robotronik/cdfr2018/Programmation/RobotrOvision/third_test/correct_highres.jpg

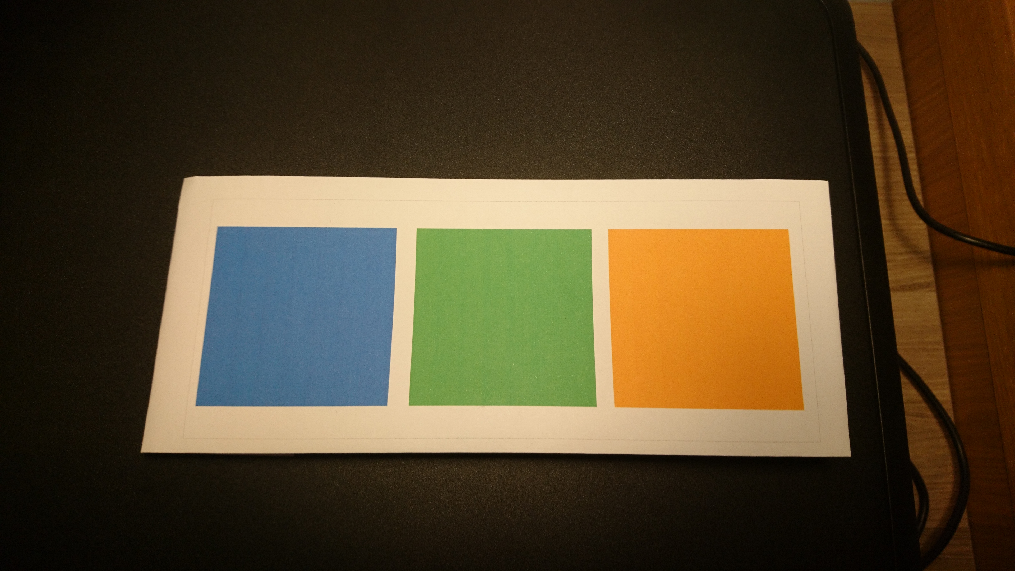
Programmation/RobotrOvision/third_test/correct_highres.jpg
