robotronik/cdfr2018/Programmation/RobotrOvision/third_test/incorrect_hd.jpg

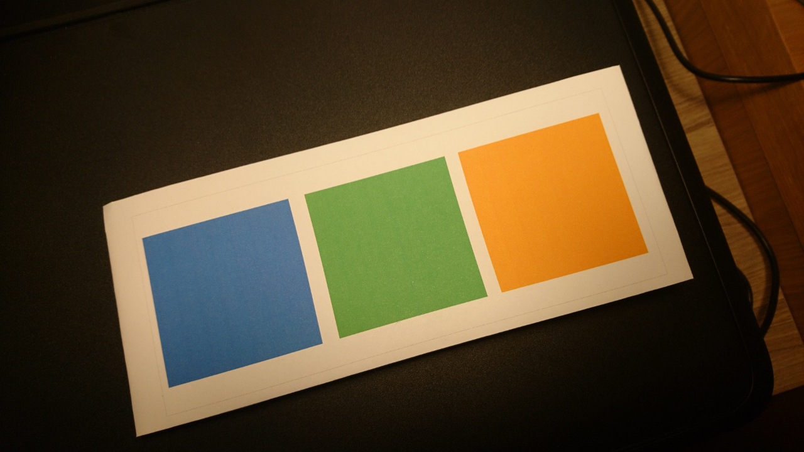
Programmation/RobotrOvision/third_test/incorrect_hd.jpg
