robotronik/cdfr2018/Programmation/Panneau_domotique/serveur/readme.md

Installation de l'ESP8266 sur l'IDE d'Arduino
---------------------------------------------

Dans Arduino > File > Preferences > Settings > Additional Boards Manager URLs, ajouter :
http://arduino.esp8266.com/stable/package_esp8266com_index.json

Puis ouvrir Tools > Board > Boards Manager
Chercher ESP8266 et installer esp8266 by ESP8266 Community

Enfin dans Tools > Board, sélectionner Generic ESP8266
