robotronik/cdfr2018/Programmation/Panneau_domotique/pixelbot/README.md

pixelbot
========

Pixelbot est un programme permettant de générer des sprites pour une 
matrice de leds, à partir d'une police de caractères.

Utilisation
-----------

1. Installer qt5
2. Lancer l'exécutable

Modification
------------

Pour compiler ou modifier le projet, il faut installer Qt Creator.
