robotronik/cdfr2018/Programmation/LED_Zone/graphic/background.jpg

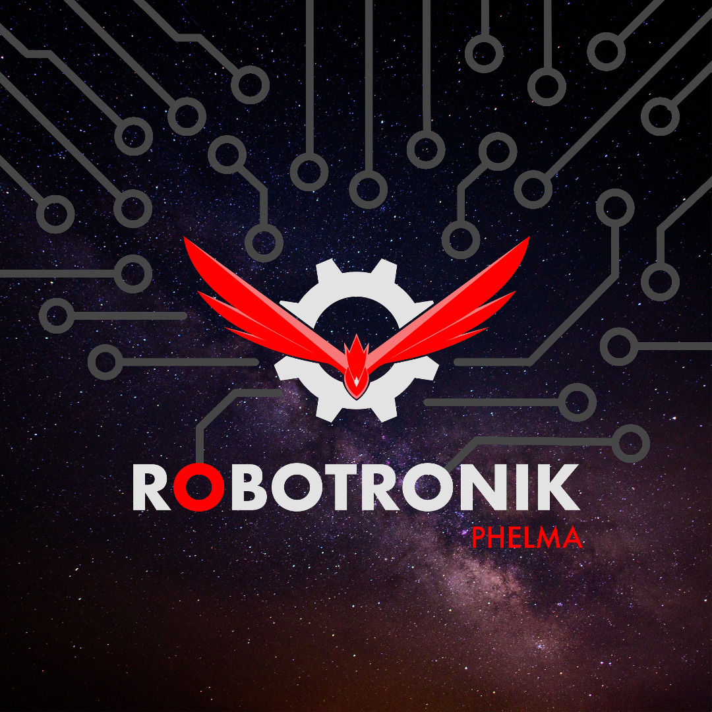
Programmation/LED_Zone/graphic/background.jpg
