robotronik/cdfr2018/Programmation/LED_Zone/graphic/tracks.png

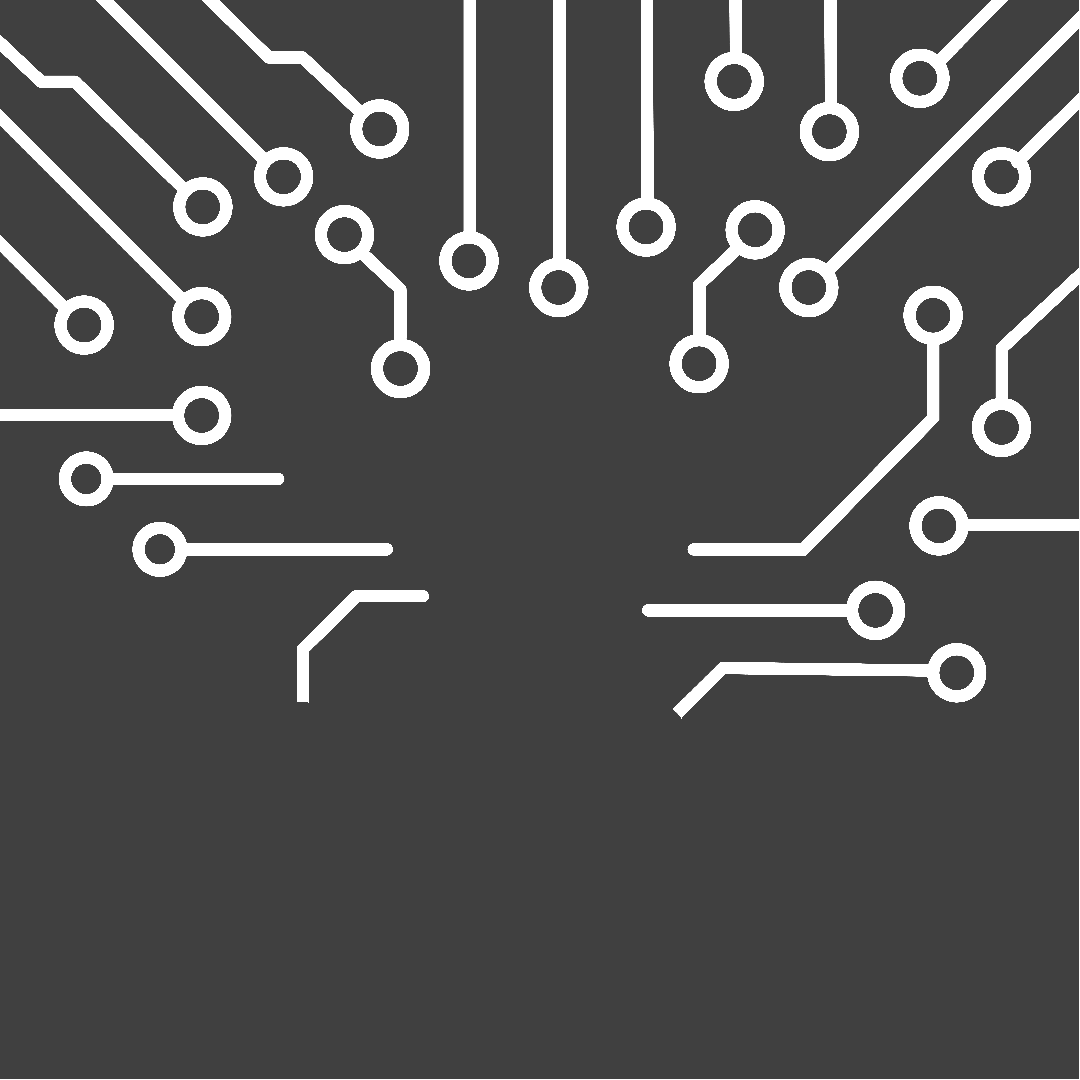
Programmation/LED_Zone/graphic/tracks.png
