robotronik/cdfr2018/Mecanique/Materiel_HPC.ods

qté | réf | description | url
4 | 10T5-15/ECO | poulie | https://shop.hpceurope.com/fr/produit.asp?prid=3936&lie=0&nav=3
4 | MET-3-6-4 | coussinets | https://shop.hpceurope.com/fr/produit.asp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
6 | METC-4-8-4 | coussinets | https://shop.hpceurope.com/fr/produit.asp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
1 | RSH030A | Arbre 3 | https://shop.hpceurope.com/fr/produit.asp?prid=1318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
1 | RSH040B | Arbre 4 | https://shop.hpceurope.com/fr/produit.asp?prid=1318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
2 | ZB0,8-20 | renvoi angle | https://shop.hpceurope.com/fr/produit.asp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
 |  | courroie
 | Q608 2rs | roulement
 |  | Arbre 8
