robotronik/cdfr2018/Mecanique/assemblage_global_avec_bras.fcstd

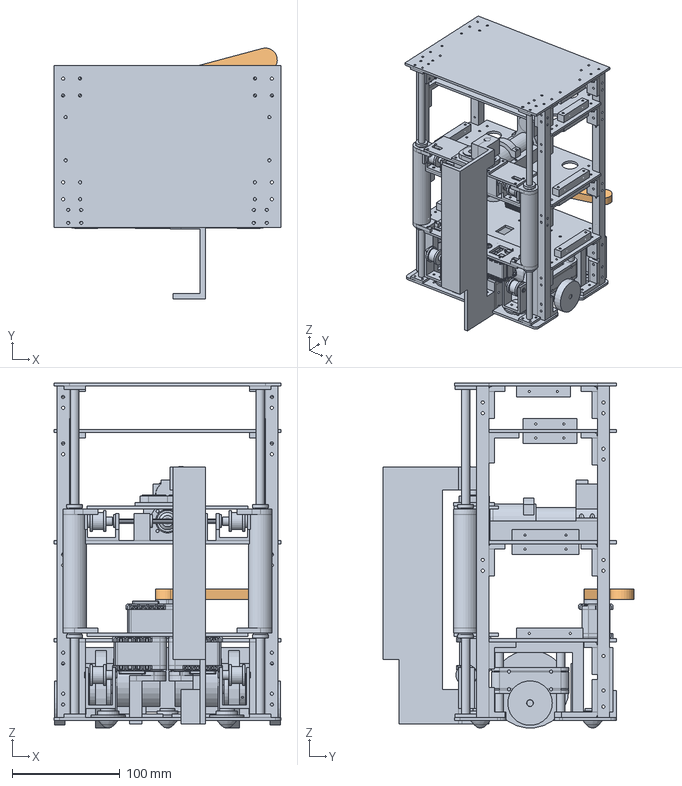
[picture p7: CAD file, 2018-02-14]
Mecanique/assemblage_global_avec_bras.fcstd
210.0 x 232.6 x 319.8 mm
assemblage_global_ne_pas_modifier_01
bras_01
