robotronik/cdfr2018/Mecanique/etage_elec/assemblage/assemblage_etage_elec.fcstd

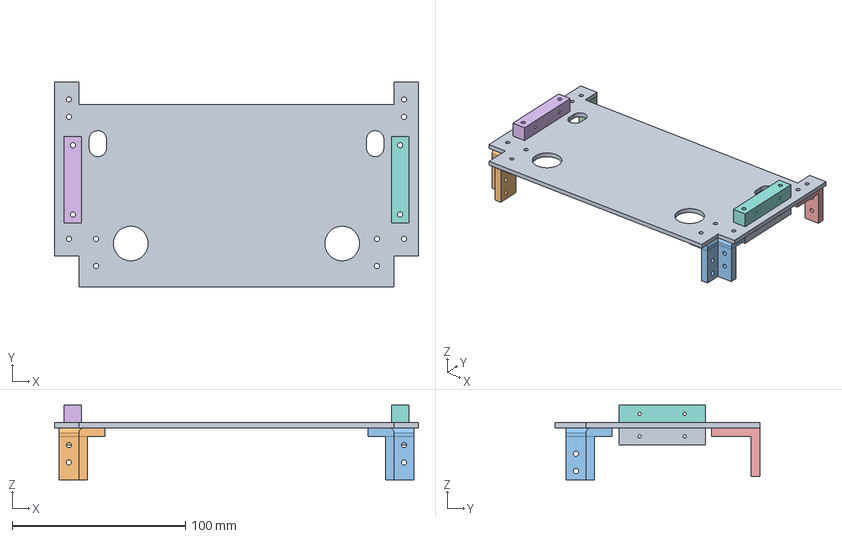
[picture p8: CAD file, 2017-11-16]
Mecanique/etage_elec/assemblage/assemblage_etage_elec.fcstd
210.0 x 118.1 x 43.0 mm
etage_elec_01
support_etage_1_01
support_etage_2_02
equerre_etage_elec_01
equerre_etage_elec_02
support_plexi_lateral_elec_01
support_plexi_lateral_elec_02
support_plexi_lateral_elec_03
support_plexi_lateral_elec_04
