robotronik/cdfr2018/Mecanique/toit/assemblage/assemblage_toit.fcstd

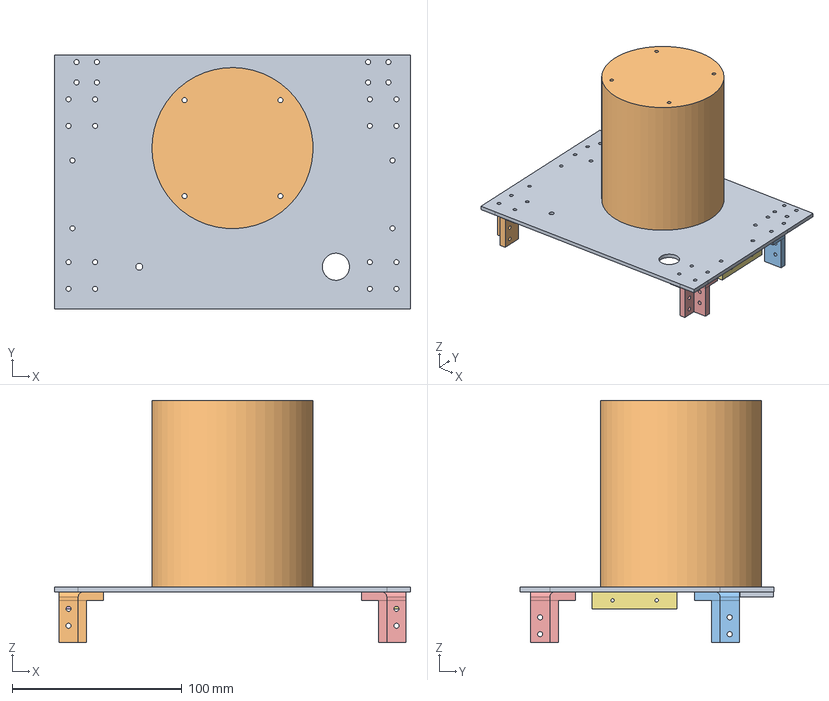
[picture p9: CAD file, 2018-01-14]
Mecanique/toit/assemblage/assemblage_toit.fcstd
210.0 x 150.0 x 143.0 mm
toit_01
support_etage_1_01
support_etage_1_02
support_etage_2_01
support_etage_2_02
support_plexi_lateral_elec_01
support_plexi_lateral_elec_02
calle_tige_01
calle_tige_01001
support_balise_01
