robotronik/cdfr2018/Mecanique/assemblage_global_ne_pas_modifier.fcstd

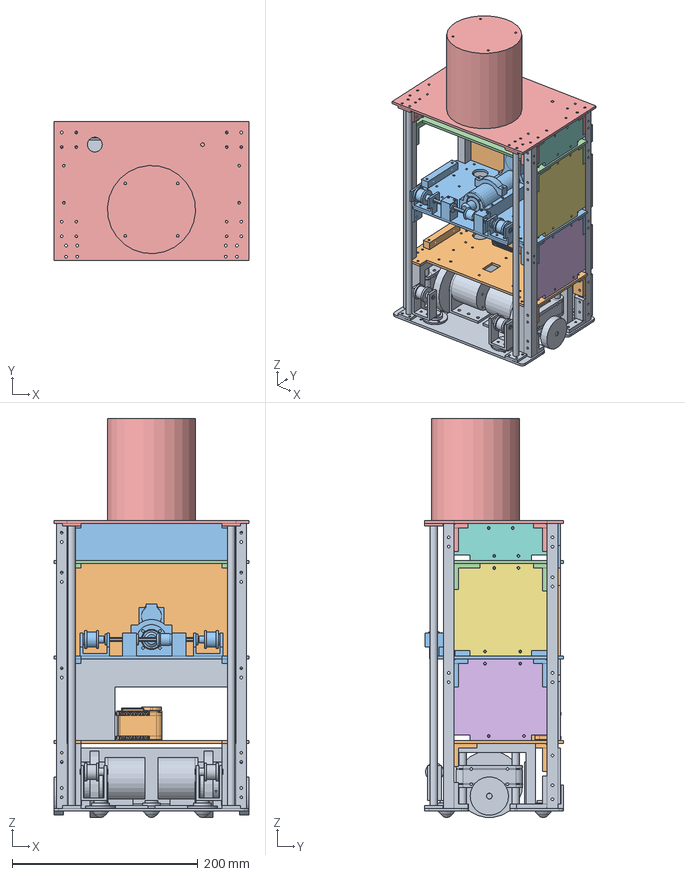
[picture p10: CAD file, 2018-01-15]
Mecanique/assemblage_global_ne_pas_modifier.fcstd
210.0 x 150.0 x 429.8 mm
base_roulante_01
_er_etage_01
etage_moteur_01
assemblage_etage_elec_01
assemblage_toit_01
lateral_1er_etage_01
lateral_moteur_01
lateral_elec_01
ar_1er_etage_01
ar_moteur_01
ar_elec_01
