robotronik/cdfr2018/Mecanique/Base/Assemblage/assemblage_poulie.fcstd

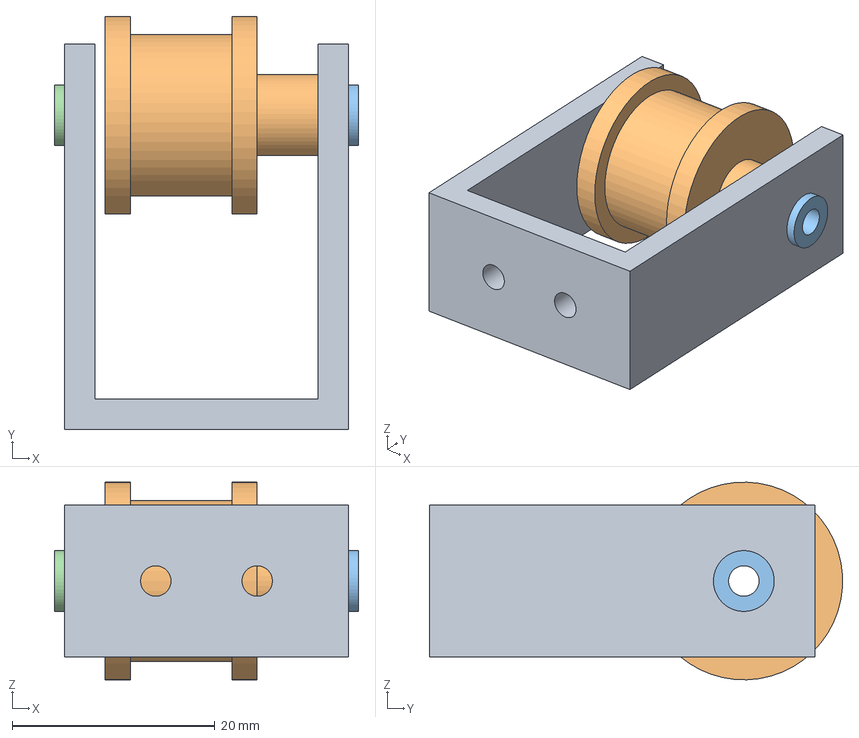
[picture p11: CAD file, 2017-11-04]
Mecanique/Base/Assemblage/assemblage_poulie.fcstd
30.0 x 40.7 x 19.5 mm
support_poulie_01
poulie_01
coussinet_3_01
coussinet_3_02
