robotronik/cdfr2018/Mecanique/etage_moteur/Assemblage/assemblage_moteur.fcstd

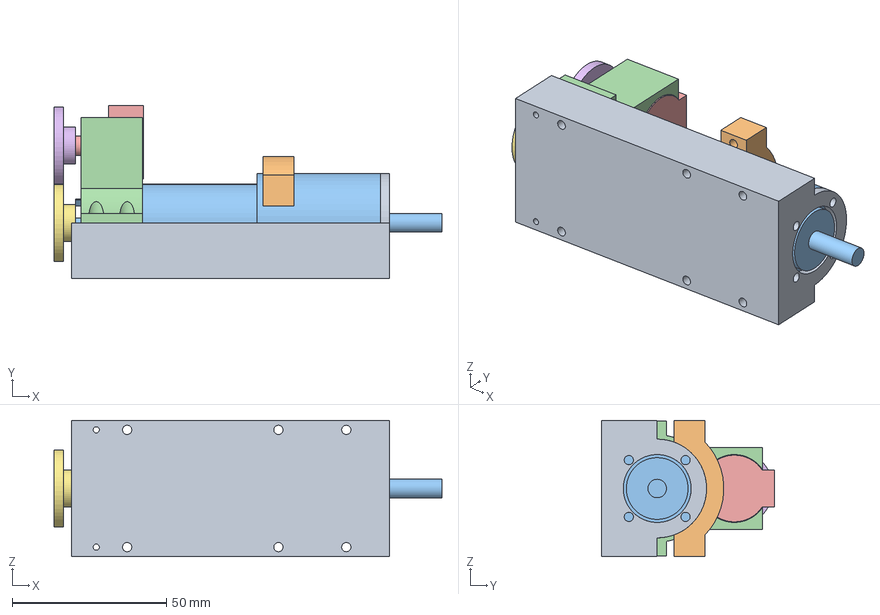
[picture p12: CAD file, 2017-11-12]
Mecanique/etage_moteur/Assemblage/assemblage_moteur.fcstd
125.7 x 56.0 x 44.1 mm
support_moteur_encodeur_01
bride_moteur_01
moteur_01
support_encodeur_01
encodeur_250_01
pignon_01
pignon_02
