robotronik/cdfr2018/Mecanique/Base/Assemblage/assemblage_bille.fcstd

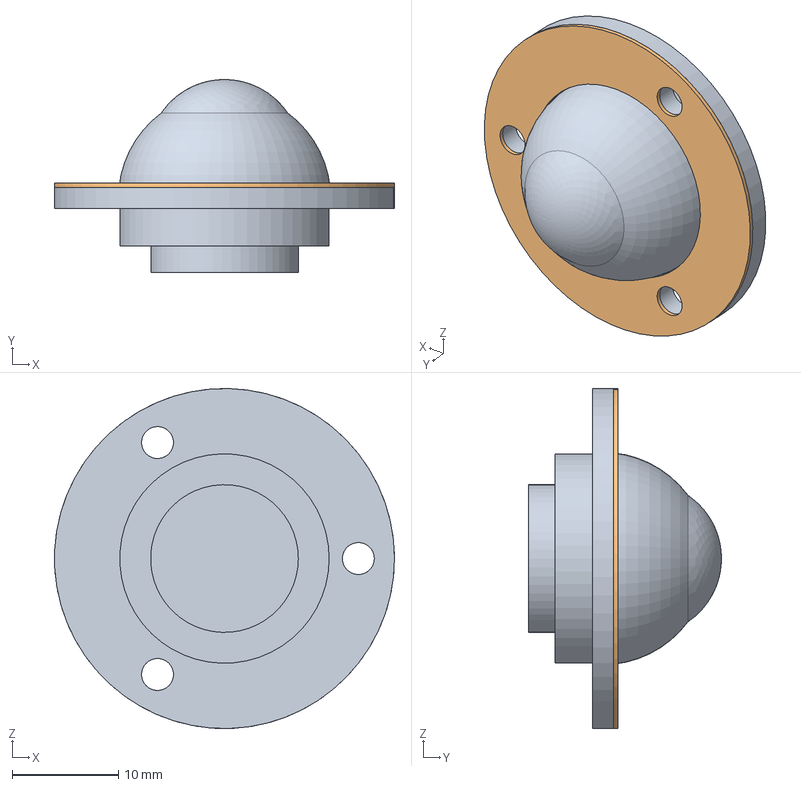
[picture p13: CAD file, 2017-10-30]
Mecanique/Base/Assemblage/assemblage_bille.fcstd
32.0 x 18.1 x 32.0 mm
bille_01
espaceur_bille_01
