robotronik/cdfr2018/Mecanique/etage_moteur/Assemblage/assemblage_support_coussinet.fcstd

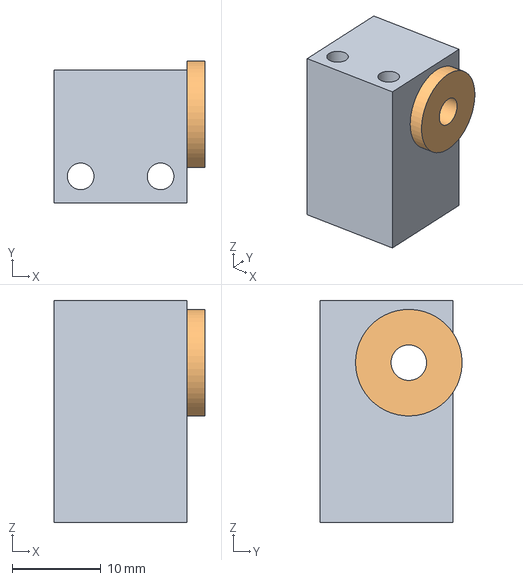
[picture p14: CAD file, 2017-11-07]
Mecanique/etage_moteur/Assemblage/assemblage_support_coussinet.fcstd
17.0 x 16.0 x 25.0 mm
support_coussinet_pignon_01
coussinet_01
