robotronik/cdfr2018/Mecanique/pince/assemblage_pince.fcstd

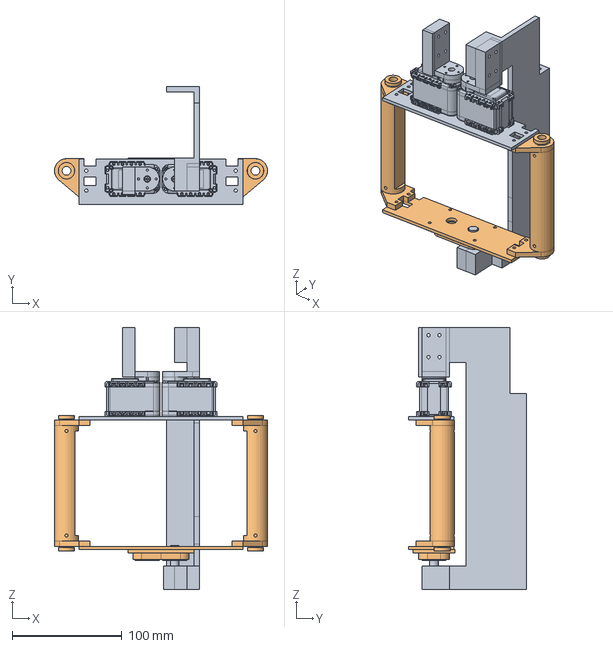
[picture p15: CAD file, 2017-12-31]
Mecanique/pince/assemblage_pince.fcstd
194.0 x 107.0 x 238.5 mm
ass_pince_bas_01
ass_pince_haut_01
