robotronik/cdfr2018/Mecanique/assemblage_global.fcstd

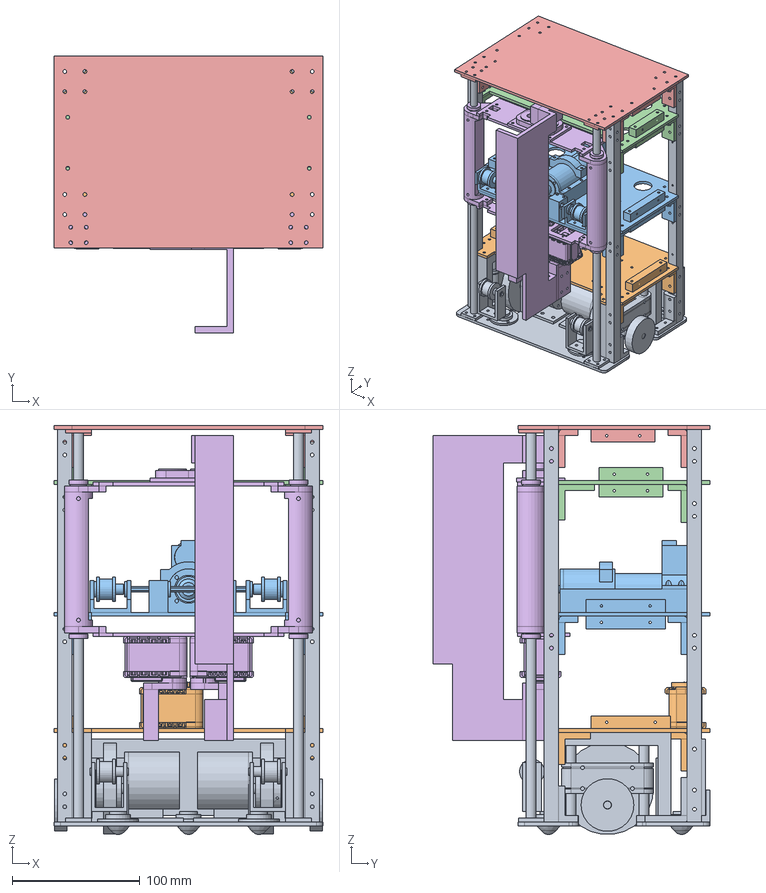
[picture p16: CAD file, 2017-12-31]
Mecanique/assemblage_global.fcstd
210.0 x 216.2 x 319.8 mm
base_roulante_01
_er_etage_01
etage_moteur_01
assemblage_etage_elec_01
assemblage_toit_01
assemblage_pince_01
