robotronik/cdfr2018/Mecanique/Base/Assemblage/assemblage_moteur.fcstd

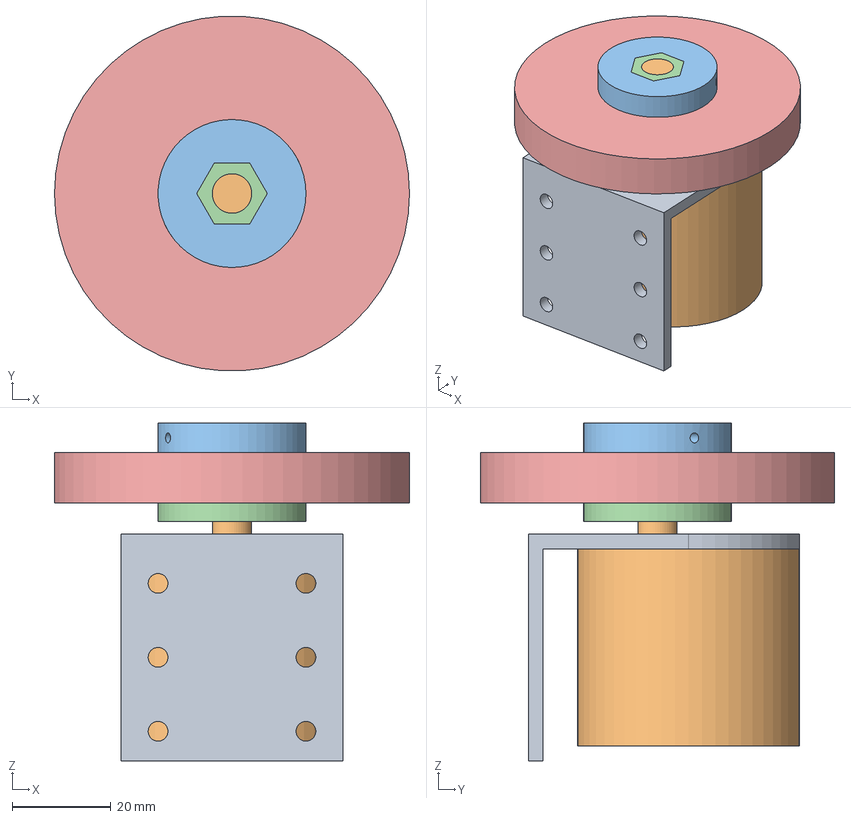
[picture p17: CAD file, 2017-10-29]
Mecanique/Base/Assemblage/assemblage_moteur.fcstd
72.0 x 71.9 x 68.5 mm
support_moteur_01
moteur_b_01
couplage_roue_2_01
couplage_roue_01
roue_bleue_01
