robotronik/cdfr2018/Mecanique/1er_etage/1er_etage.fcstd

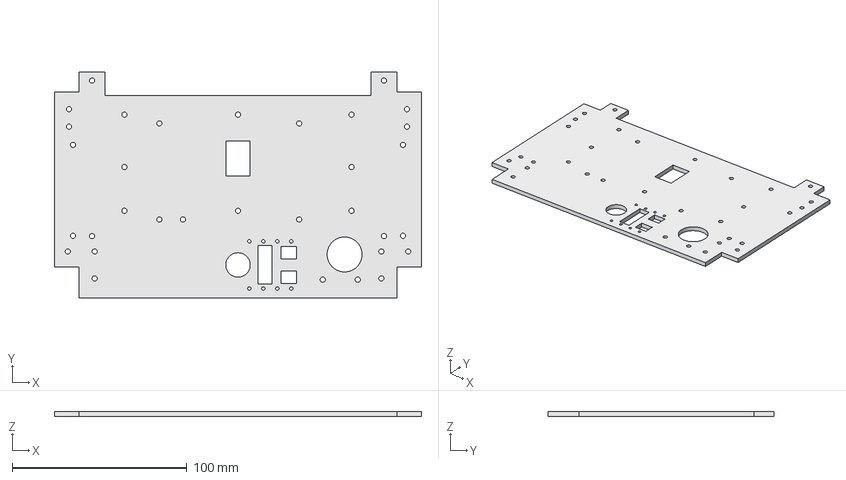
[picture p18: CAD file, 2018-01-14]
Mecanique/1er_etage/1er_etage.fcstd
210.0 x 129.5 x 3.00 mm
