robotronik/cdfr2018/Mecanique/1er_etage/Assemblage/1er_etage.fcstd

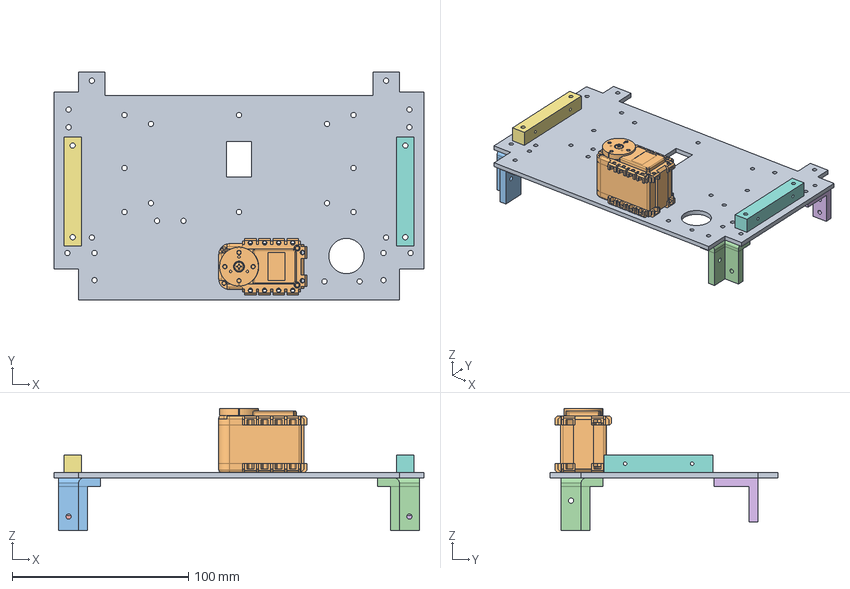
[picture p19: CAD file, 2017-12-15]
Mecanique/1er_etage/Assemblage/1er_etage.fcstd
210.0 x 129.5 x 69.4 mm
_er_etage_01
comp_ax12_01
support_profiles_ar_1_01
support_profiles_ar_2_01
support_profiles_av_01
support_profiles_av_02
support_plexi_lateral_01
support_plexi_lateral_02
