robotronik/cdfr2018/Mecanique/Abeille/Assemblage/abeille.fcstd

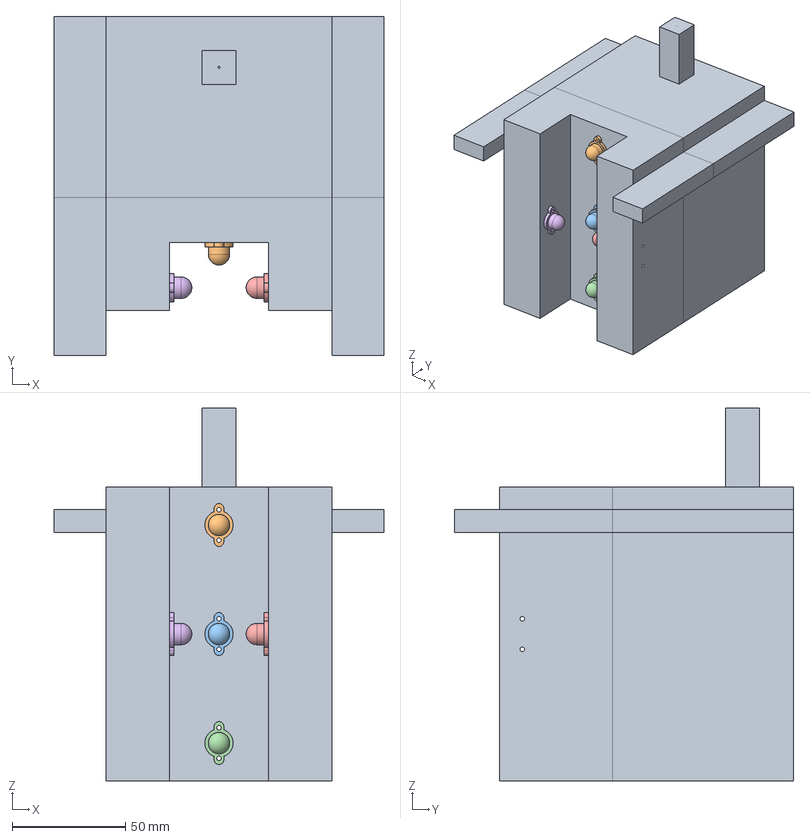
[picture p20: CAD file, 2018-01-13]
Mecanique/Abeille/Assemblage/abeille.fcstd
146.0 x 150.0 x 165.0 mm
structure_abeille_01
bille_01
bille_02
bille_03
bille_04
bille_05
