robotronik/cdfr2018/Mecanique/Abeille/structure_abeille_bas.fcstd

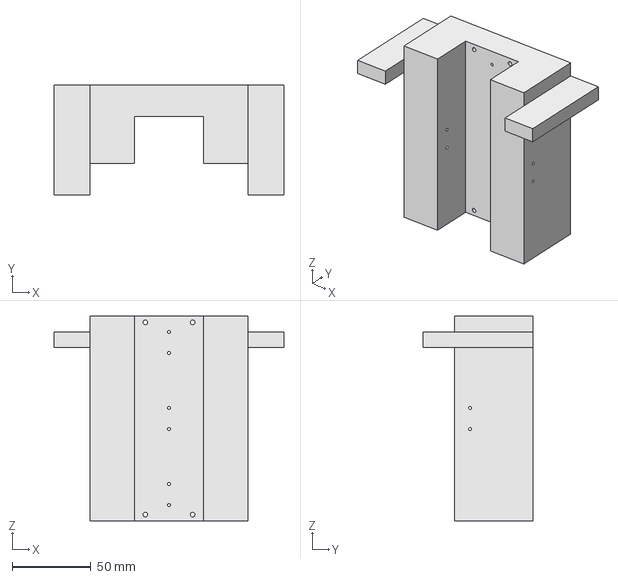
[picture p21: CAD file, 2018-02-28]
Mecanique/Abeille/structure_abeille_bas.fcstd
146.0 x 70.0 x 130.0 mm
