robotronik/cdfr2018/Mecanique/Adaptateur/4vers6.fcstd

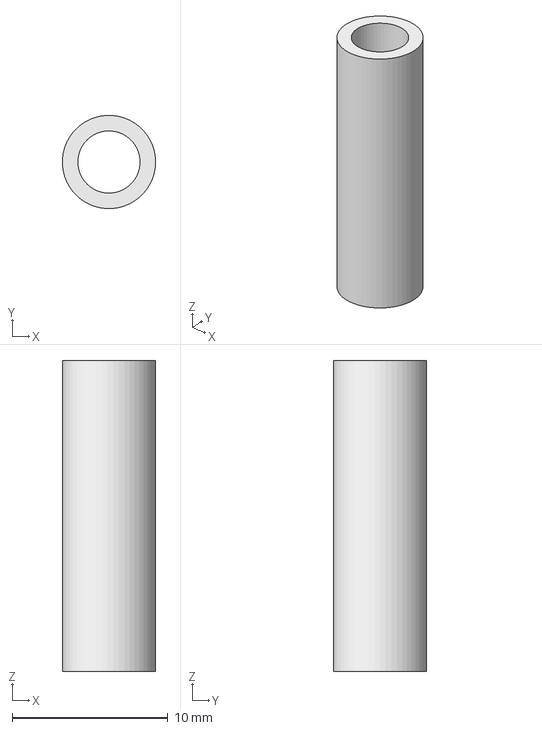
[picture p22: CAD file, 2018-01-14]
Mecanique/Adaptateur/4vers6.fcstd
5.99 x 6.00 x 20.0 mm
