robotronik/cdfr2018/Mecanique/ax12/AX-12A.STEP

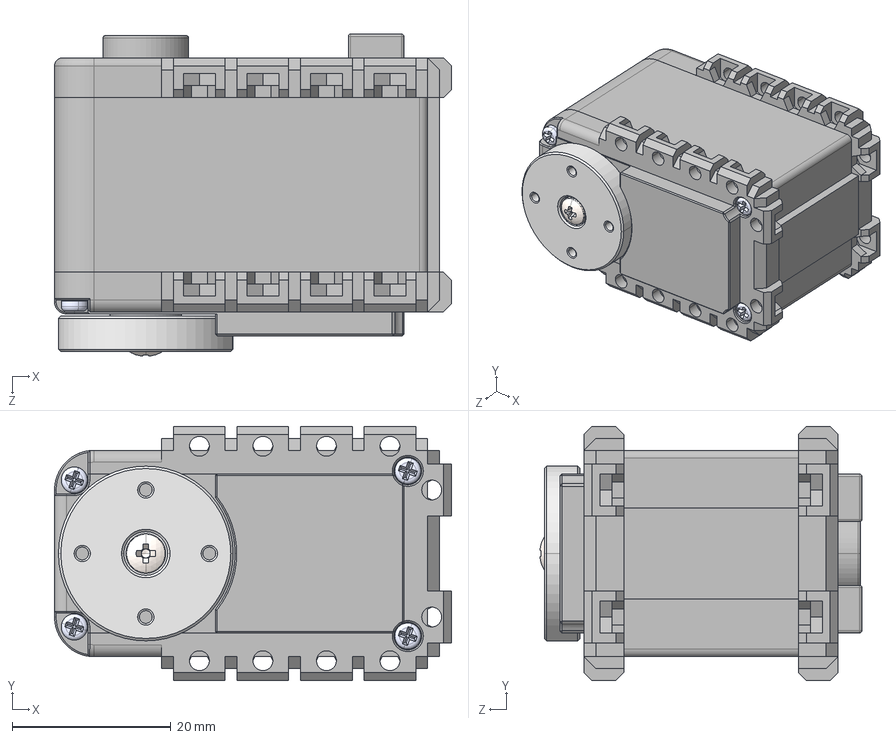
[picture p23: CAD file, 2017-10-31]
Mecanique/ax12/AX-12A.STEP
50.0 x 32.0 x 40.5 mm
AX-12A-01
AX-12A-02
AX-12A-03
AX-12A-04
SetScrew x 4
pan head cross recess screw_iso_ISO 7045 - M2.5 x 8 - Z --- 8C
