robotronik/cdfr2018/Mecanique/Base/Assemblage/base_roulante.fcstd

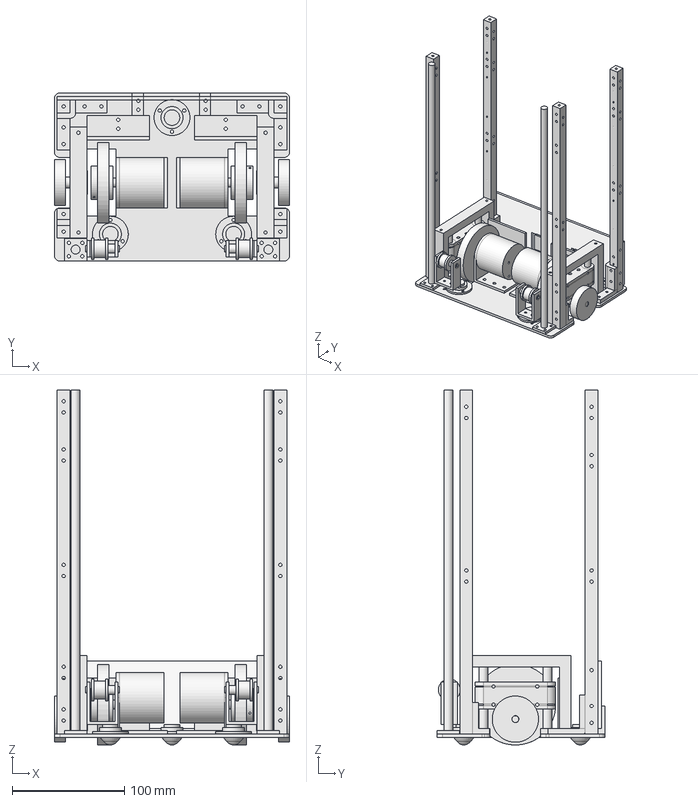
[picture p24: CAD file, 2017-11-16]
Mecanique/Base/Assemblage/base_roulante.fcstd
210.0 x 150.0 x 316.8 mm
base_01
assemblage_moteur_01
assemblage_moteur_02
odometre_01
odometre_02
assemblage_bille_01
profile_ar_1_01
profile_ar_2_01
support_batterie_01
support_batterie_02
support_batterie_2_01
support_batterie_2_02
calle_tige_01
tige_pince_01
calle_tige_01001
tige_pince_02
profile_av_01
profile_av_02
bouclier_batterie_01
assemblage_bille_02
assemblage_bille_03
assemblage_poulie_01
assemblage_poulie_02
