robotronik/cdfr2018/Mecanique/Base/couplage_roue_modif.fcstd

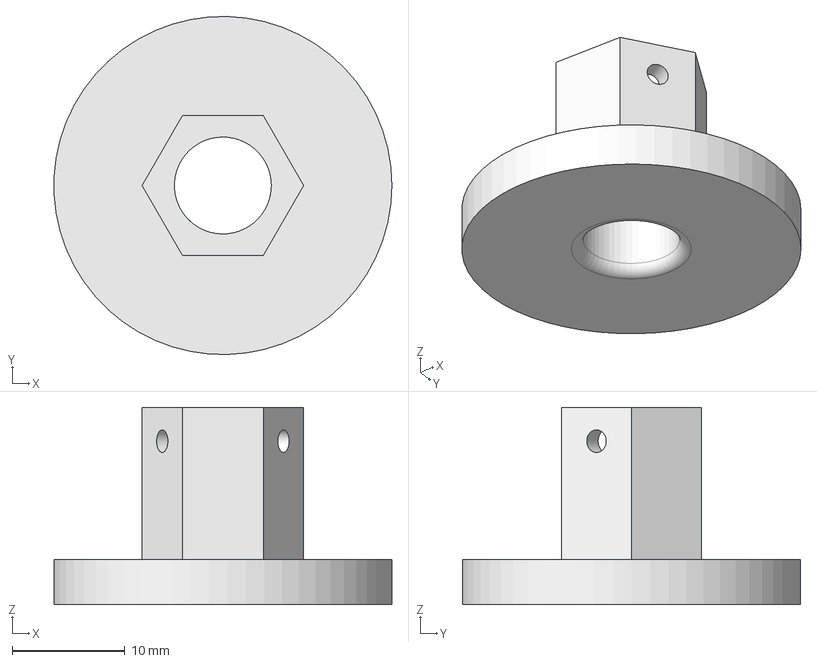
[picture p25: CAD file, 2018-01-22]
Mecanique/Base/couplage_roue_modif.fcstd
30.0 x 30.0 x 17.5 mm
