robotronik/cdfr2018/Mecanique/Base/Odometrie/barre_encodeur_modif2.fcstd

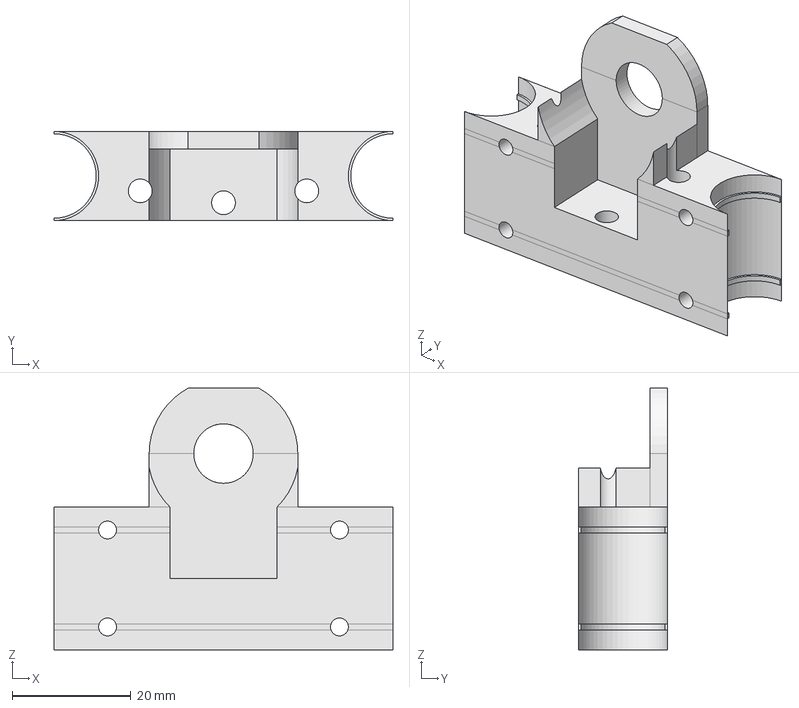
[picture p26: CAD file, 2017-12-19]
Mecanique/Base/Odometrie/barre_encodeur_modif2.fcstd
57.0 x 15.0 x 44.0 mm
