robotronik/cdfr2018/Mecanique/Base/Profiles/Assemblage/profile_ar_2.fcstd

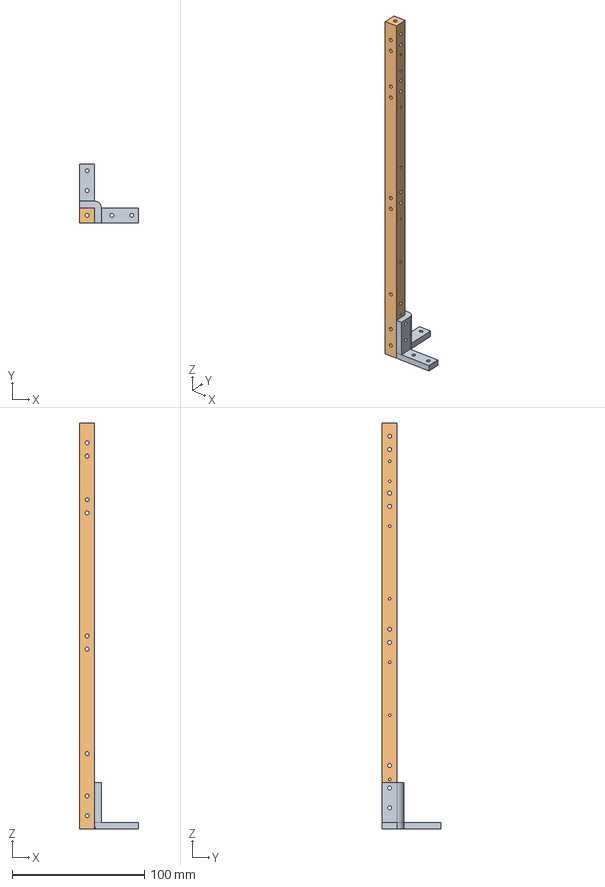
[picture p27: CAD file, 2017-11-16]
Mecanique/Base/Profiles/Assemblage/profile_ar_2.fcstd
44.4 x 44.4 x 307.0 mm
support_bas_ar_p_2_01
Profile_AR_01
