robotronik/cdfr2018/Mecanique/Base/Profiles/Profile_AR.fcstd

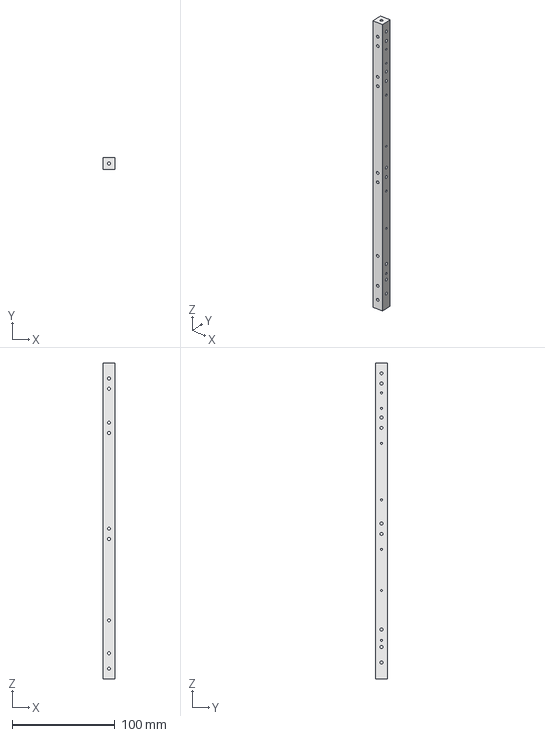
[picture p28: CAD file, 2017-11-16]
Mecanique/Base/Profiles/Profile_AR.fcstd
11.4 x 11.4 x 307.0 mm
