robotronik/cdfr2018/Mecanique/Bras_abeille_panneau/bras_grand.fcstd

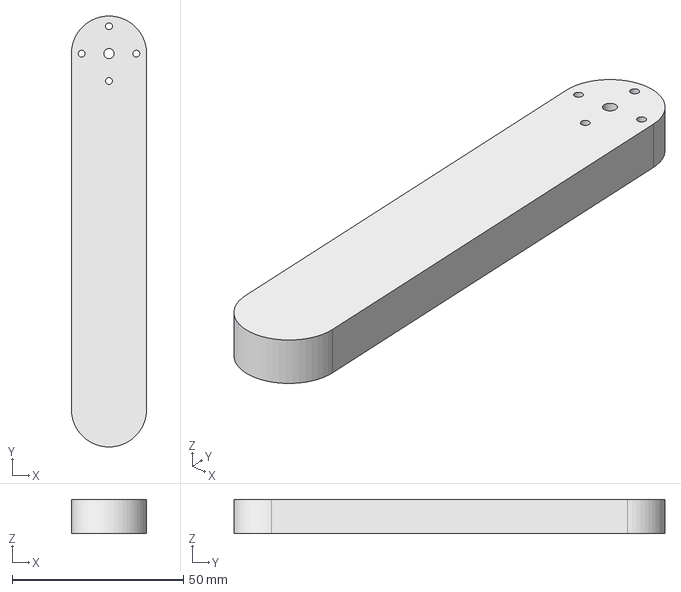
[picture p29: CAD file, 2018-01-13]
Mecanique/Bras_abeille_panneau/bras_grand.fcstd
22.0 x 126.0 x 10.0 mm
