robotronik/cdfr2018/Mecanique/Capteurs/encodeur_236.fcstd

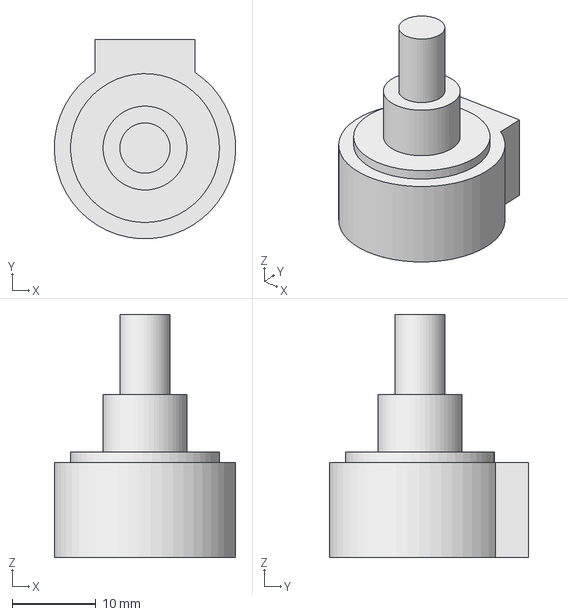
[picture p30: CAD file, 2017-10-29]
Mecanique/Capteurs/encodeur_236.fcstd
21.6 x 23.7 x 29.0 mm
