robotronik/cdfr2018/Mecanique/Douilles/douille_a_bille.fcstd

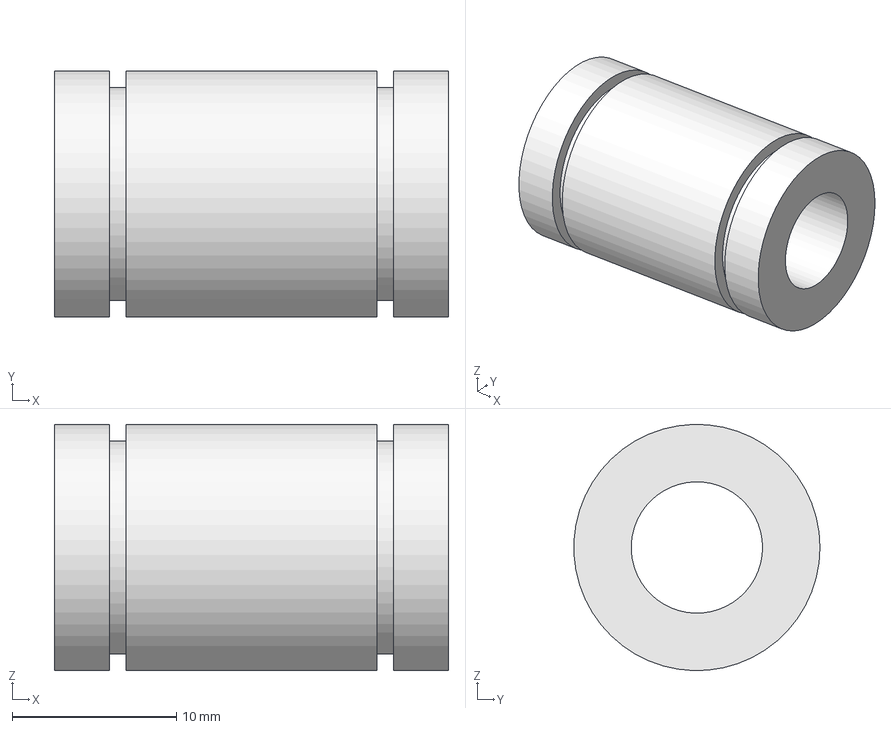
[picture p31: CAD file, 2017-10-24]
Mecanique/Douilles/douille_a_bille.fcstd
24.0 x 15.0 x 15.0 mm
