robotronik/cdfr2018/Mecanique/etage_elec/etage_elec.fcstd

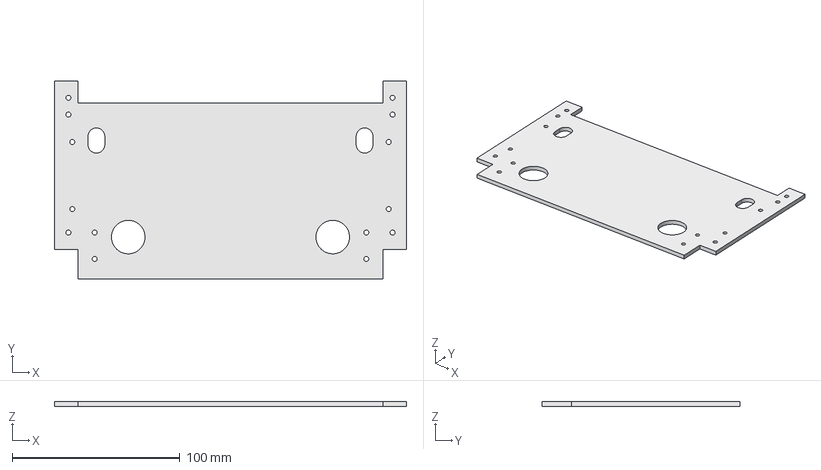
[picture p32: CAD file, 2018-01-14]
Mecanique/etage_elec/etage_elec.fcstd
210.0 x 118.1 x 3.00 mm
