robotronik/cdfr2018/Mecanique/etage_moteur/Assemblage/etage_moteur.fcstd

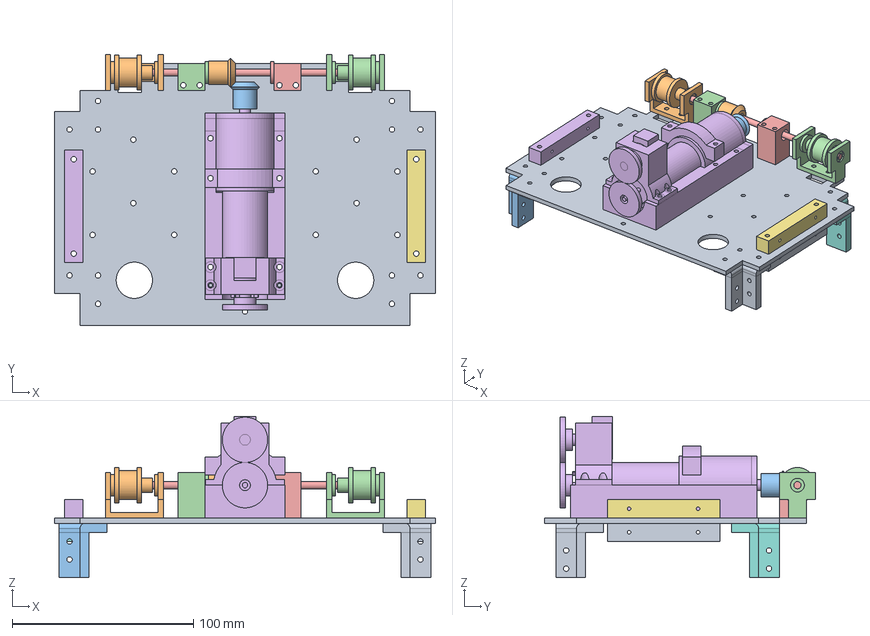
[picture p33: CAD file, 2017-11-16]
Mecanique/etage_moteur/Assemblage/etage_moteur.fcstd
210.0 x 149.5 x 89.0 mm
etage_moteur_01
poulie_haut_02
support_etage_1_01
poulie_haut_01
axe_poulies_01
assemblage_moteur_01
support_etage_2_01
support_etage_1_02
support_etage_2_02
pignon_conique_01
pignon_conique_02
assemblage_support_coussinet_01
assemblage_support_coussinet_2_01
support_plexi_lateral_01
support_plexi_lateral_02
support_plexi_lateral_03
support_plexi_lateral_04
