robotronik/cdfr2018/Mecanique/etage_moteur/support_coussinet_pignon.fcstd

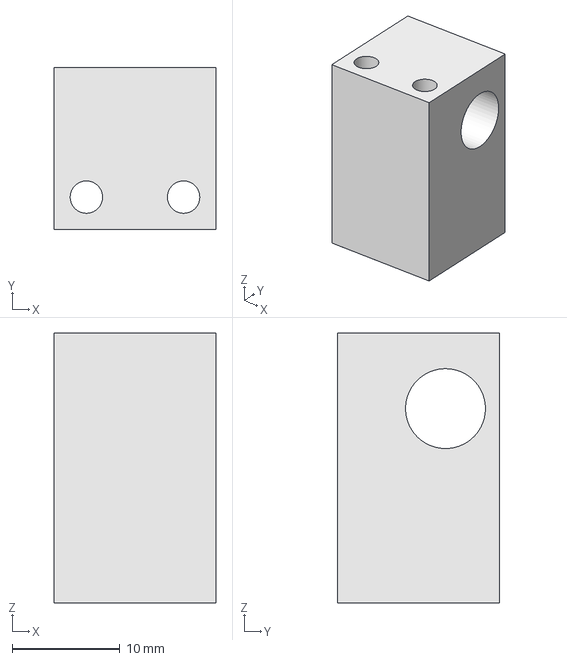
[picture p34: CAD file, 2018-01-14]
Mecanique/etage_moteur/support_coussinet_pignon.fcstd
15.0 x 15.0 x 25.0 mm
