robotronik/cdfr2018/Mecanique/Panneau/Assemblage/boitier.fcstd

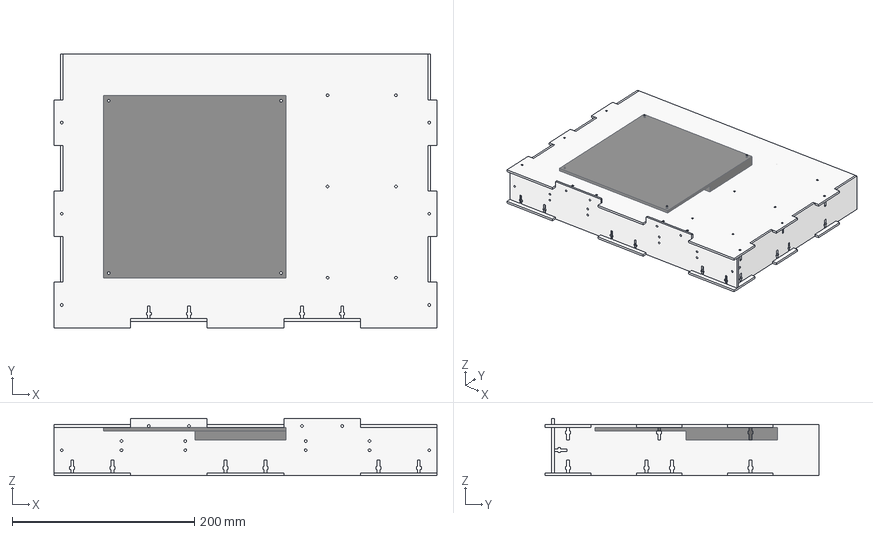
[picture p35: CAD file, 2018-01-12]
Mecanique/Panneau/Assemblage/boitier.fcstd
420.0 x 300.0 x 63.0 mm
plaque_ar_01
fond_01
plaque_av_01
plaques_laterales_01
plaques_laterales_02
matrice_led_01
