robotronik/cdfr2018/Mecanique/Panneau/fond.fcstd

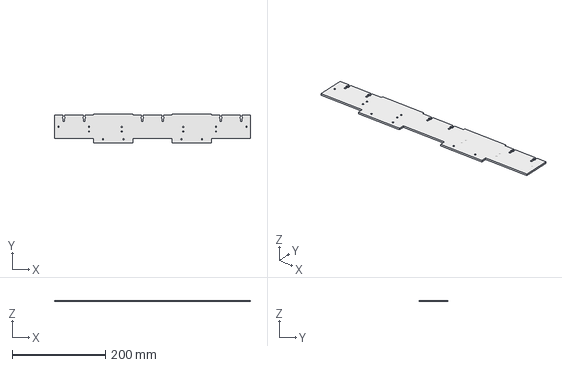
[picture p36: CAD file, 2018-01-14]
Mecanique/Panneau/fond.fcstd
420.0 x 63.0 x 3.00 mm
