robotronik/cdfr2018/Mecanique/Pieces_alu/plans/support_poulie_moteur.dxf

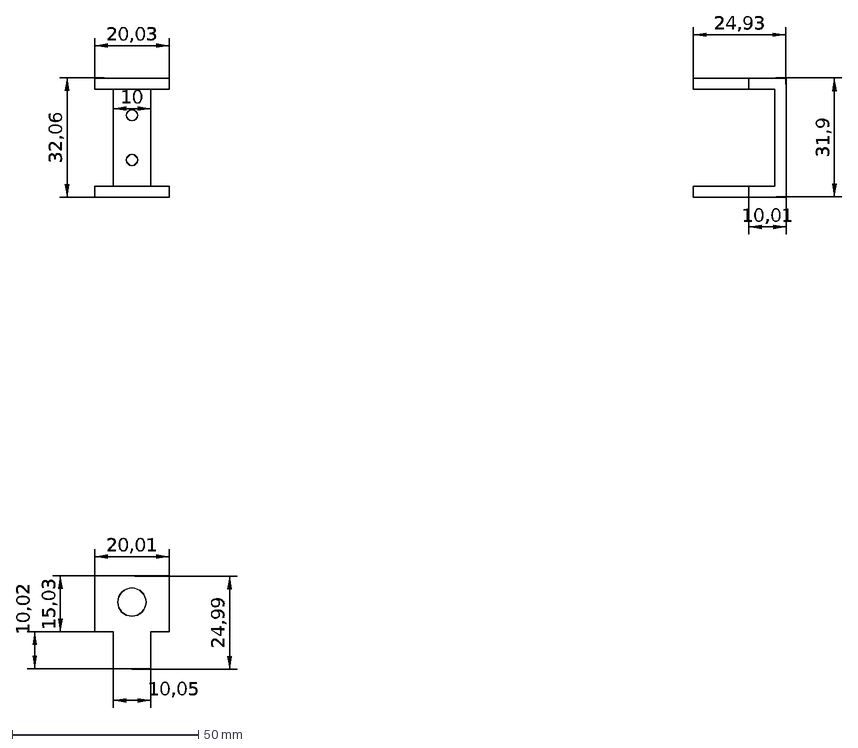
[picture p37: CAD file, 2017-12-11]
Mecanique/Pieces_alu/plans/support_poulie_moteur.dxf
20,03
10
32,06
31,9
24,99
20,01
10,05
24,93
10,01
15,03
10,02
