robotronik/cdfr2018/Mecanique/Pieces_alu/STEP/etage_moteur.step

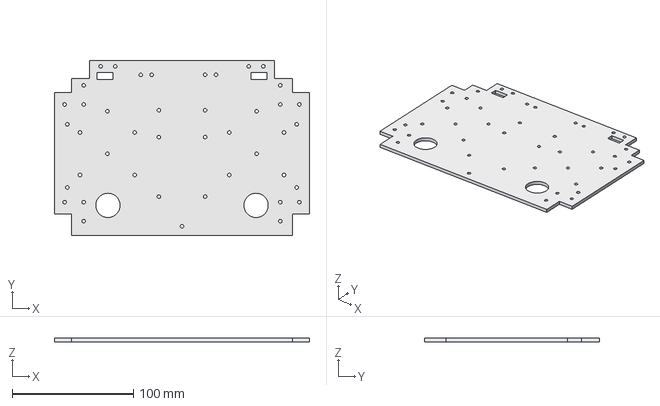
[picture p38: CAD file, 2017-11-28]
Mecanique/Pieces_alu/STEP/etage_moteur.step
210.0 x 144.5 x 3.00 mm
