robotronik/cdfr2018/Mecanique/Pieces_alu/support_pouli.dxf

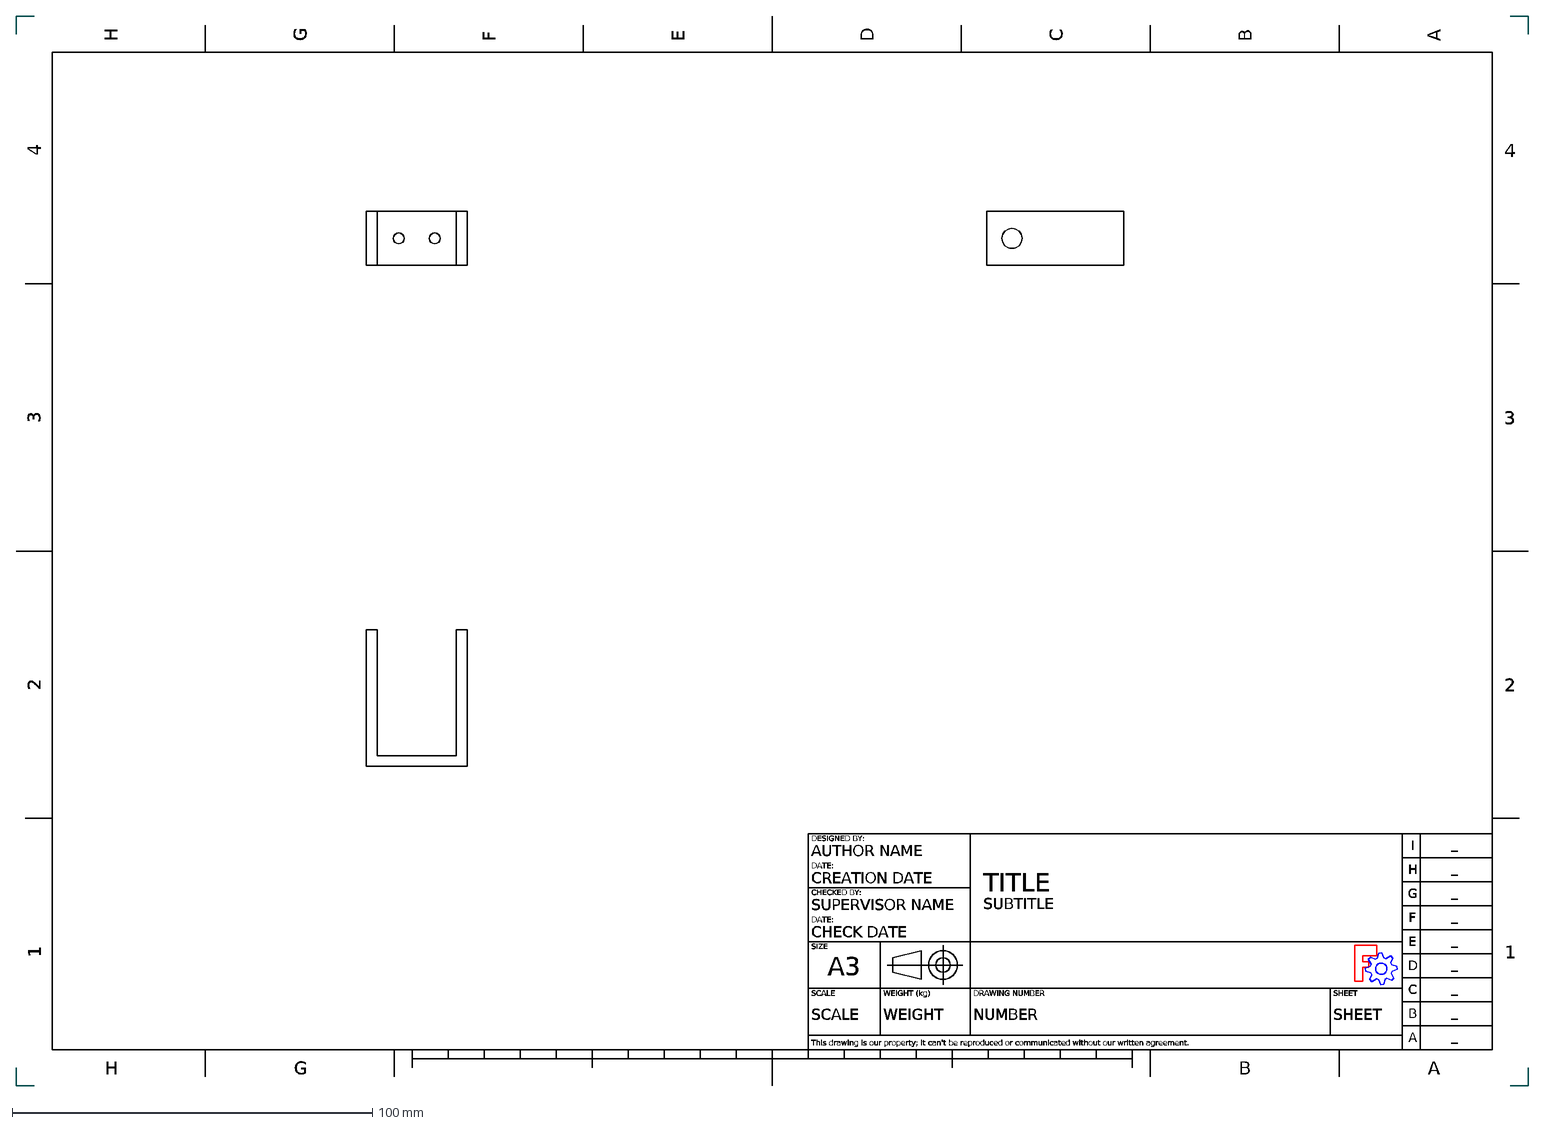
[picture p39: CAD file, 2017-11-28]
Mecanique/Pieces_alu/support_pouli.dxf
1
2
3
4
A
B
G
H
F
E
D
C
I
SHEET
DRAWING NUMBER
WEIGHT (kg)
SCALE
SIZE
DATE:
CHECKED BY:
DESIGNED BY:
This drawing is our property; it can't be reproduced or communicated without our written agreement.
AUTHOR NAME
CREATION DATE
CHECK DATE
SUPERVISOR NAME
WEIGHT
NUMBER
SUBTITLE
A3
_
TITLE
