robotronik/cdfr2018/Mecanique/pince/top_plexi_pince.fcstd

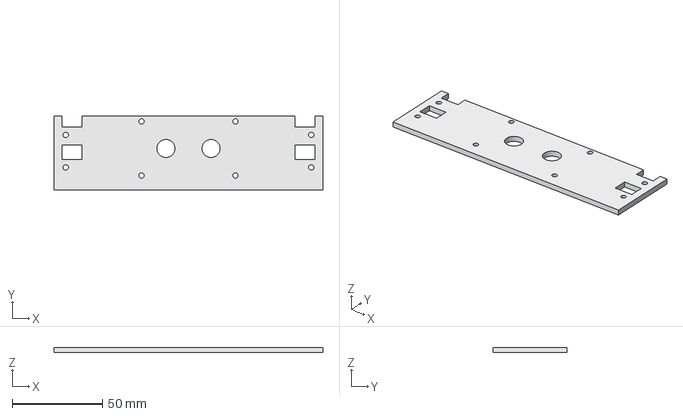
[picture p40: CAD file, 2018-01-14]
Mecanique/pince/top_plexi_pince.fcstd
149.0 x 41.0 x 3.00 mm
