robotronik/cdfr2018/Mecanique/plexi_ext/lateral_moteur.fcstd

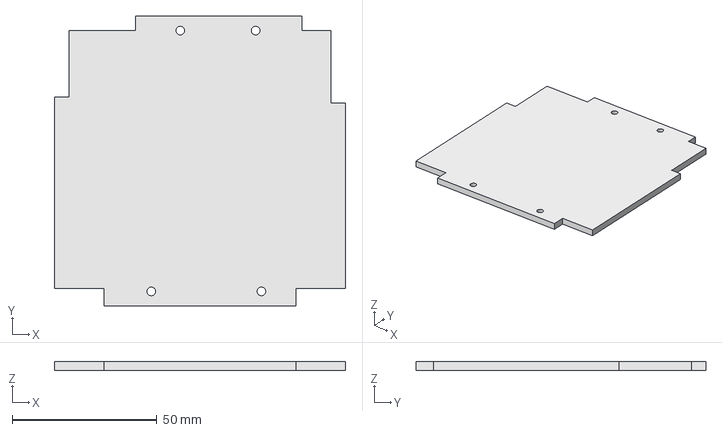
[picture p41: CAD file, 2018-01-15]
Mecanique/plexi_ext/lateral_moteur.fcstd
100.4 x 100.0 x 3.00 mm
