robotronik/cdfr2018/Mecanique/Support_capteurs/TOF.fcstd

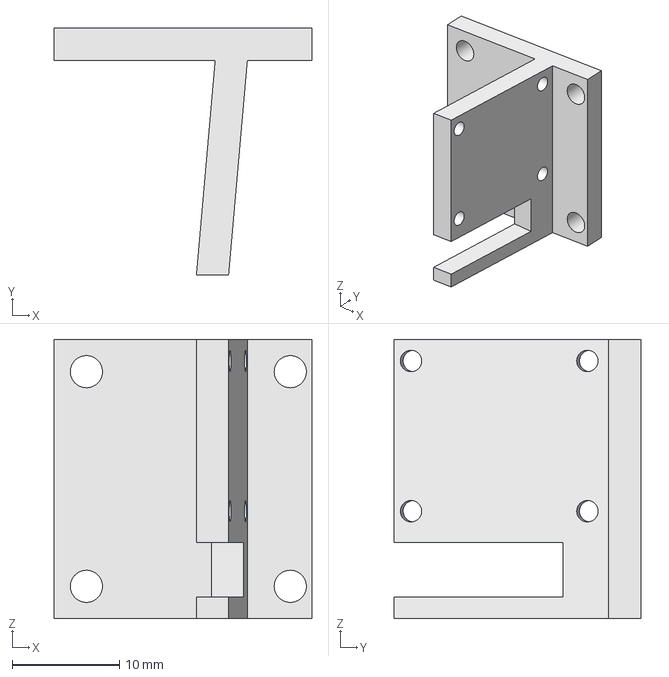
[picture p42: CAD file, 2018-02-14]
Mecanique/Support_capteurs/TOF.fcstd
24.0 x 23.0 x 26.0 mm
