robotronik/cdfr2018/Mecanique/support_plexi/support_plexi_lateral.fcstd

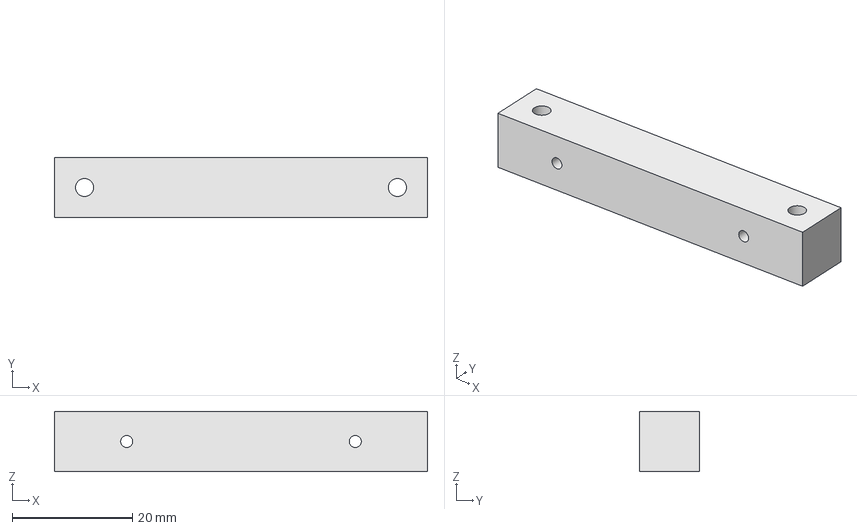
[picture p43: CAD file, 2017-11-16]
Mecanique/support_plexi/support_plexi_lateral.fcstd
62.0 x 10.0 x 10.0 mm
