robotronik/cdfr2018/Mecanique/toit/support_balise_haut.fcstd

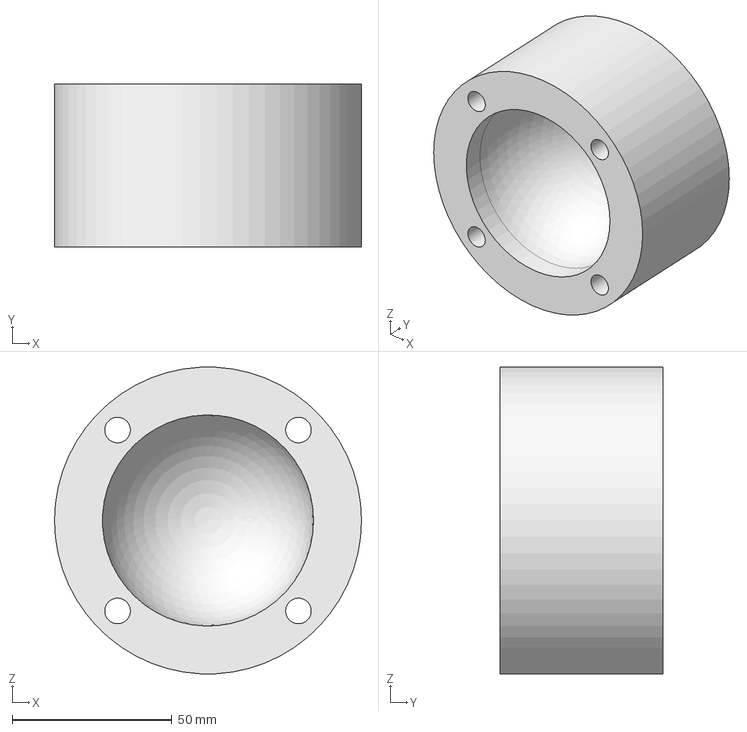
[picture p44: CAD file, 2018-04-23]
Mecanique/toit/support_balise_haut.fcstd
96.0 x 51.0 x 95.9 mm
