robotronik/cdfr2018/Mecanique/1er_etage/support_profiles_av.fcstd

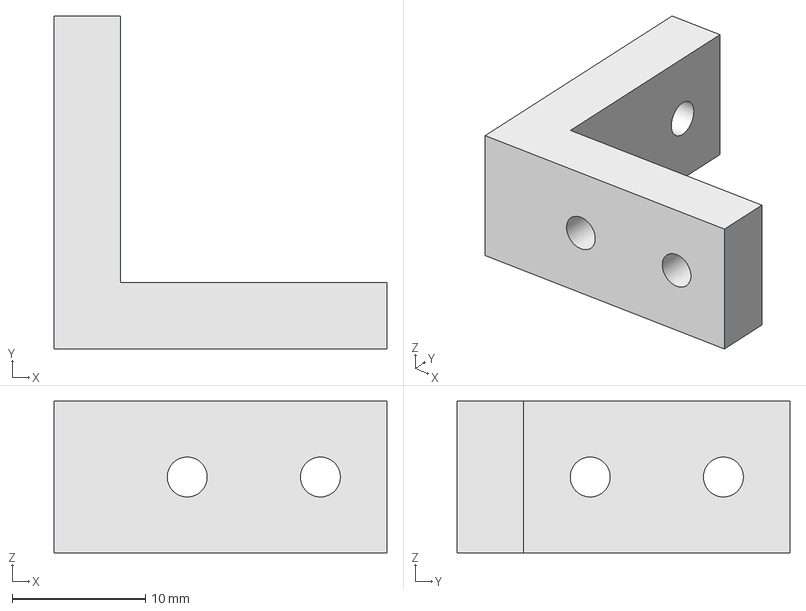
[picture p45: CAD file, 2017-11-01]
Mecanique/1er_etage/support_profiles_av.fcstd
25.0 x 25.0 x 11.4 mm
