robotronik/cdfr2018/Mecanique/Abeille/structure_abeille_haut.fcstd

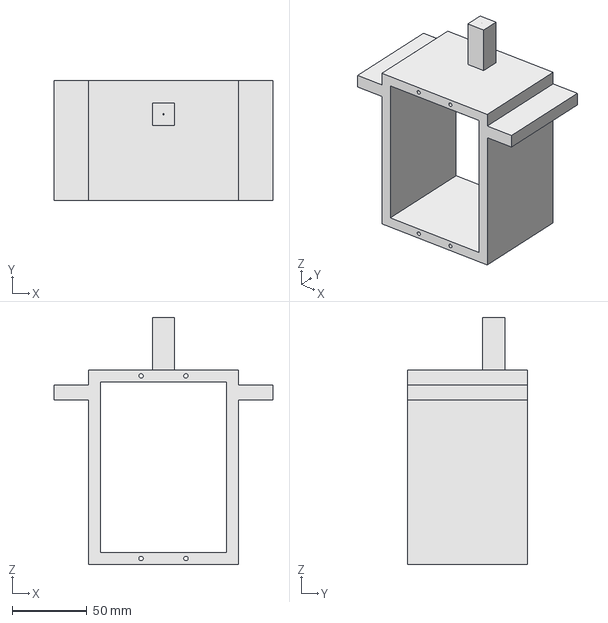
[picture p46: CAD file, 2018-02-28]
Mecanique/Abeille/structure_abeille_haut.fcstd
146.0 x 80.0 x 165.0 mm
