robotronik/cdfr2018/Mecanique/Adaptateur/3vers6.fcstd

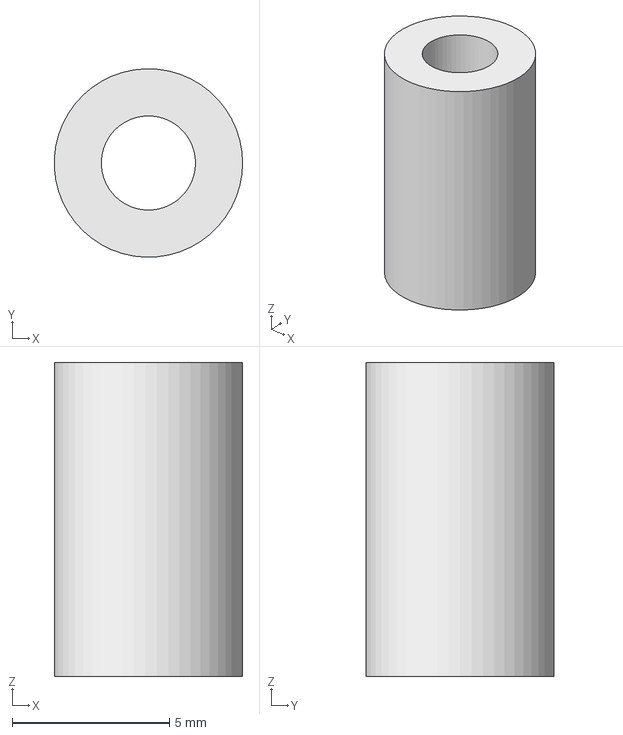
[picture p47: CAD file, 2018-01-14]
Mecanique/Adaptateur/3vers6.fcstd
5.99 x 6.00 x 10.0 mm
