robotronik/cdfr2018/Mecanique/ax12/ax12.fcstd

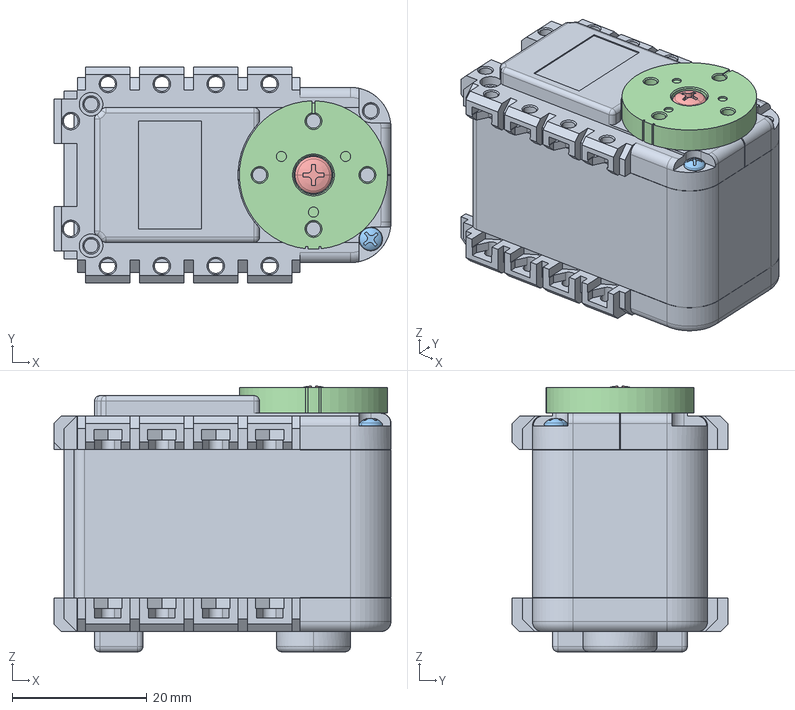
[picture p48: CAD file, 2017-10-31]
Mecanique/ax12/ax12.fcstd
50.0 x 32.0 x 39.4 mm
PRT0001
PRT0002
PRT0003
PRT0010
PRT0011
