robotronik/cdfr2018/Mecanique/Base/bouclier_batterie.fcstd

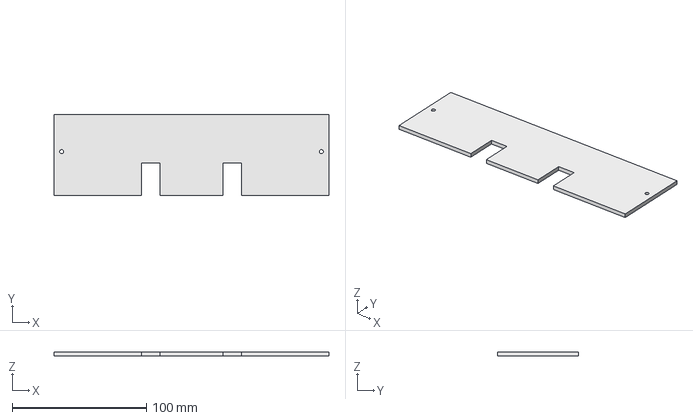
[picture p49: CAD file, 2018-01-14]
Mecanique/Base/bouclier_batterie.fcstd
204.8 x 60.0 x 3.00 mm
