robotronik/cdfr2018/Mecanique/Base/Odometrie/Assemblage/barre_bille.fcstd

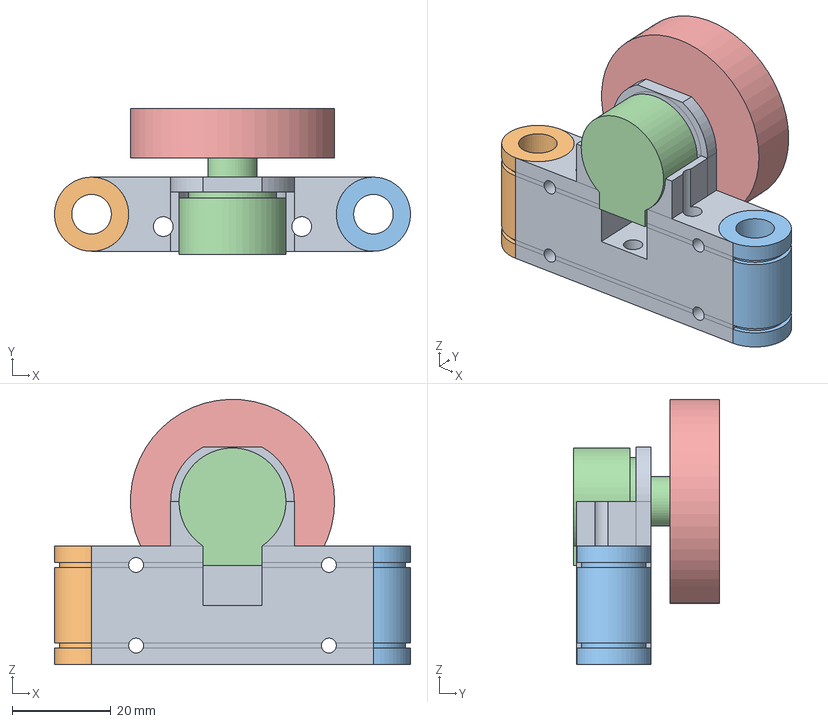
[picture p50: CAD file, 2017-10-29]
Mecanique/Base/Odometrie/Assemblage/barre_bille.fcstd
72.0 x 29.4 x 53.6 mm
barre_encodeur_01
douille_a_bille_01
douille_a_bille_02
encodeur_236_01
roue_encodeur_01
