robotronik/cdfr2018/Mecanique/Base/Odometrie/support_tiges.fcstd

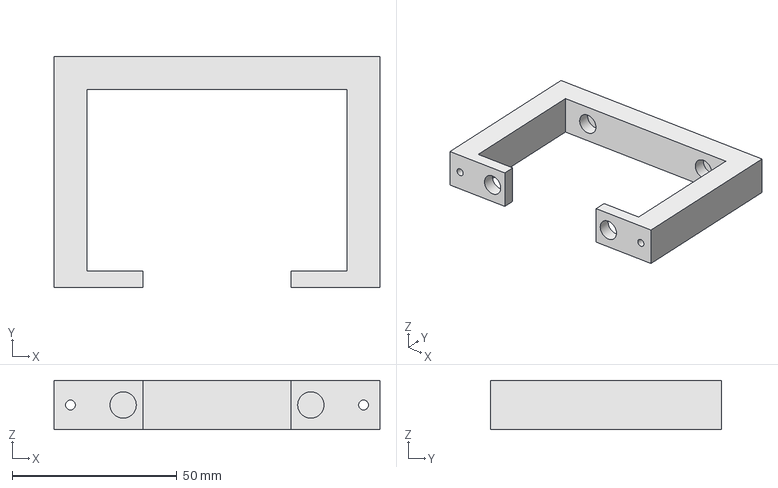
[picture p51: CAD file, 2017-10-29]
Mecanique/Base/Odometrie/support_tiges.fcstd
99.0 x 70.0 x 15.0 mm
