robotronik/cdfr2018/Mecanique/Base/Profiles/Assemblage/profile_av.fcstd

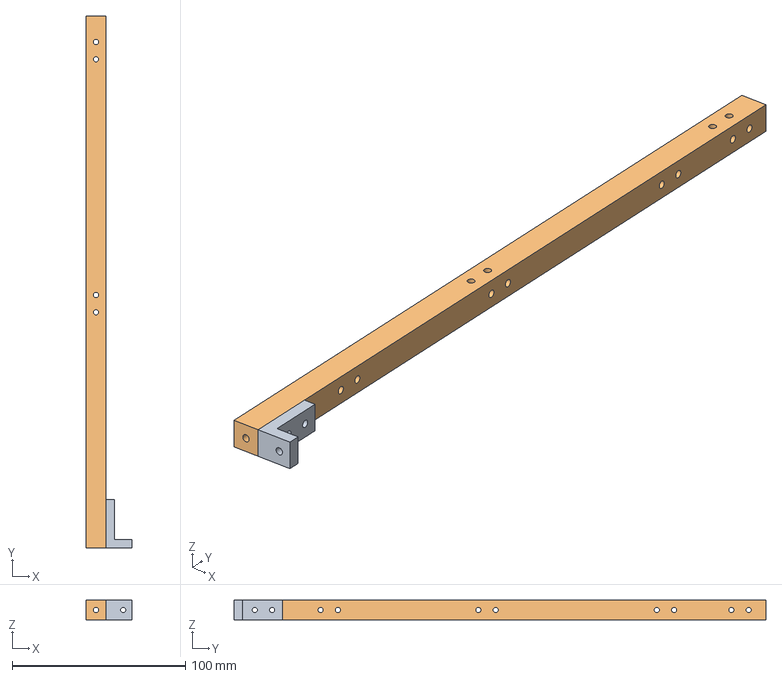
[picture p52: CAD file, 2017-11-16]
Mecanique/Base/Profiles/Assemblage/profile_av.fcstd
26.4 x 307.0 x 11.4 mm
support_bas_av_p_01
Profile_AV_01
