robotronik/cdfr2018/Mecanique/Bras_abeille_panneau/bras.fcstd

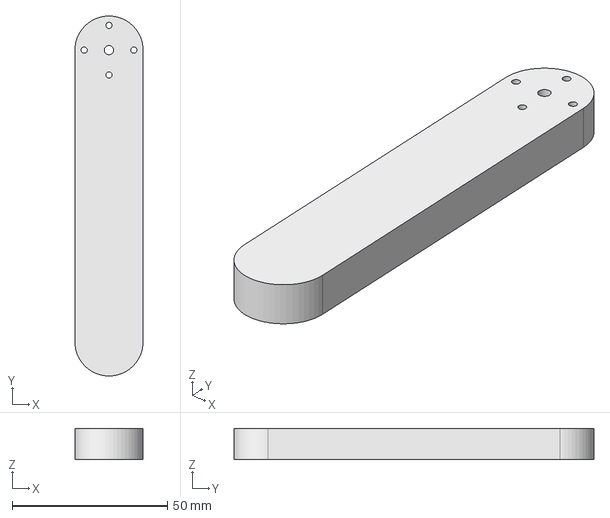
[picture p53: CAD file, 2018-01-13]
Mecanique/Bras_abeille_panneau/bras.fcstd
22.0 x 116.0 x 10.0 mm
