robotronik/cdfr2018/Mecanique/etage_elec/equerre_etage_elec.fcstd

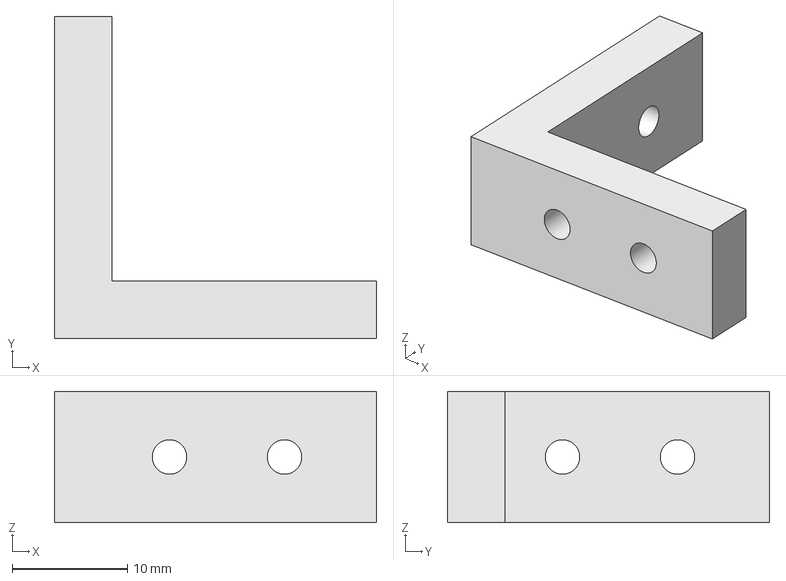
[picture p54: CAD file, 2017-11-14]
Mecanique/etage_elec/equerre_etage_elec.fcstd
28.0 x 28.0 x 11.4 mm
