robotronik/cdfr2018/Mecanique/etage_moteur/support_encodeur.fcstd

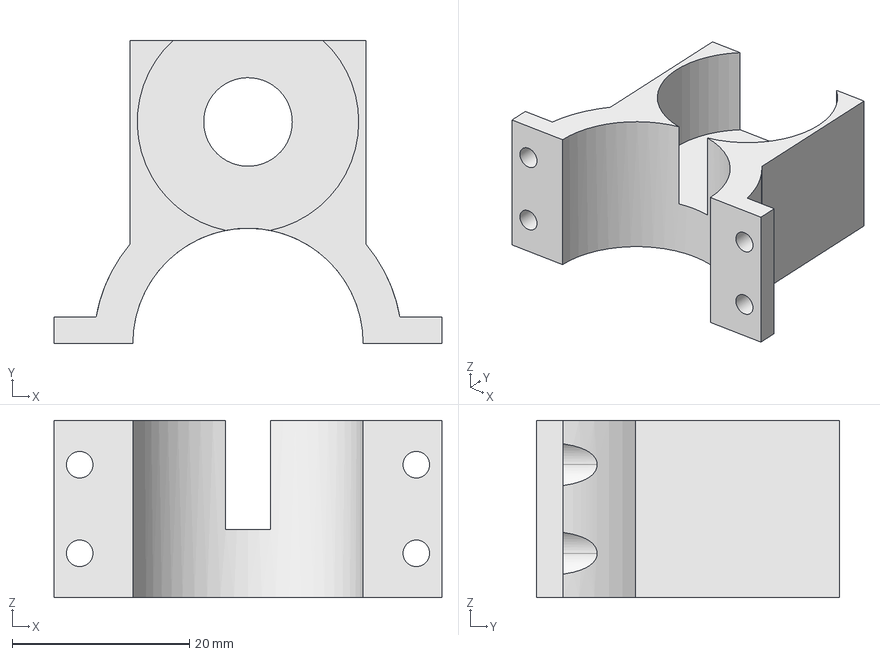
[picture p55: CAD file, 2017-12-07]
Mecanique/etage_moteur/support_encodeur.fcstd
43.8 x 34.2 x 20.0 mm
