robotronik/cdfr2018/Mecanique/Panneau/plaques_laterales.fcstd

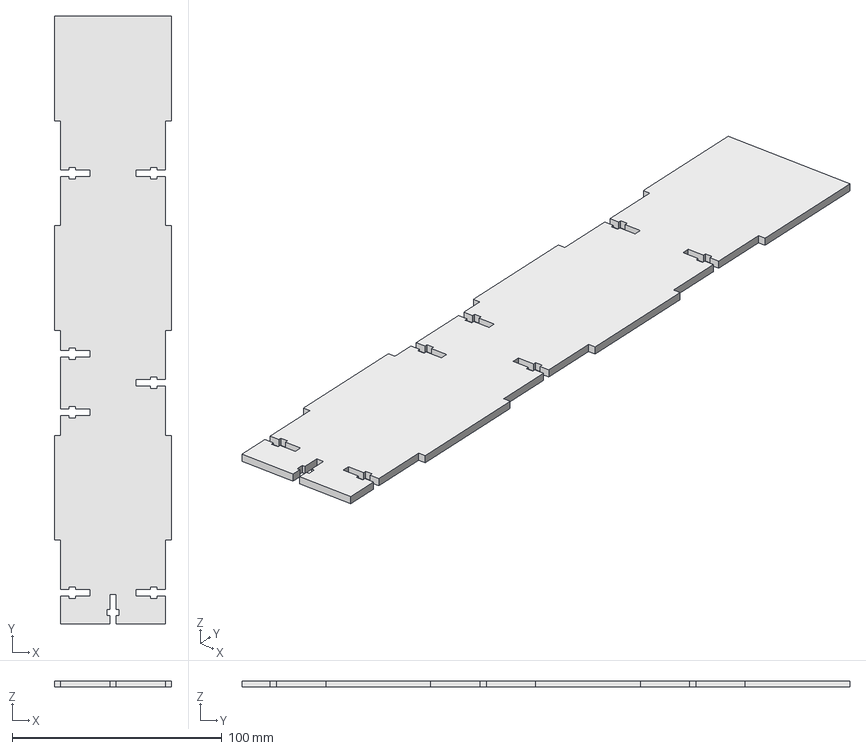
[picture p56: CAD file, 2018-01-14]
Mecanique/Panneau/plaques_laterales.fcstd
56.0 x 290.0 x 3.00 mm
