robotronik/cdfr2018/Mecanique/Pieces_alu/plans/etage_moteur.dxf

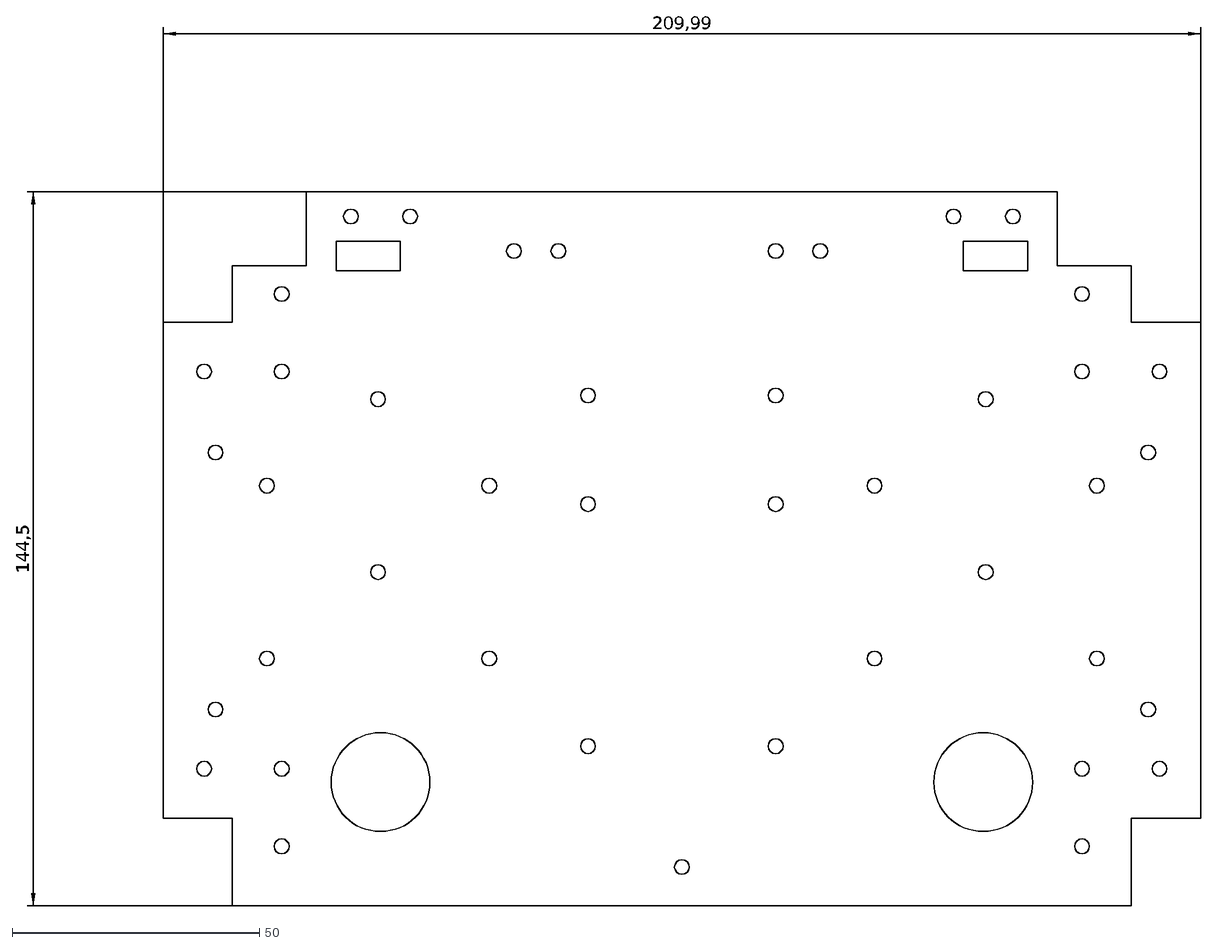
[picture p57: CAD file, 2017-12-11]
Mecanique/Pieces_alu/plans/etage_moteur.dxf
209,99
144,5
