robotronik/cdfr2018/Mecanique/Pieces_alu/STEP/base.step

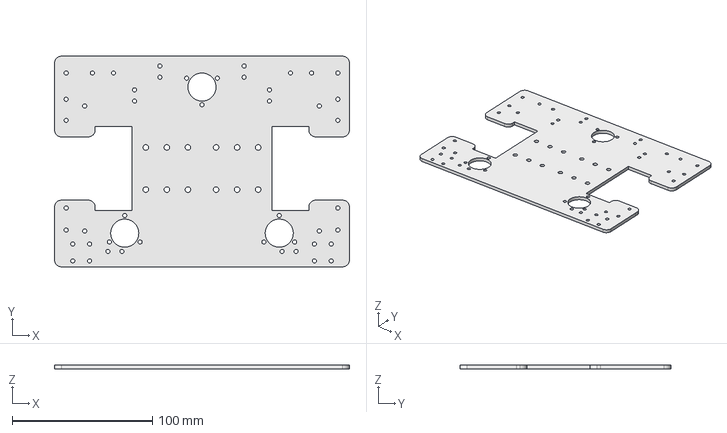
[picture p58: CAD file, 2017-11-28]
Mecanique/Pieces_alu/STEP/base.step
210.0 x 150.0 x 3.00 mm
