robotronik/cdfr2018/Mecanique/pince/support_servo.fcstd

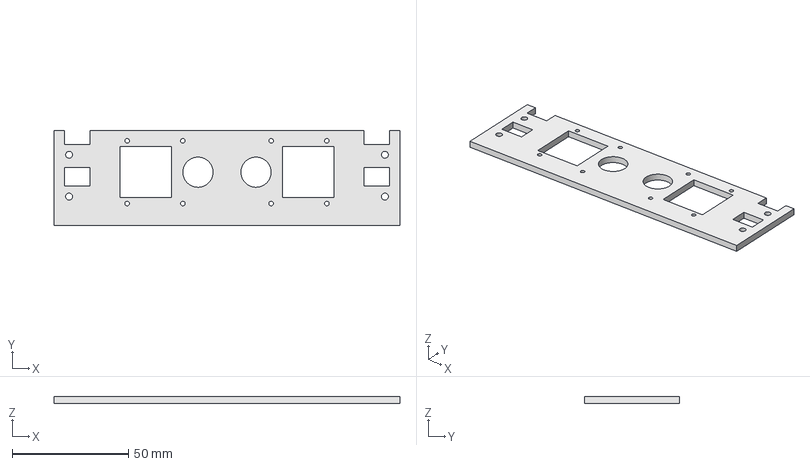
[picture p59: CAD file, 2018-01-14]
Mecanique/pince/support_servo.fcstd
149.0 x 41.0 x 3.00 mm
