robotronik/cdfr2018/Mecanique/plexi_ext/ar_elec.fcstd

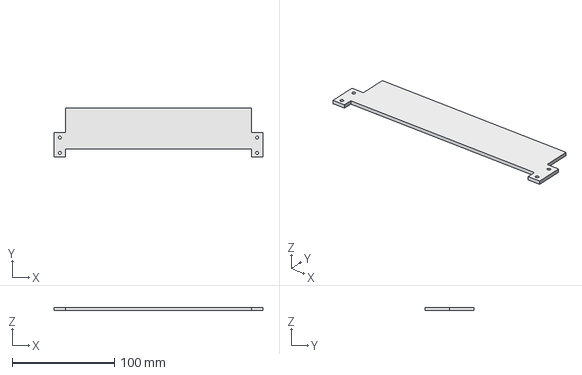
[picture p60: CAD file, 2018-01-15]
Mecanique/plexi_ext/ar_elec.fcstd
204.8 x 48.0 x 3.00 mm
