robotronik/cdfr2018/Mecanique/Support_capteurs/camera.fcstd

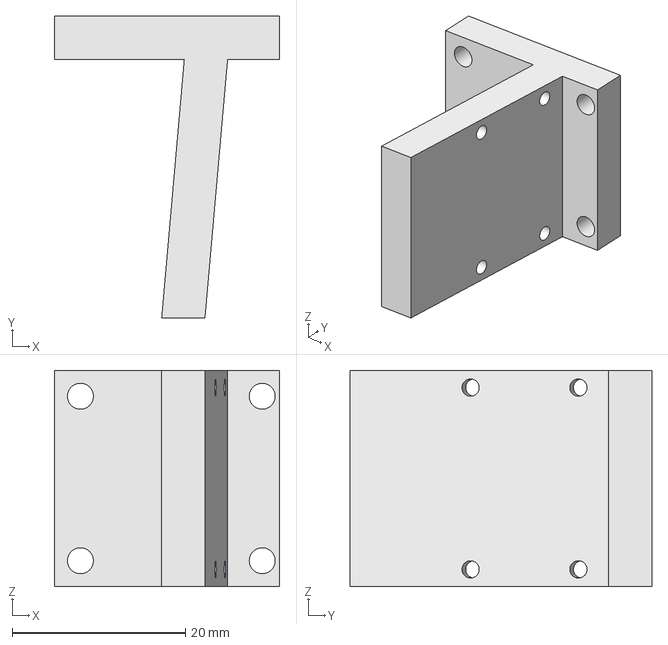
[picture p61: CAD file, 2018-02-14]
Mecanique/Support_capteurs/camera.fcstd
26.0 x 34.9 x 25.0 mm
