robotronik/cdfr2018/Mecanique/support_plexi/support_plexi_lateral_elec.fcstd

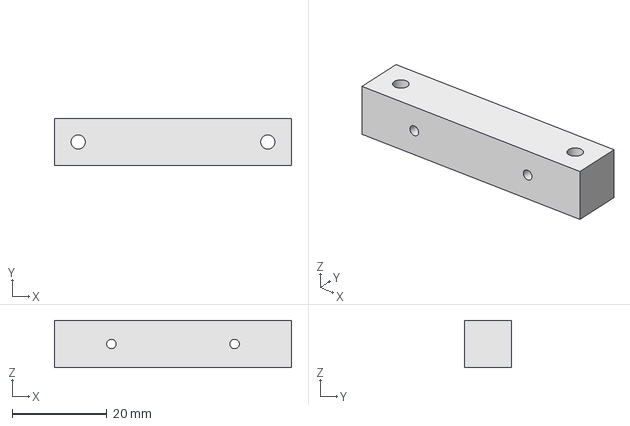
[picture p62: CAD file, 2017-11-16]
Mecanique/support_plexi/support_plexi_lateral_elec.fcstd
50.0 x 10.0 x 10.0 mm
