robotronik/cdfr2018/Mecanique/toit/support_balise_bas.fcstd

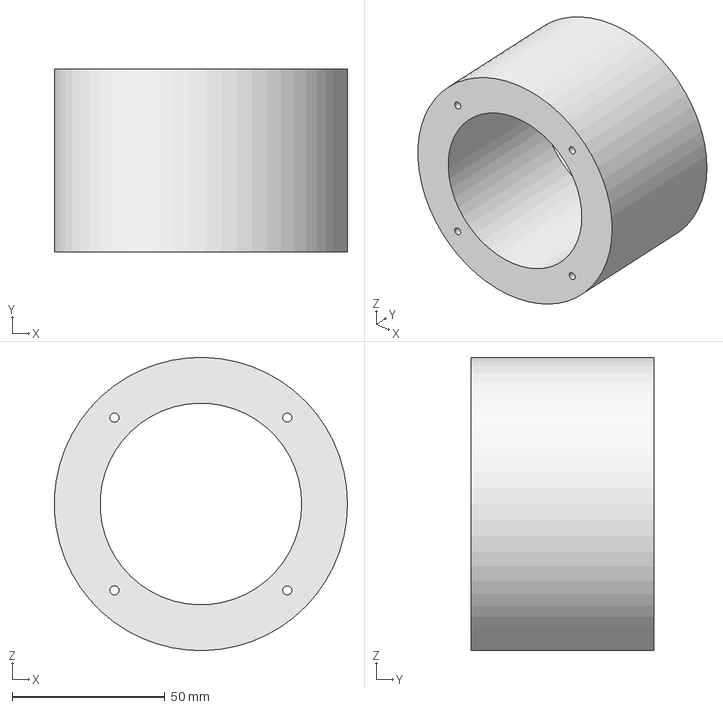
[picture p63: CAD file, 2018-04-14]
Mecanique/toit/support_balise_bas.fcstd
95.9 x 60.0 x 96.0 mm
