robotronik/cdfr2018/Mecanique/1er_etage/support_profiles_ar_2.fcstd

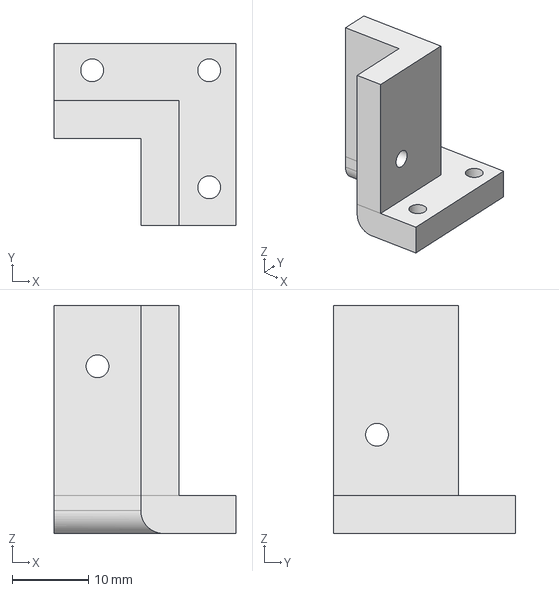
[picture p64: CAD file, 2017-11-01]
Mecanique/1er_etage/support_profiles_ar_2.fcstd
23.9 x 23.9 x 30.0 mm
