robotronik/cdfr2018/Mecanique/Abeille/abeille_coupe.fcstd

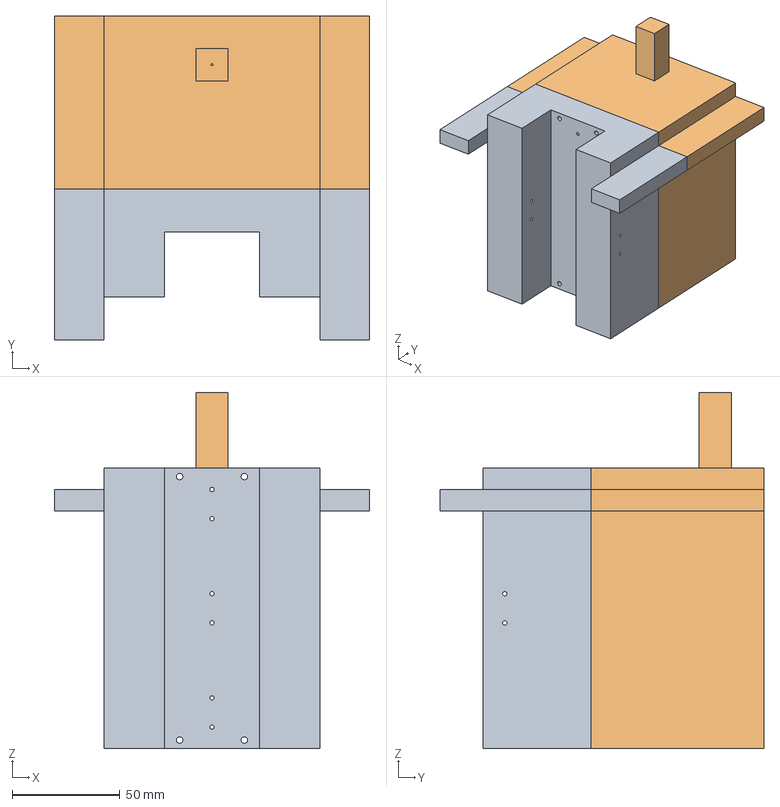
[picture p65: CAD file, 2018-02-28]
Mecanique/Abeille/abeille_coupe.fcstd
146.0 x 150.0 x 165.0 mm
structure_abeille_bas_01
structure_abeille_haut_01
