robotronik/cdfr2018/Mecanique/Base/Odometrie/Assemblage/odometre.fcstd

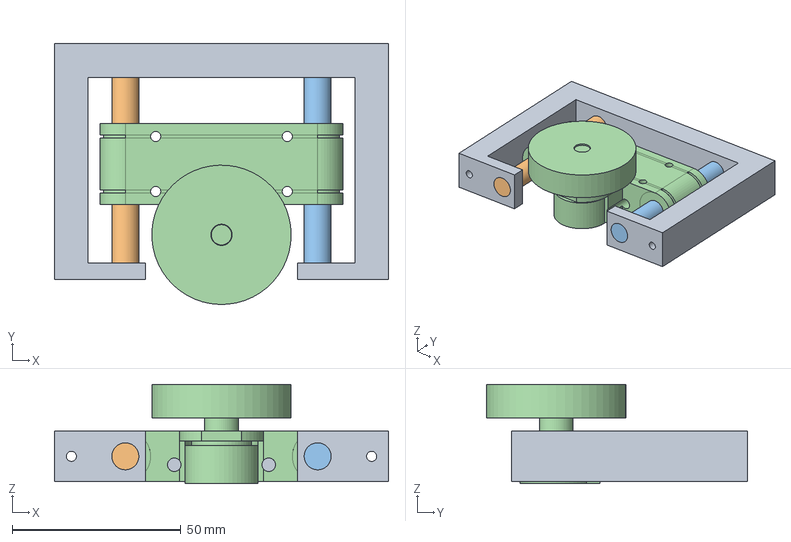
[picture p66: CAD file, 2017-10-29]
Mecanique/Base/Odometrie/Assemblage/odometre.fcstd
99.0 x 77.3 x 29.4 mm
support_tiges_01
tige_encodeur_01
tige_encodeur_02
barre_bille_01
