robotronik/cdfr2018/Mecanique/Base/Odometrie/tige_encodeur.fcstd

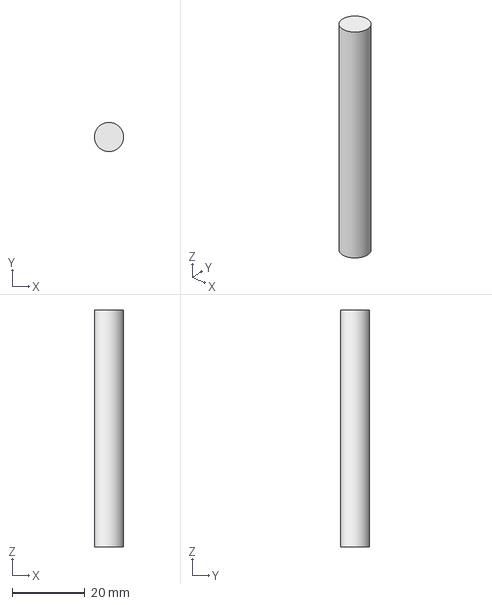
[picture p67: CAD file, 2017-10-29]
Mecanique/Base/Odometrie/tige_encodeur.fcstd
7.99 x 8.00 x 65.0 mm
