robotronik/cdfr2018/Mecanique/Base/Profiles/support_bas_av_p.fcstd

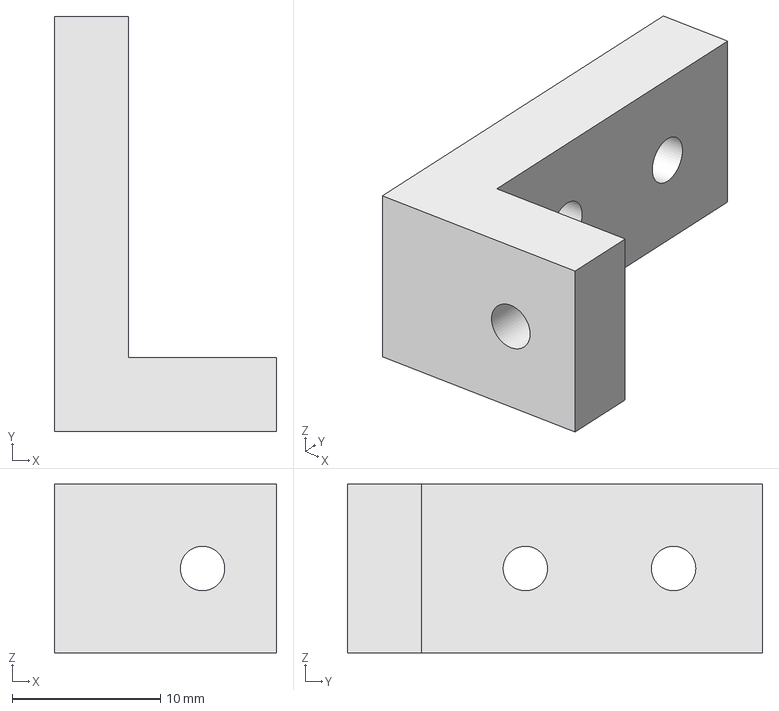
[picture p68: CAD file, 2017-11-01]
Mecanique/Base/Profiles/support_bas_av_p.fcstd
15.0 x 28.0 x 11.4 mm
