robotronik/cdfr2018/Mecanique/Base/tige_pince.fcstd

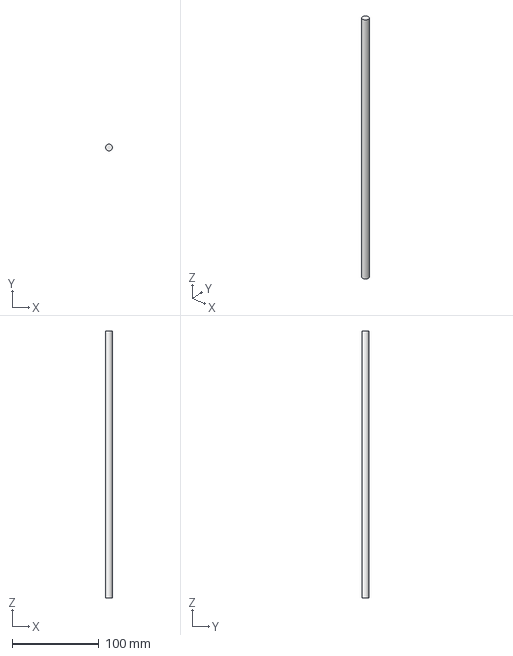
[picture p69: CAD file, 2017-11-16]
Mecanique/Base/tige_pince.fcstd
7.99 x 8.00 x 307.0 mm
