robotronik/cdfr2018/Mecanique/Panneau/plaque_ar.fcstd

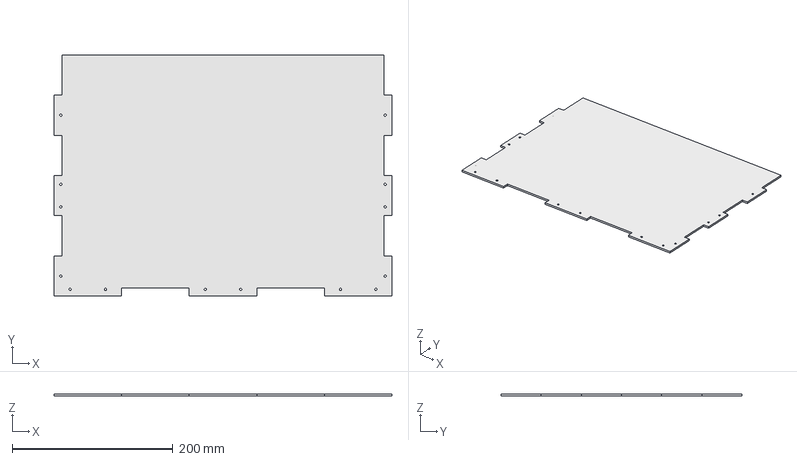
[picture p70: CAD file, 2018-01-14]
Mecanique/Panneau/plaque_ar.fcstd
420.0 x 300.0 x 3.00 mm
