robotronik/cdfr2018/Mecanique/Pieces_alu/plans/support_poulie.dxf

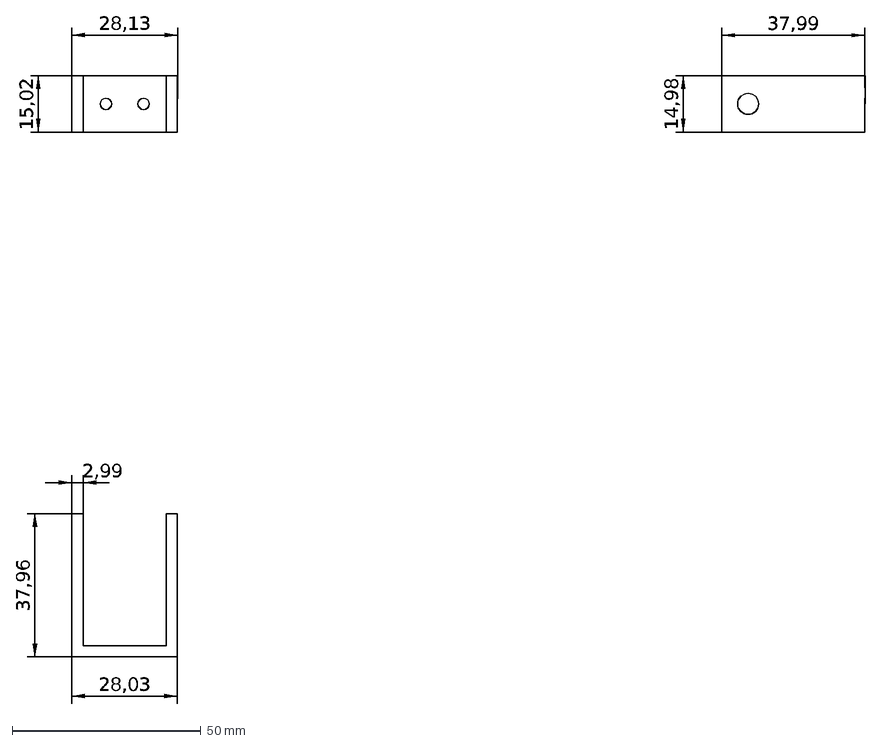
[picture p71: CAD file, 2017-12-11]
Mecanique/Pieces_alu/plans/support_poulie.dxf
28,13
15,02
37,99
14,98
2,99
28,03
37,96
