robotronik/cdfr2018/Mecanique/Pieces_alu/STEP/support_poulie_moteur.step

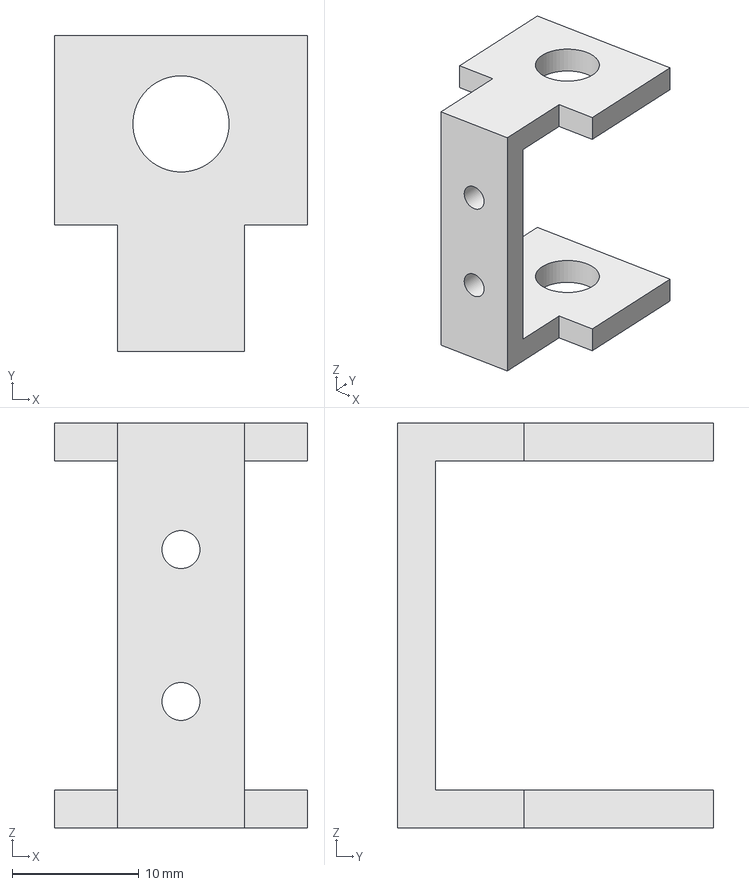
[picture p72: CAD file, 2017-11-28]
Mecanique/Pieces_alu/STEP/support_poulie_moteur.step
20.0 x 25.0 x 32.0 mm
