robotronik/cdfr2018/Mecanique/plexi_ext/lateral_elec.fcstd

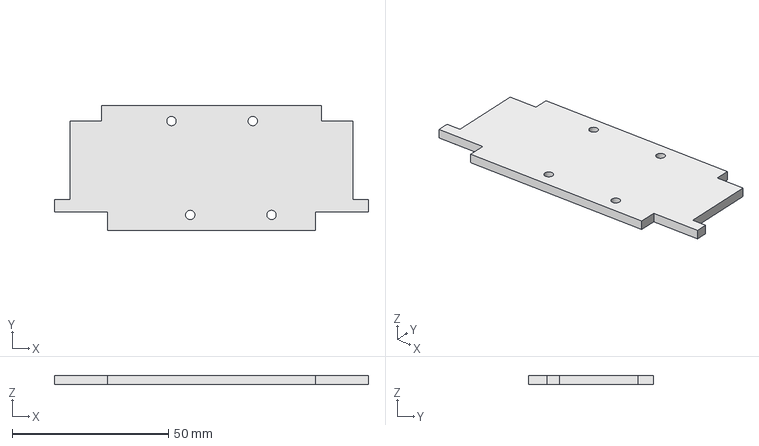
[picture p73: CAD file, 2018-01-15]
Mecanique/plexi_ext/lateral_elec.fcstd
100.4 x 40.0 x 3.00 mm
