robotronik/cdfr2018/Mecanique/table.fcstd

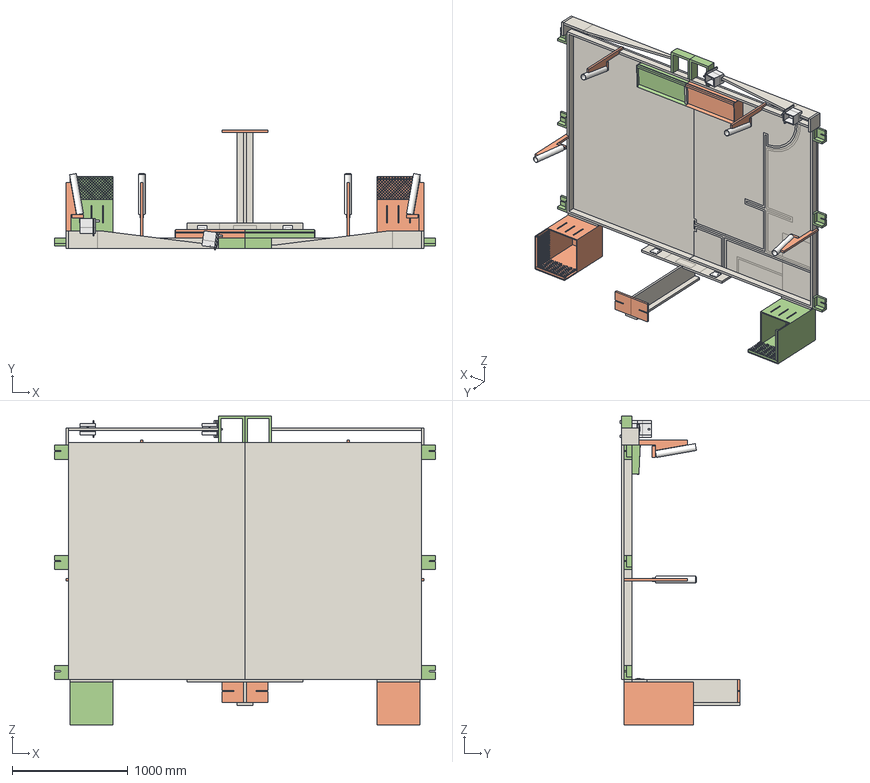
[picture p74: CAD file, 2018-01-13]
Mecanique/table.fcstd
3288.0 x 1033.5 x 2666.0 mm
SupportRampeBallon v7
RampeBallon v10
EpurationEau v19
EpurationEau v020
EpurationEau v021
EpurationEau v022
EpurationEau v023
EpurationEau v024
EpurationEau v025
EpurationEau v026
EpurationEau v027
EpurationEau v028
EpurationEau v029
EpurationEau v030
EpurationEau v031
SupportBallon v6
SupportBallon v007
SupportEau1 v7
SupportEau1 v008
SupportEau2 v5
SupportEau3 v3
SupportEau1 v009
SupportEau1 v010
SupportEau2 v006
SupportEau3 v004
SupportBaliseCentral v14
SupportBaliseCentral v015
SupportBaliseCentral v016
SupportBaliseCentral v017
ChateauEauP2 v10
ChateauEauP2 v011
ChateauEauP2 v012
ChateauEauP2 v013
ChateauEauP2 v014
ChateauEauP2 v015
ChateauEauP2 v016
ChateauEauP2 v2(Mirror)
ChateauEauP2 v2(Mirror)001
ChateauEauP2 v2(Mirror)002
ChateauEauP2 v2(Mirror)003
ChateauEauP2 v2(Mirror)004
ChateauEauP2 v2(Mirror)005
ChateauEauP2 v2(Mirror)006
SupportBalise v5
SupportBalise v006
SupportBalise v007
SupportEau1 v011
SupportEau1 v012
SupportEau2 v007
SupportEau3 v005
SupportEau1 v013
SupportEau1 v014
SupportEau2 v008
SupportEau3 v006
RampeBallon v2
SupportRampeBallon v008
SupportPlanInterupteur v9
Interrupteur v3
Interrupteur v004
Filet v4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
