robotronik/cdfr2018/Mecanique/toit/support_balise.fcstd

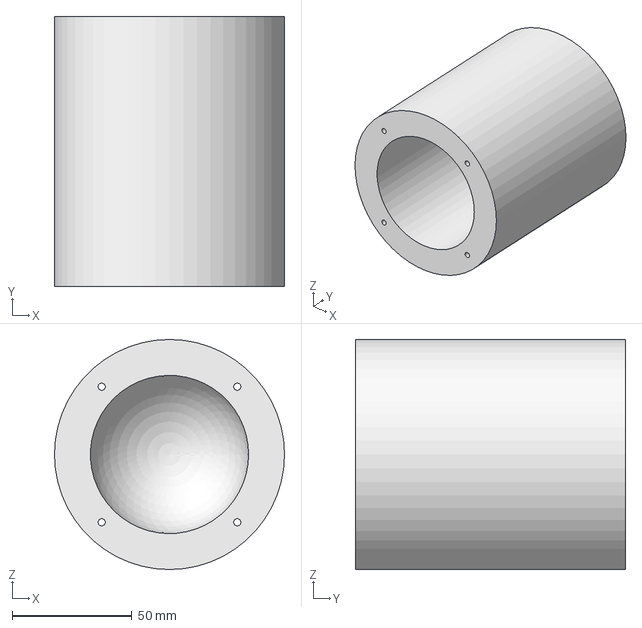
[picture p75: CAD file, 2018-04-14]
Mecanique/toit/support_balise.fcstd
96.0 x 112.7 x 96.0 mm
