robotronik/cdfr2018/Mecanique/Abeille/bille.fcstd

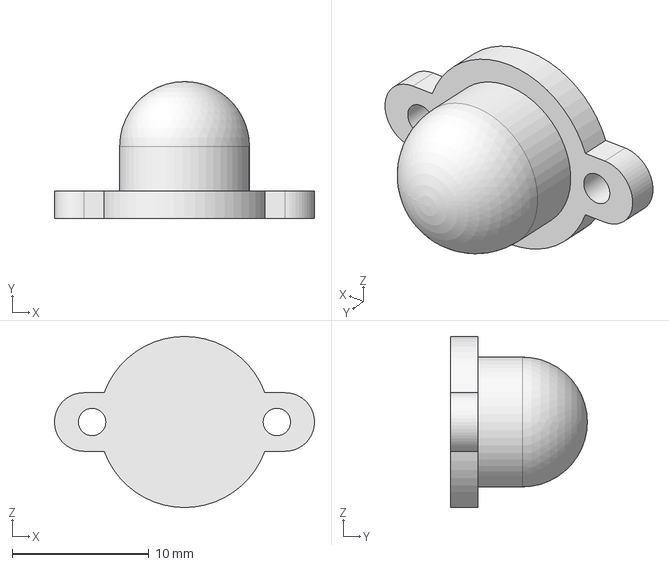
[picture p76: CAD file, 2018-01-13]
Mecanique/Abeille/bille.fcstd
19.0 x 10.0 x 12.5 mm
