robotronik/cdfr2018/Mecanique/Base/couplage_roue-2.fcstd

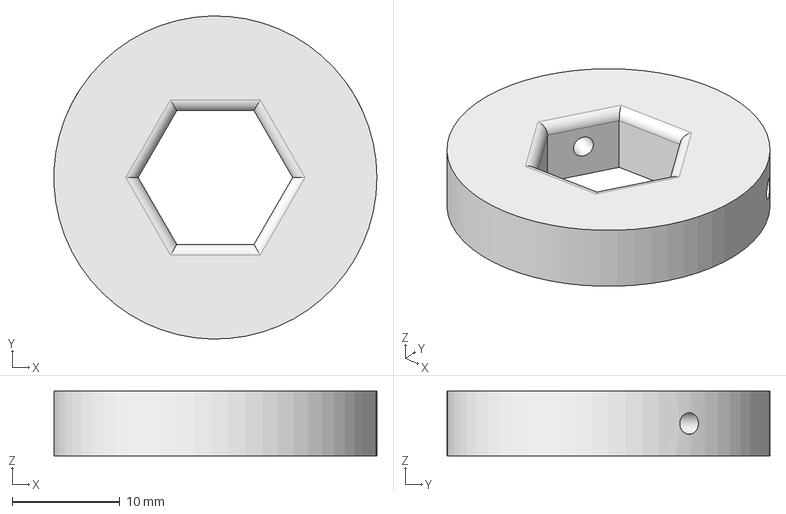
[picture p77: CAD file, 2017-11-07]
Mecanique/Base/couplage_roue-2.fcstd
30.0 x 30.0 x 6.00 mm
