robotronik/cdfr2018/Mecanique/Base/Odometrie/barre_encodeur.fcstd

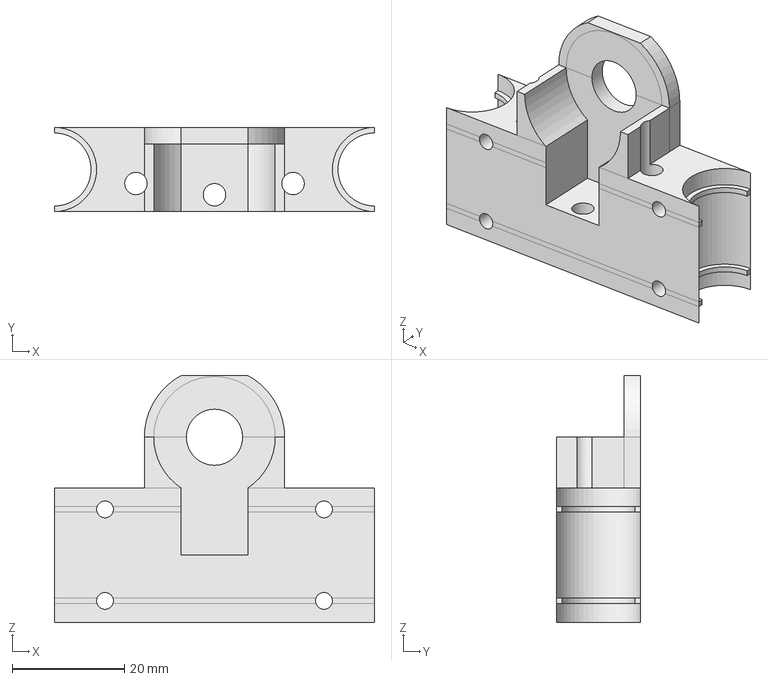
[picture p78: CAD file, 2017-10-29]
Mecanique/Base/Odometrie/barre_encodeur.fcstd
57.0 x 15.0 x 44.0 mm
