robotronik/cdfr2018/Mecanique/Base/Profiles/support_bas_ar_p_2.fcstd

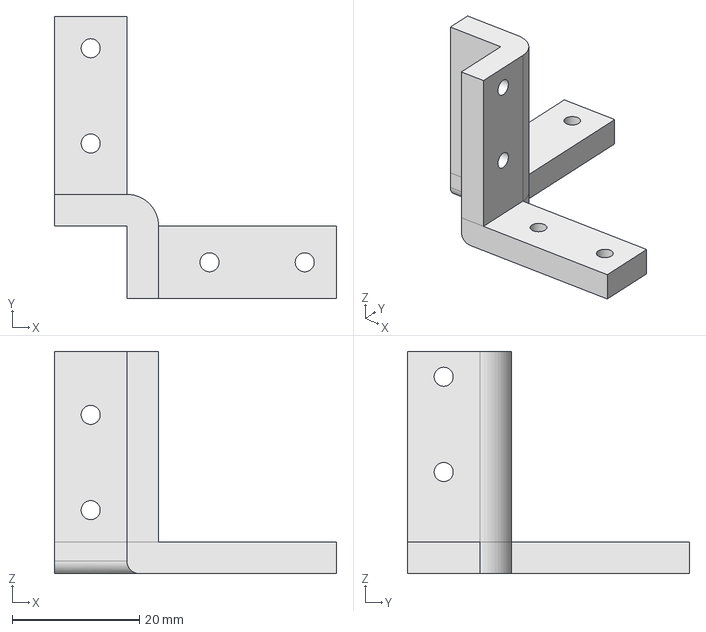
[picture p79: CAD file, 2017-10-31]
Mecanique/Base/Profiles/support_bas_ar_p_2.fcstd
44.4 x 44.4 x 35.0 mm
