robotronik/cdfr2018/Mecanique/etage_moteur/Assemblage/poulie_haut.fcstd

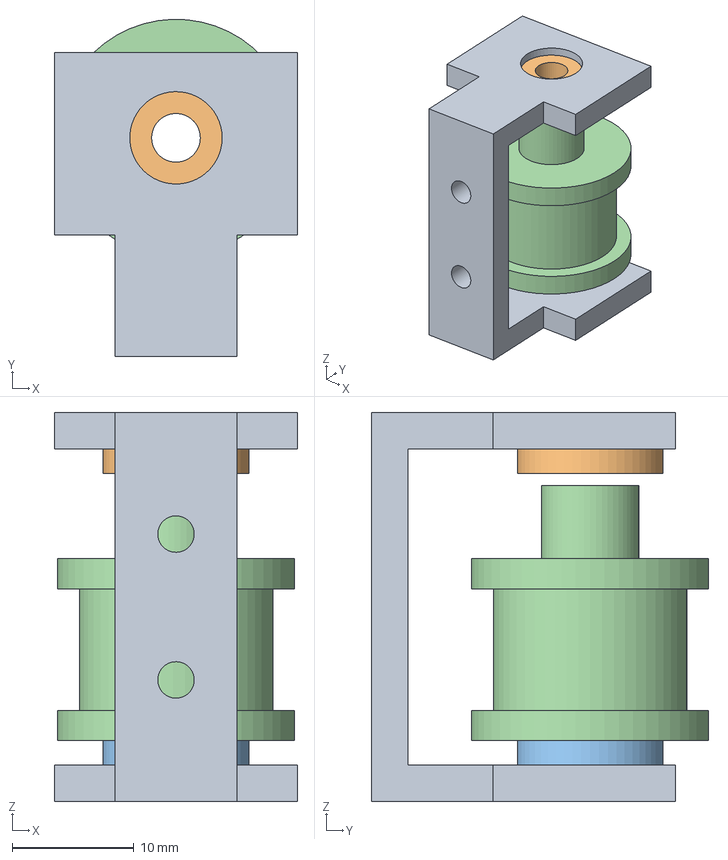
[picture p80: CAD file, 2017-11-07]
Mecanique/etage_moteur/Assemblage/poulie_haut.fcstd
20.0 x 27.7 x 32.0 mm
support_poulie_moteur_01
coussinet_01
coussinet_02
poulie_01
