robotronik/cdfr2018/Mecanique/etage_moteur/support_moteur_encodeur.fcstd

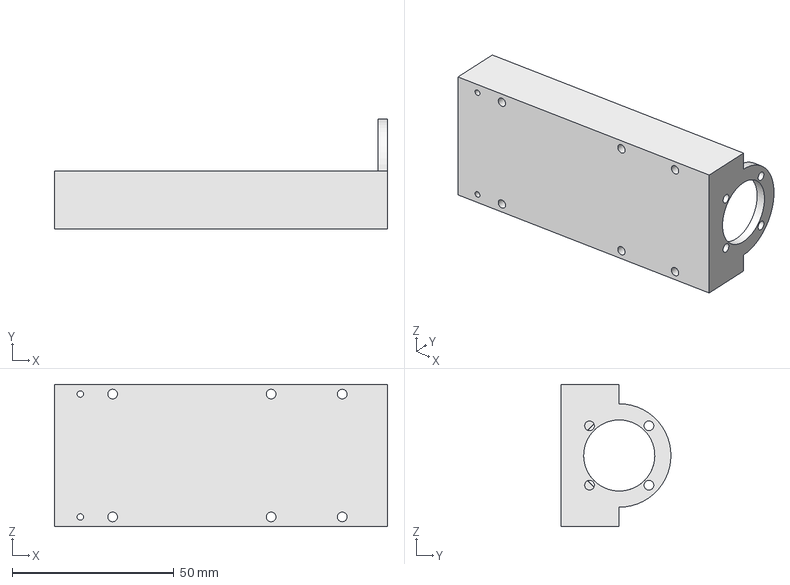
[picture p81: CAD file, 2017-11-11]
Mecanique/etage_moteur/support_moteur_encodeur.fcstd
103.0 x 34.0 x 44.0 mm
