robotronik/cdfr2018/Mecanique/Pieces_alu/plans/base.dxf

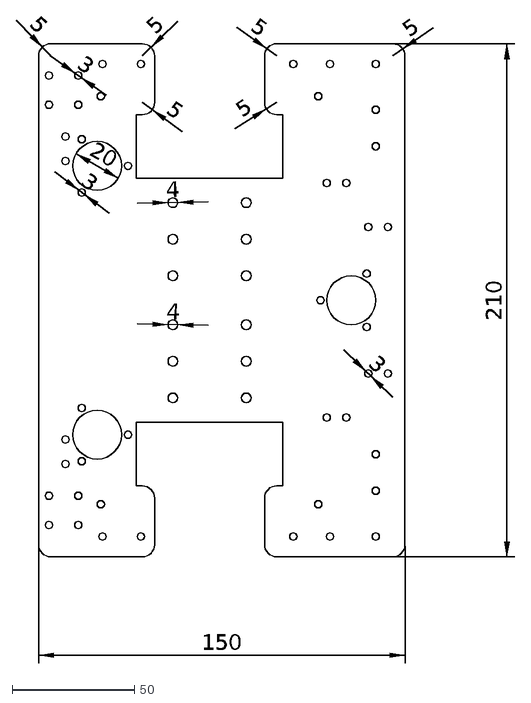
[picture p82: CAD file, 2017-11-24]
Mecanique/Pieces_alu/plans/base.dxf
20
4
3
5
150
210
