robotronik/cdfr2018/Mecanique/Pieces_alu/STEP/support_moteur.step

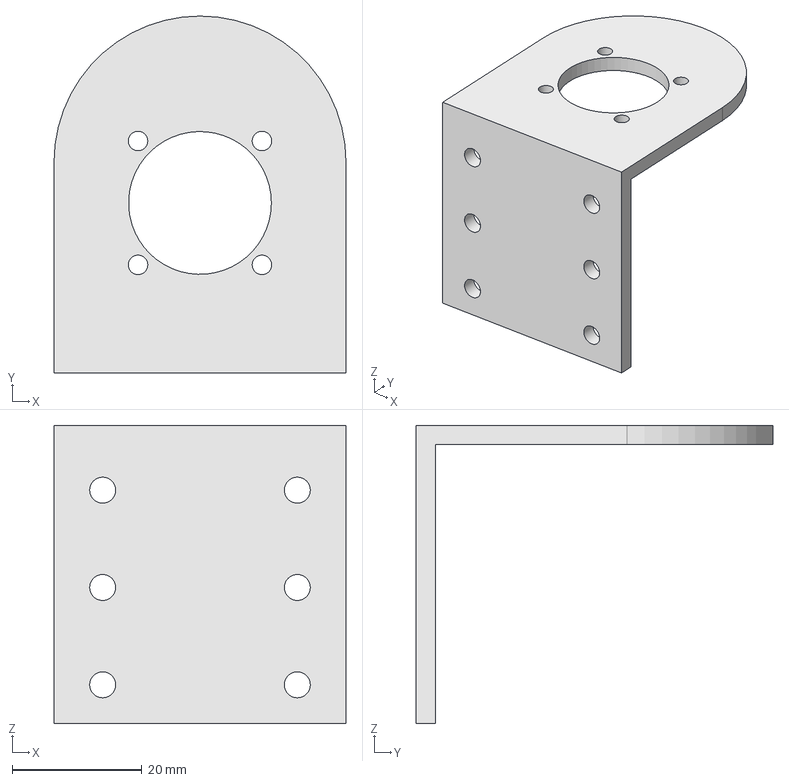
[picture p83: CAD file, 2017-11-28]
Mecanique/Pieces_alu/STEP/support_moteur.step
45.0 x 55.0 x 46.0 mm
