robotronik/cdfr2018/Mecanique/pince/ass_pince_haut.fcstd

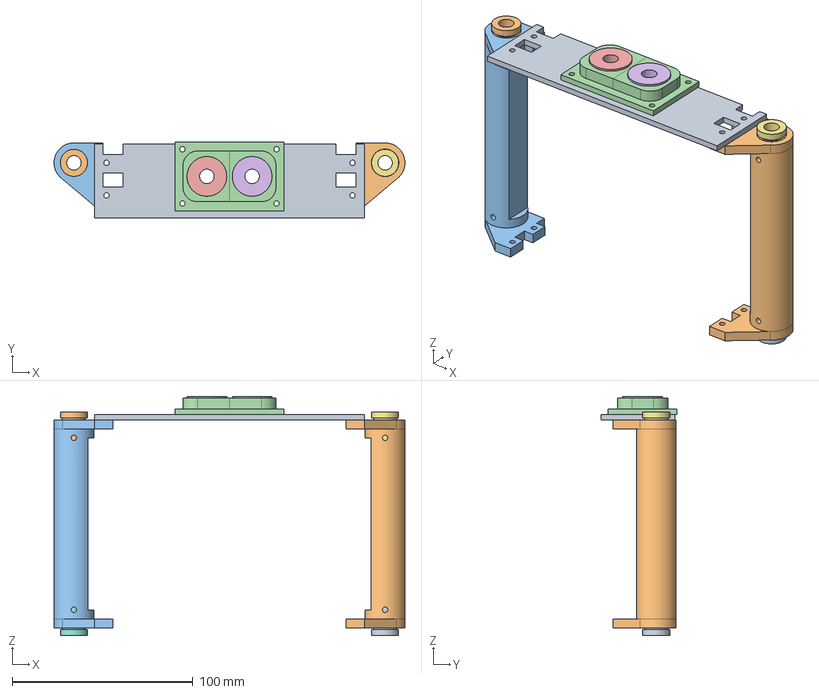
[picture p84: CAD file, 2017-12-31]
Mecanique/pince/ass_pince_haut.fcstd
194.0 x 42.0 x 132.4 mm
top_plexi_pince_01
douille_to_plexi_01
douille_to_plexi_02
cale_roulement_01
roulement_01
roulement_02
douille_a_bille_01
douille_a_bille_02
douille_a_bille_03
douille_a_bille_04
