robotronik/cdfr2018/Mecanique/plexi_ext/lateral_1er_etage.fcstd

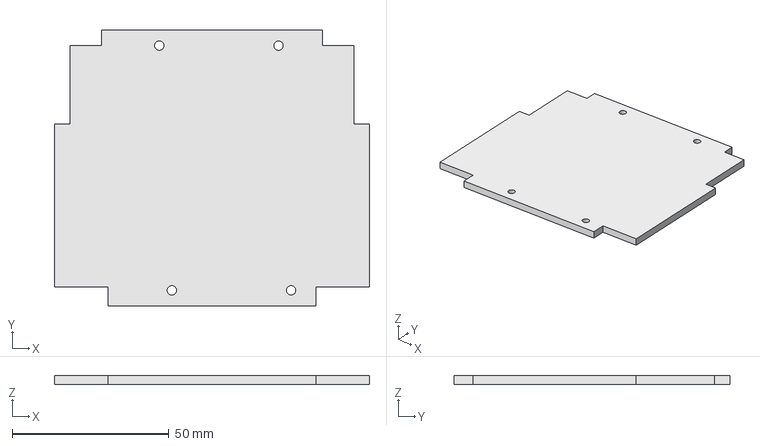
[picture p85: CAD file, 2018-01-15]
Mecanique/plexi_ext/lateral_1er_etage.fcstd
100.4 x 88.0 x 3.00 mm
