robotronik/cdfr2018/Mecanique/toit/toit.fcstd

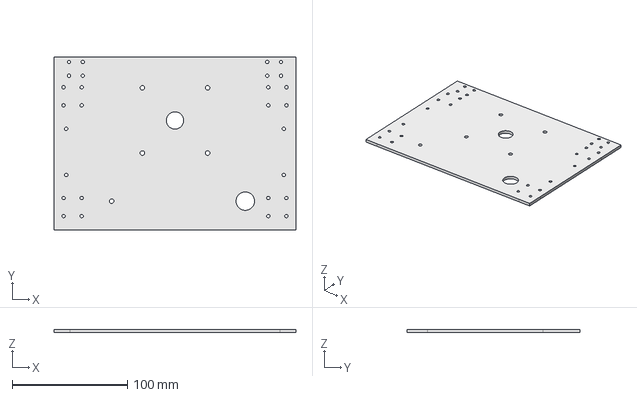
[picture p86: CAD file, 2018-01-14]
Mecanique/toit/toit.fcstd
210.0 x 150.0 x 3.00 mm
