robotronik/cdfr2018/Mecanique/Base/couplage_roue.fcstd

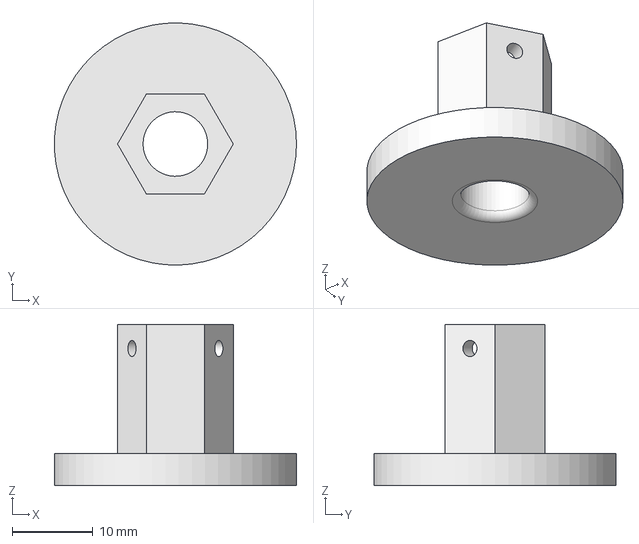
[picture p87: CAD file, 2017-11-07]
Mecanique/Base/couplage_roue.fcstd
30.0 x 30.0 x 20.0 mm
