robotronik/cdfr2018/Mecanique/Base_et_pince.fcstd

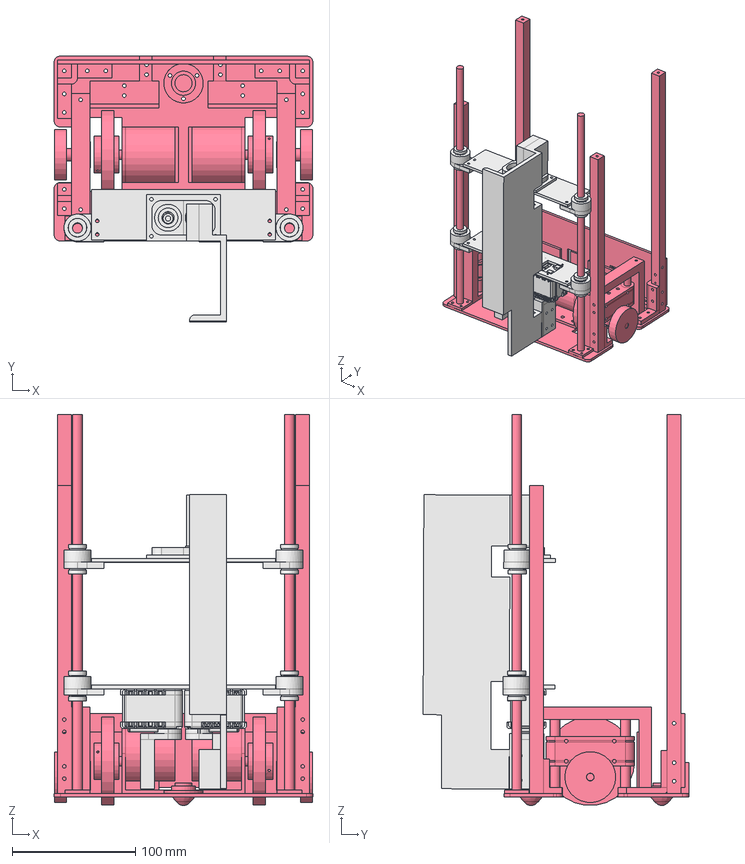
[picture p88: CAD file, 2017-11-02]
Mecanique/Base_et_pince.fcstd
210.0 x 215.6 x 317.2 mm
base_roulante_01
assemblage_pince_01
