robotronik/cdfr2018/Mecanique/etage_moteur/pignon.fcstd

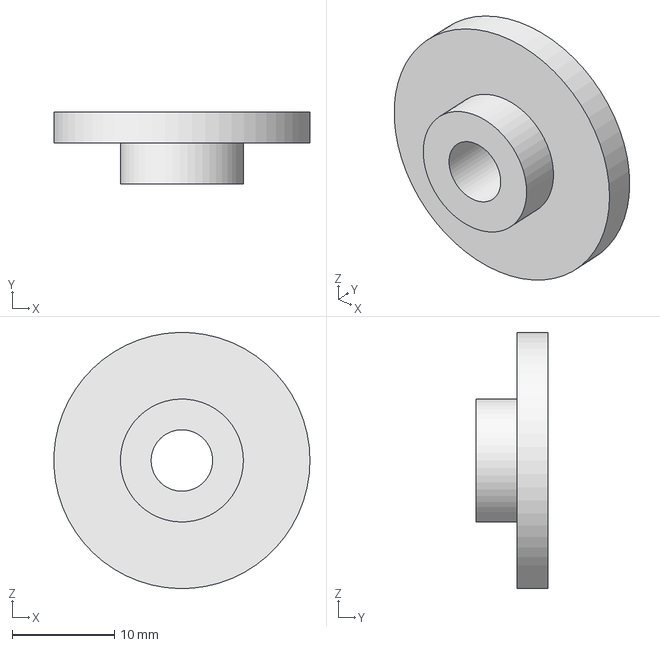
[picture p89: CAD file, 2017-11-08]
Mecanique/etage_moteur/pignon.fcstd
25.0 x 7.00 x 25.0 mm
