robotronik/cdfr2018/Mecanique/Panneau/matrice_led.fcstd

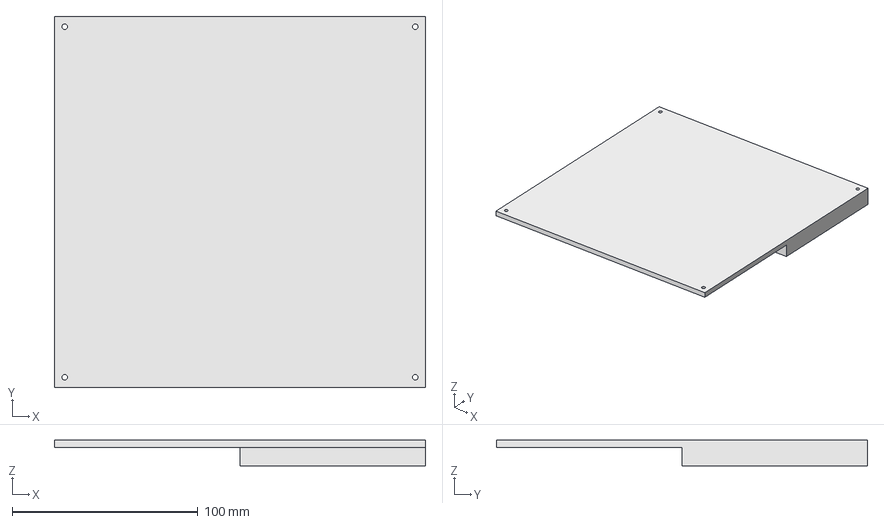
[picture p90: CAD file, 2018-01-12]
Mecanique/Panneau/matrice_led.fcstd
200.0 x 200.0 x 14.0 mm
