robotronik/cdfr2018/Mecanique/Pieces_alu/STEP/support_poulie.step

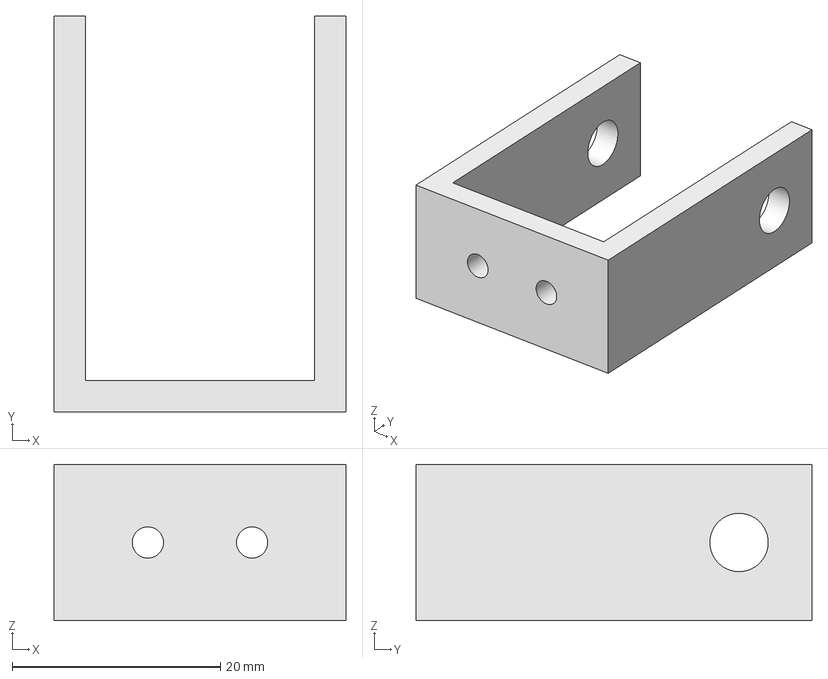
[picture p91: CAD file, 2017-11-28]
Mecanique/Pieces_alu/STEP/support_poulie.step
28.0 x 38.0 x 15.0 mm
