robotronik/cdfr2018/Mecanique/pince/douille_to_plexi.fcstd

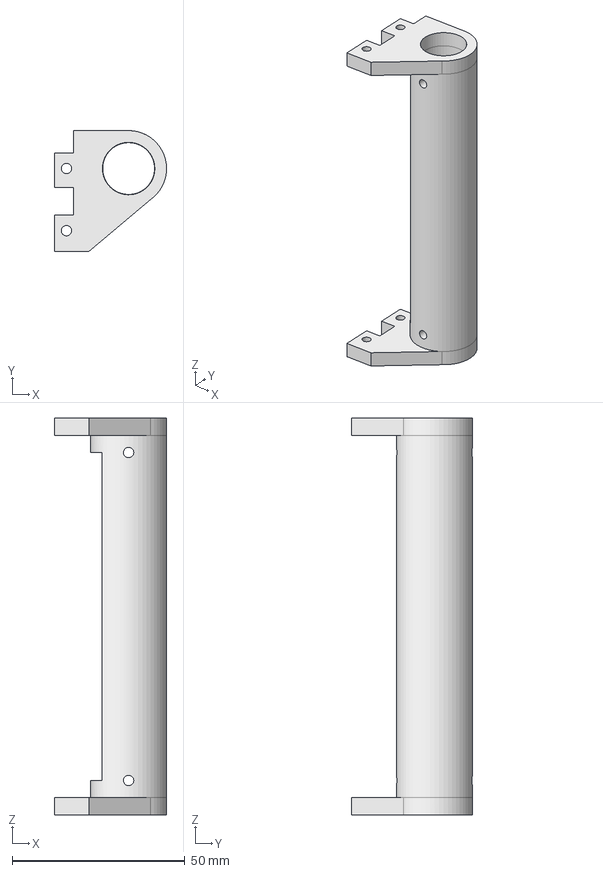
[picture p92: CAD file, 2017-12-31]
Mecanique/pince/douille_to_plexi.fcstd
32.5 x 35.0 x 115.0 mm
