robotronik/cdfr2018/Mecanique/plexi_ext/ar_moteur.fcstd

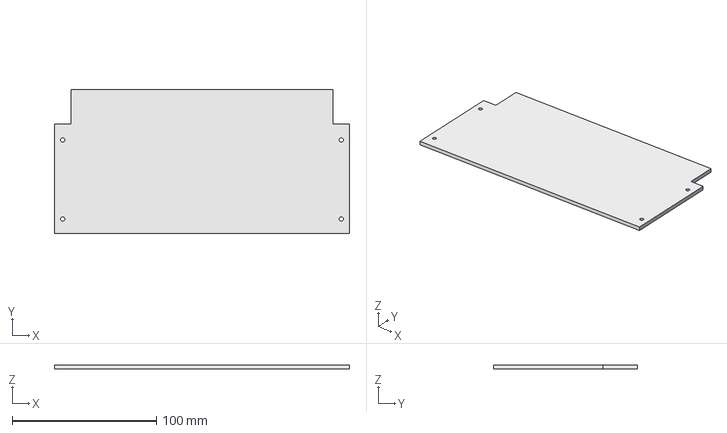
[picture p93: CAD file, 2018-01-15]
Mecanique/plexi_ext/ar_moteur.fcstd
204.8 x 100.0 x 3.00 mm
