robotronik/cdfr2018/Mecanique/etage_moteur/support_encodeur_original.fcstd

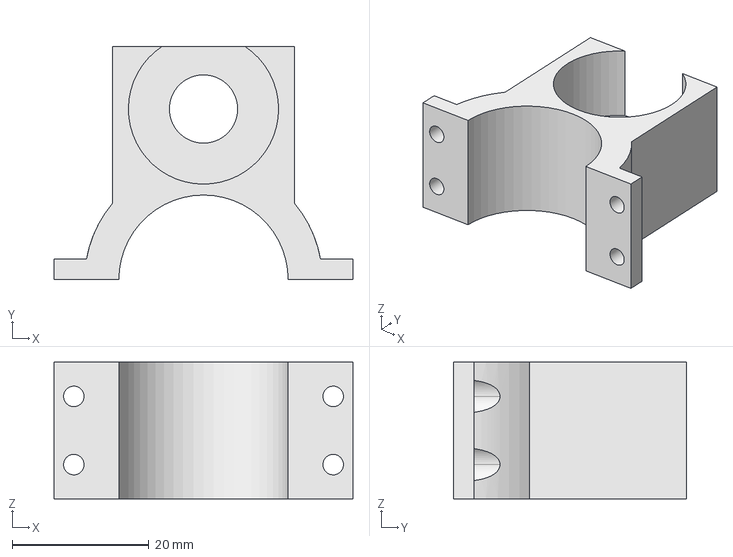
[picture p94: CAD file, 2017-11-08]
Mecanique/etage_moteur/support_encodeur_original.fcstd
43.8 x 34.2 x 20.0 mm
