robotronik/cdfr2018/Mecanique/pince/ass_pince_bas.fcstd

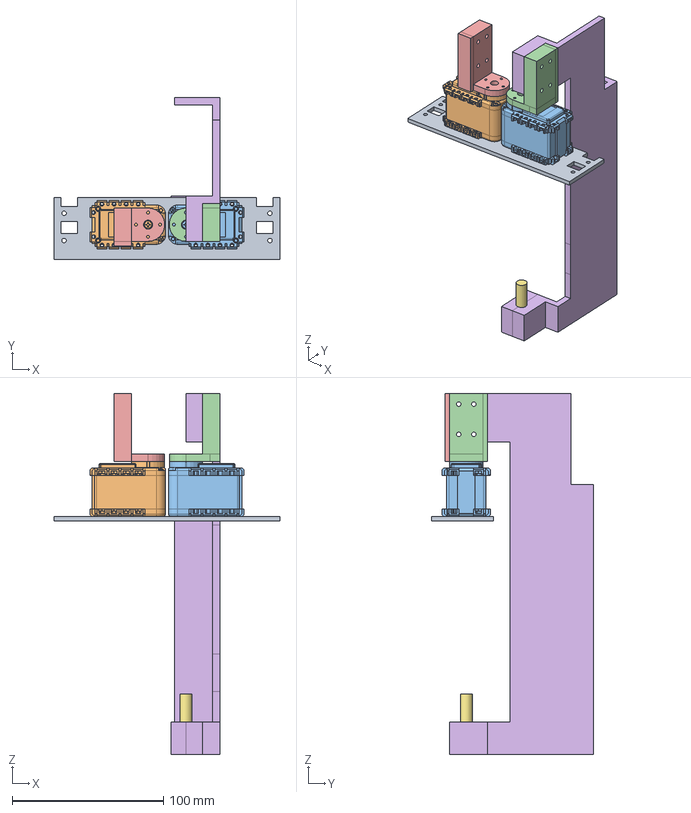
[picture p95: CAD file, 2017-12-31]
Mecanique/pince/ass_pince_bas.fcstd
149.0 x 107.0 x 238.5 mm
support_servo_01
comp_ax12_01
comp_ax12_02
adaptateur_servo_pince_01
adaptateur_servo_pince_02
pince_g_01
axe_pince_01
