robotronik/cdfr2018/Mecanique/plexi_ext/ar_1er_etage.fcstd

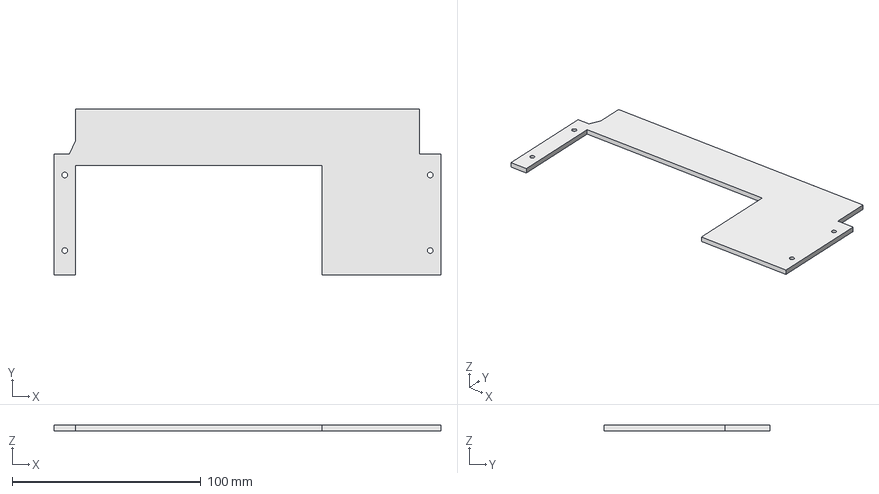
[picture p96: CAD file, 2018-01-15]
Mecanique/plexi_ext/ar_1er_etage.fcstd
204.8 x 88.0 x 3.00 mm
