robotronik/cdfr2018/Mecanique/Base/coussinet_3.fcstd

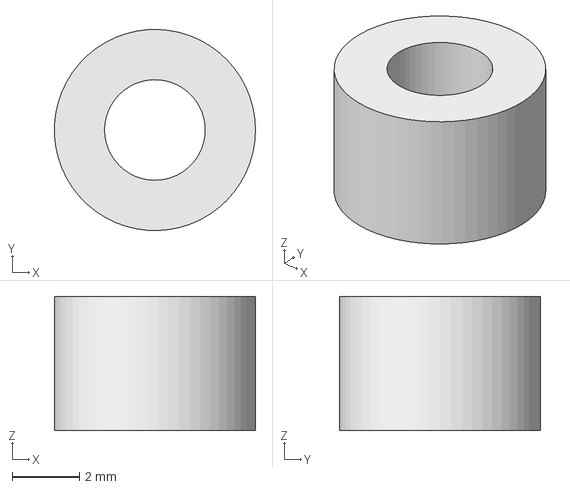
[picture p97: CAD file, 2017-11-04]
Mecanique/Base/coussinet_3.fcstd
6.00 x 6.00 x 4.00 mm
