robotronik/cdfr2018/Mecanique/pince/equerre_top_pince.fcstd

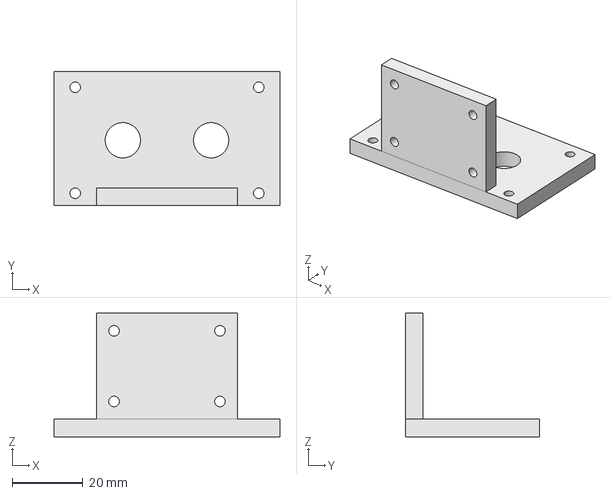
[picture p98: CAD file, 2017-12-07]
Mecanique/pince/equerre_top_pince.fcstd
64.0 x 38.0 x 35.0 mm
