robotronik/cdfr2018/Mecanique/Base/calle-tige.fcstd

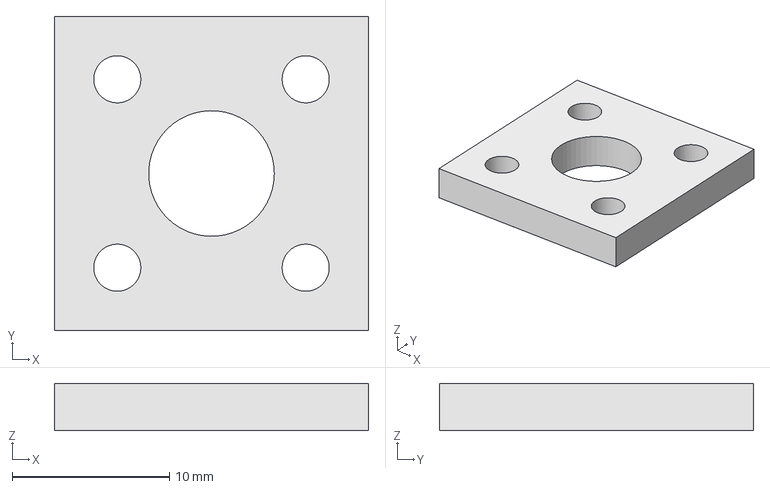
[picture p99: CAD file, 2017-10-31]
Mecanique/Base/calle-tige.fcstd
20.0 x 20.0 x 3.00 mm
