robotronik/cdfr2018/Mecanique/etage_moteur/pignon_conique.fcstd

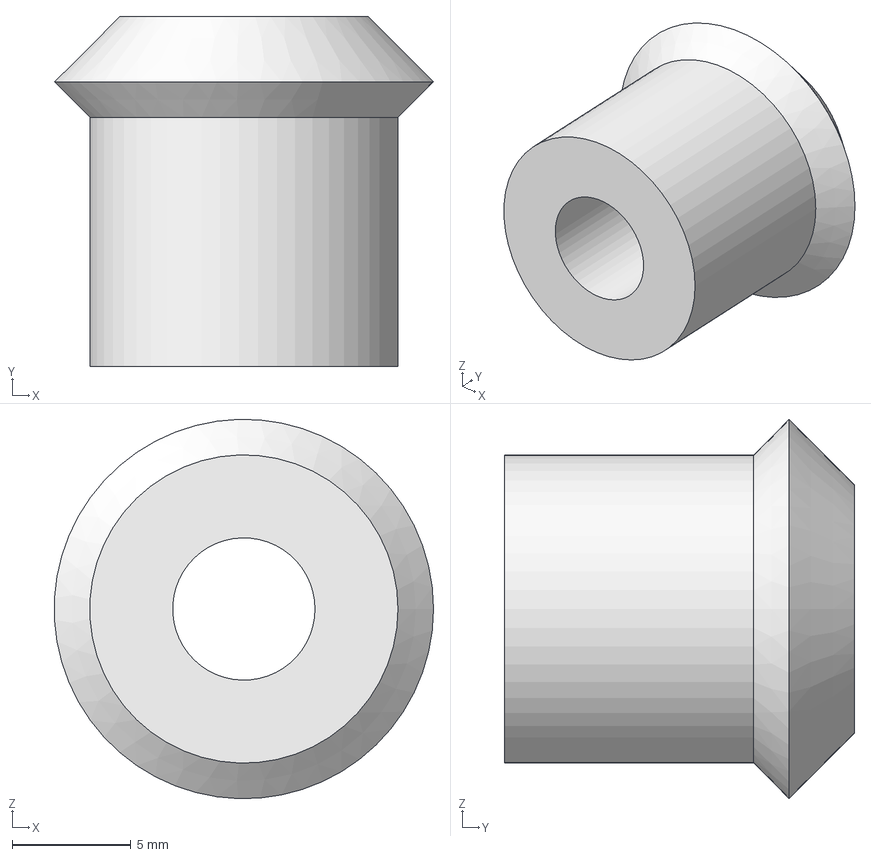
[picture p100: CAD file, 2017-11-07]
Mecanique/etage_moteur/pignon_conique.fcstd
16.0 x 14.8 x 16.0 mm
