robotronik/cdfr2018/Mecanique/pince/equerre_bas.fcstd

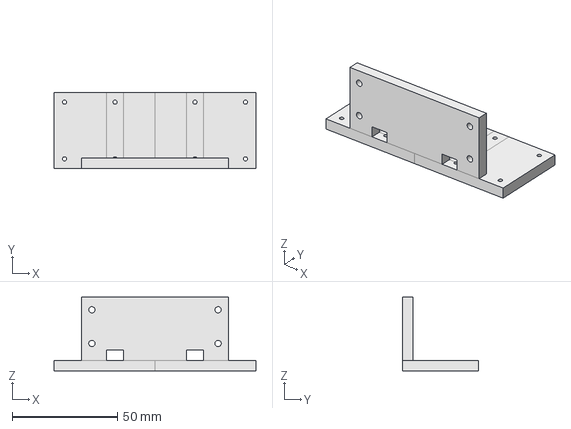
[picture p101: CAD file, 2017-11-16]
Mecanique/pince/equerre_bas.fcstd
96.0 x 36.0 x 35.0 mm
