robotronik/cdfr2018/Mecanique/Base/support_batterie_2.fcstd

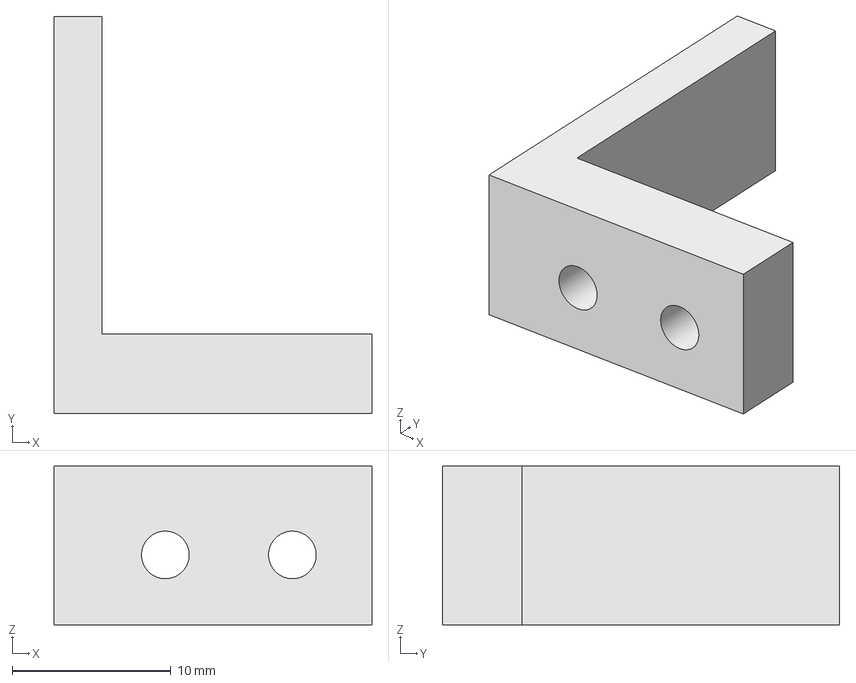
[picture p102: CAD file, 2017-10-31]
Mecanique/Base/support_batterie_2.fcstd
20.0 x 25.0 x 10.0 mm
