robotronik/cdfr2018/Mecanique/etage_moteur/bride_moteur.fcstd

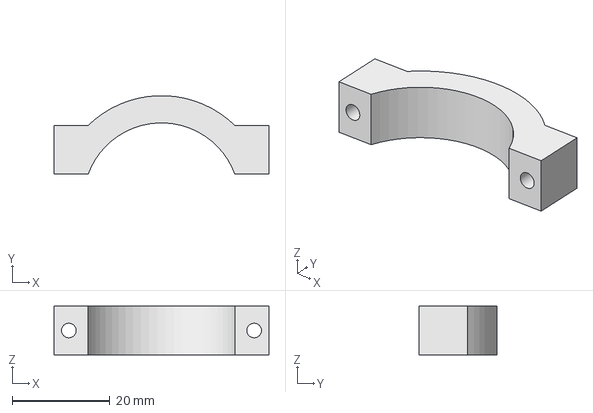
[picture p103: CAD file, 2017-11-07]
Mecanique/etage_moteur/bride_moteur.fcstd
44.1 x 16.1 x 10.0 mm
