robotronik/cdfr2018/Mecanique/pince/equerre_pince.fcstd

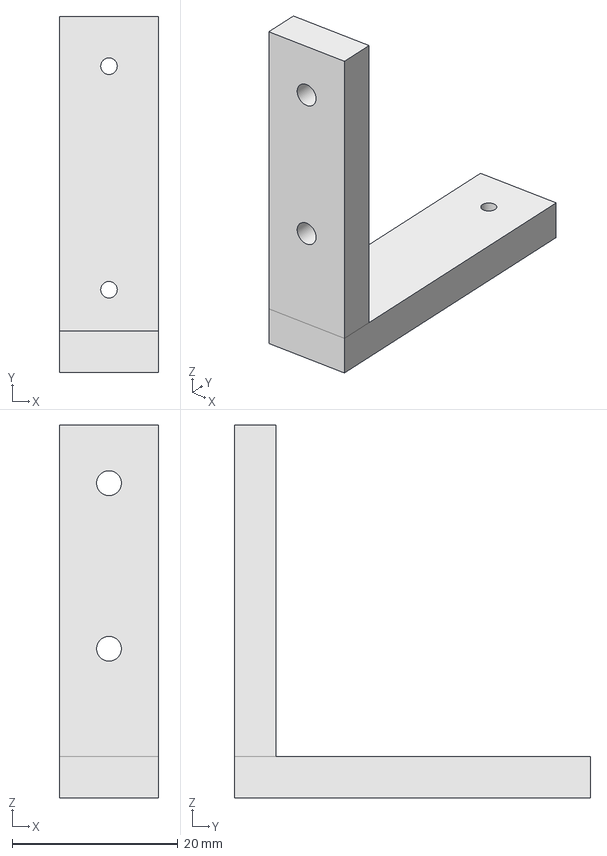
[picture p104: CAD file, 2017-11-16]
Mecanique/pince/equerre_pince.fcstd
12.0 x 43.0 x 45.0 mm
