robotronik/cdfr2018/Mecanique/Base/support_batterie.fcstd

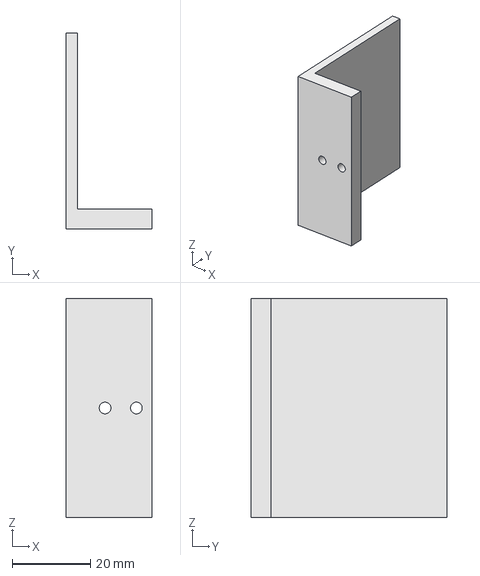
[picture p105: CAD file, 2017-10-31]
Mecanique/Base/support_batterie.fcstd
22.0 x 50.0 x 56.0 mm
