robotronik/cdfr2018/Mecanique/etage_moteur/axe_poulies.fcstd

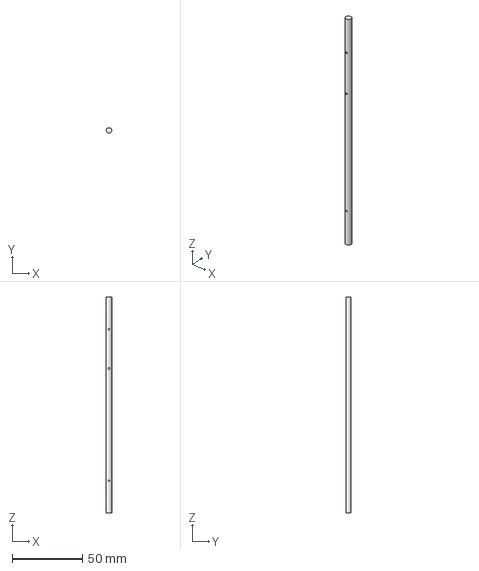
[picture p106: CAD file, 2017-11-06]
Mecanique/etage_moteur/axe_poulies.fcstd
4.00 x 3.81 x 154.0 mm
