robotronik/cdfr2018/Mecanique/pince/plexi_pince.fcstd

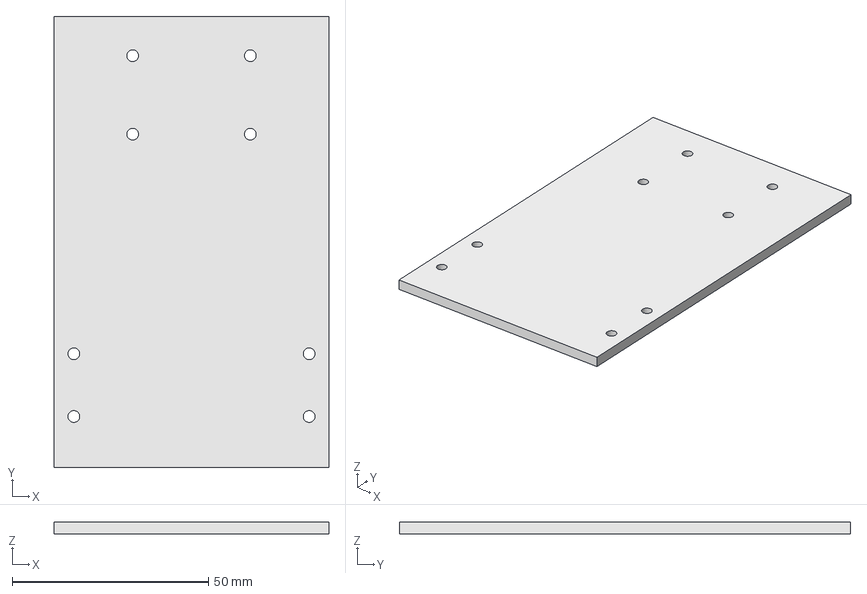
[picture p107: CAD file, 2017-11-16]
Mecanique/pince/plexi_pince.fcstd
70.0 x 115.0 x 3.00 mm
