robotronik/cdfr2018/Mecanique/Base/espaceur_bille.fcstd

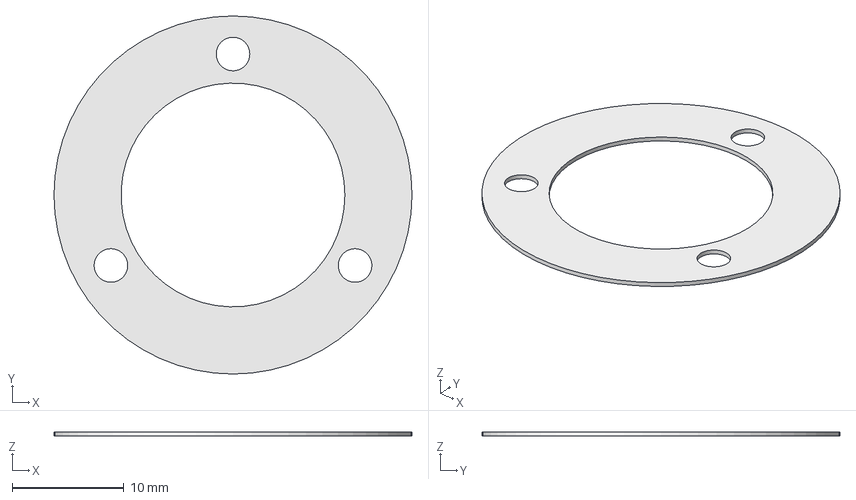
[picture p108: CAD file, 2017-10-30]
Mecanique/Base/espaceur_bille.fcstd
32.0 x 32.0 x 0.4 mm
