robotronik/cdfr2018/Mecanique/etage_moteur/moteur.fcstd

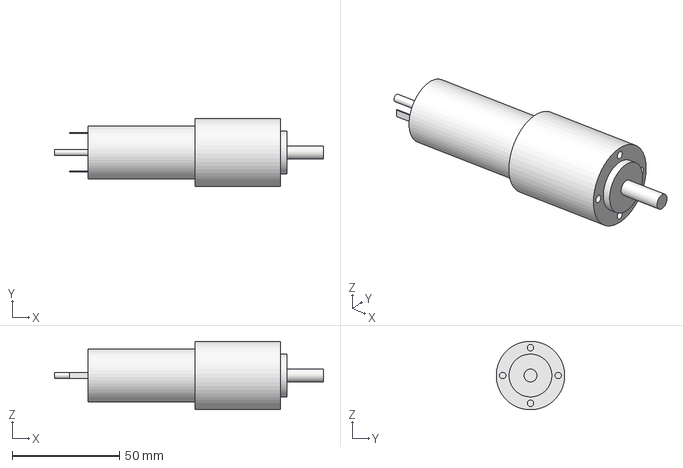
[picture p109: CAD file, 2017-11-06]
Mecanique/etage_moteur/moteur.fcstd
125.7 x 32.0 x 32.0 mm
