robotronik/cdfr2018/Mecanique/pince/pince_g.fcstd

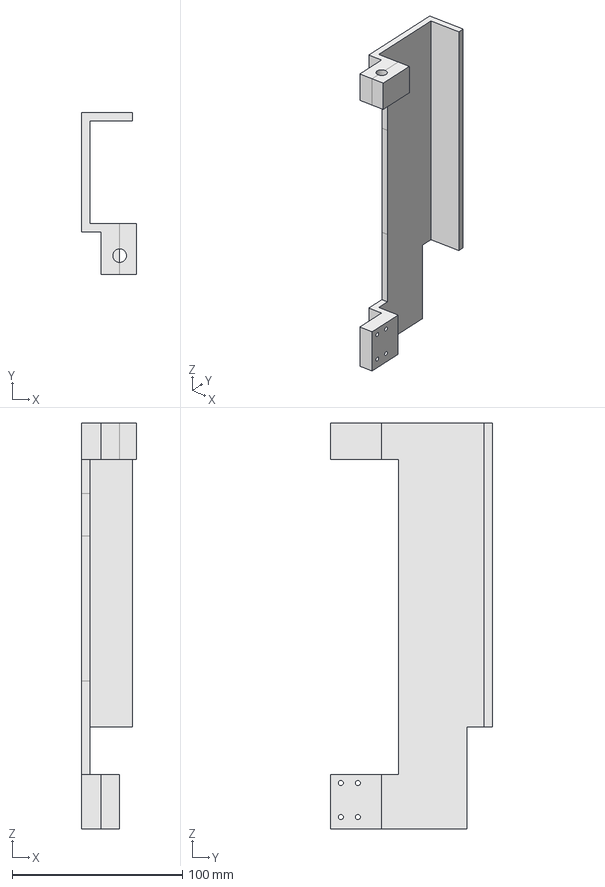
[picture p110: CAD file, 2017-11-13]
Mecanique/pince/pince_g.fcstd
32.5 x 95.0 x 238.5 mm
