robotronik/cdfr2018/Mecanique/etage_moteur/support_etage_2.fcstd

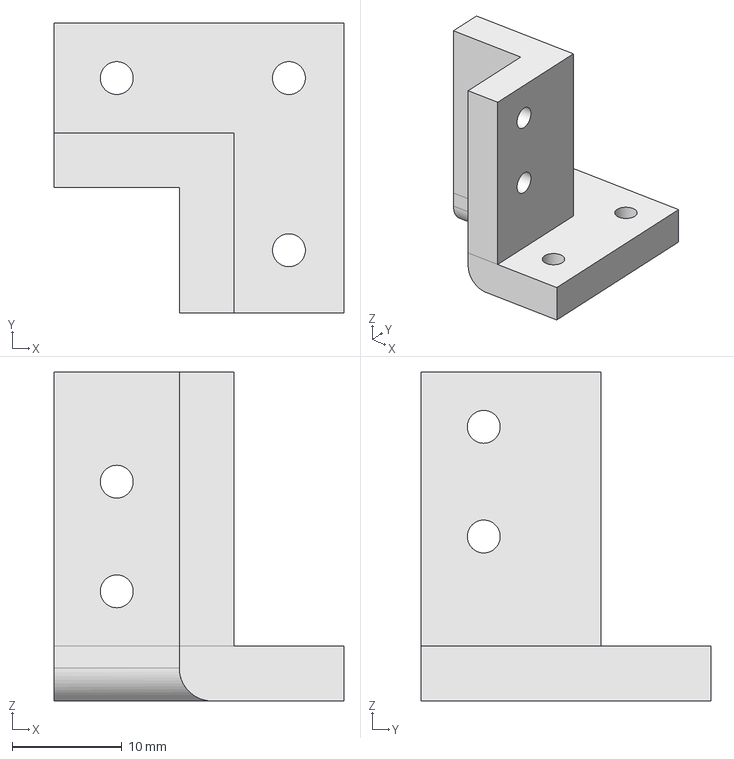
[picture p111: CAD file, 2017-11-04]
Mecanique/etage_moteur/support_etage_2.fcstd
26.4 x 26.4 x 30.0 mm
