robotronik/cdfr2018/Mecanique/pince/roulement.fcstd

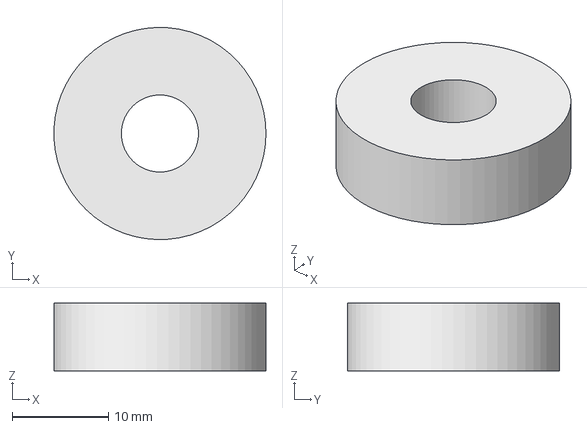
[picture p112: CAD file, 2017-11-02]
Mecanique/pince/roulement.fcstd
22.0 x 22.0 x 7.00 mm
