robotronik/cdfr2018/Mecanique/Base/roue_encodeur.fcstd

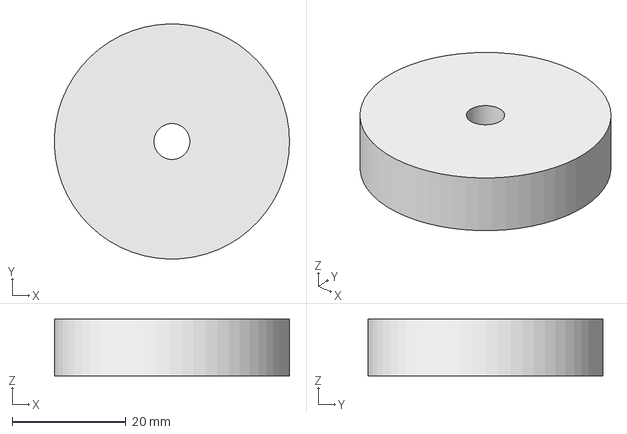
[picture p113: CAD file, 2017-10-25]
Mecanique/Base/roue_encodeur.fcstd
41.3 x 41.3 x 10.0 mm
