robotronik/cdfr2018/Mecanique/etage_moteur/coussinet.fcstd

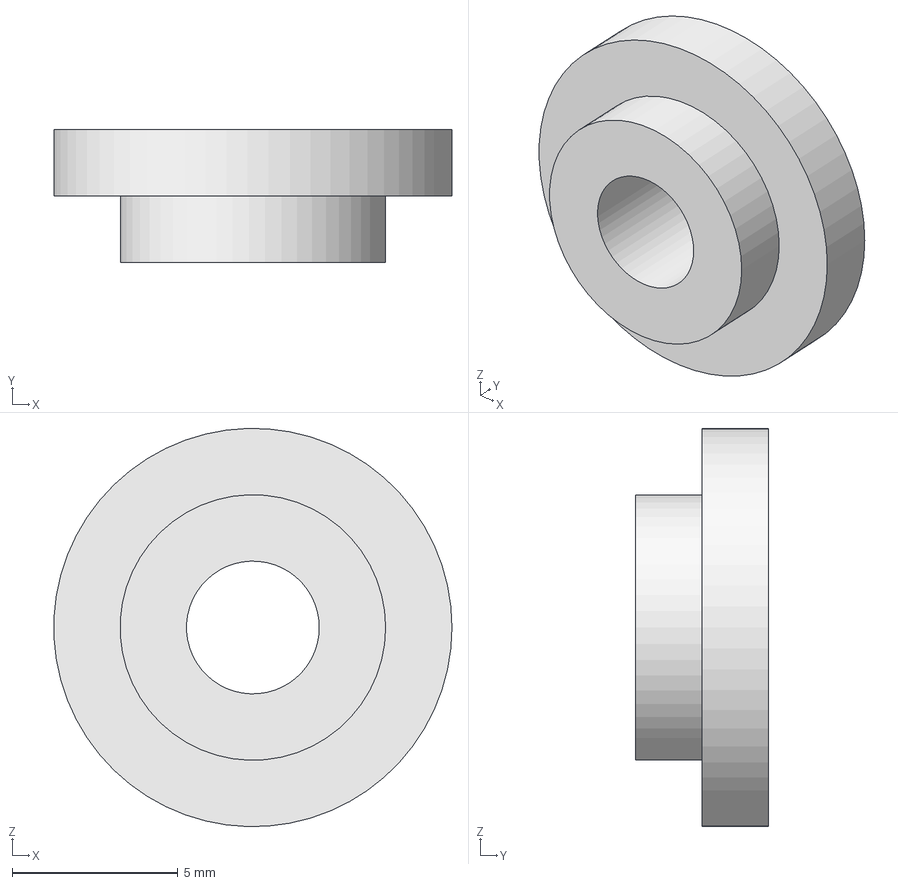
[picture p114: CAD file, 2017-11-04]
Mecanique/etage_moteur/coussinet.fcstd
12.0 x 4.00 x 12.0 mm
