robotronik/cdfr2018/Mecanique/pince/cale_roulement.fcstd

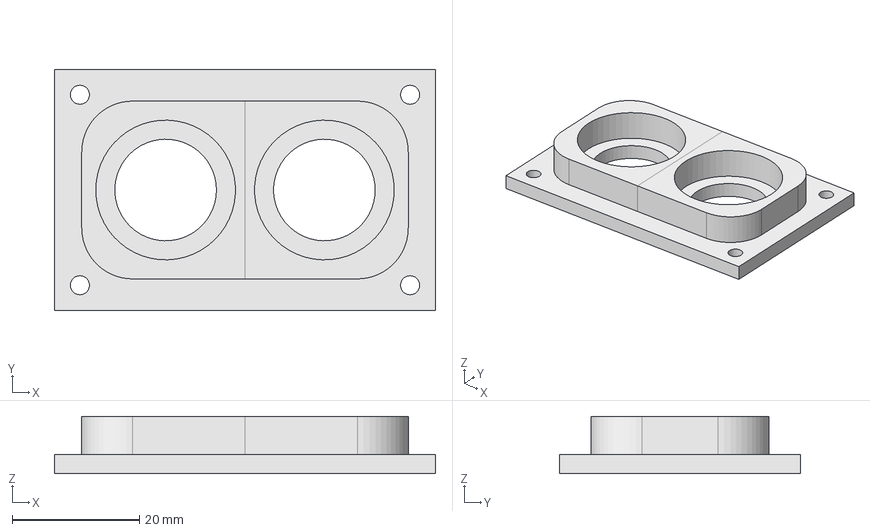
[picture p115: CAD file, 2017-11-02]
Mecanique/pince/cale_roulement.fcstd
60.0 x 38.0 x 9.00 mm
