robotronik/cdfr2018/Mecanique/Base/caisson_batterie.fcstd

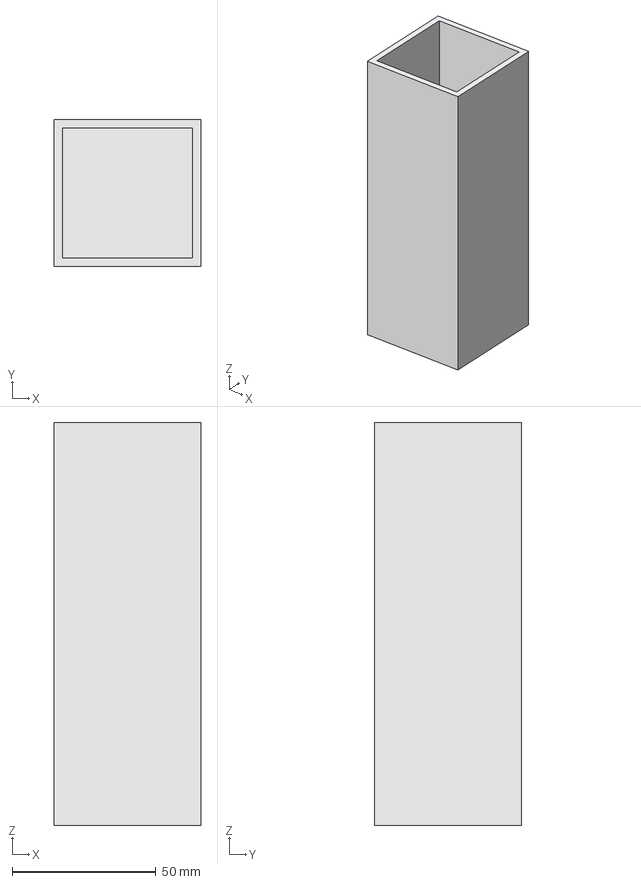
[picture p116: CAD file, 2017-10-25]
Mecanique/Base/caisson_batterie.fcstd
51.0 x 51.0 x 140.0 mm
