robotronik/cdfr2018/Mecanique/etage_moteur/poulie.fcstd

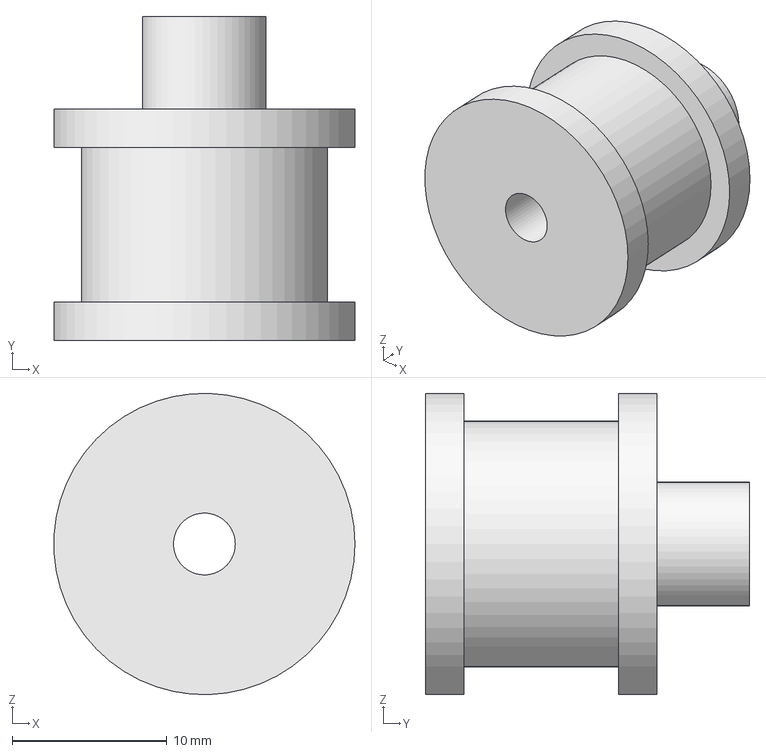
[picture p117: CAD file, 2017-11-04]
Mecanique/etage_moteur/poulie.fcstd
19.5 x 21.0 x 19.5 mm
