robotronik/cdfr2018/Mecanique/pince/axe_pince.fcstd

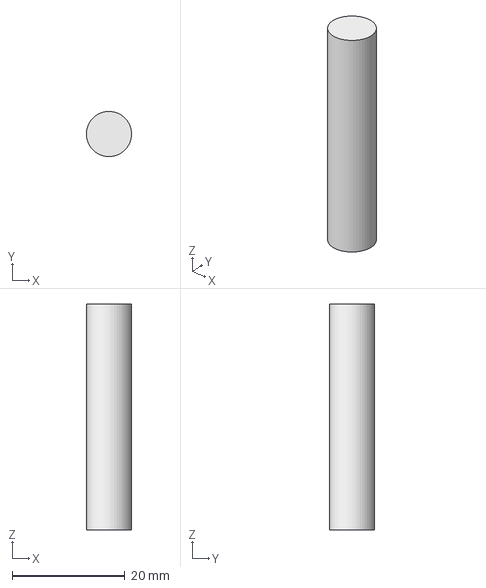
[picture p118: CAD file, 2017-11-02]
Mecanique/pince/axe_pince.fcstd
7.99 x 8.00 x 40.0 mm
