robotronik/cdfr2018/Mecanique/Base/moteur_b.fcstd

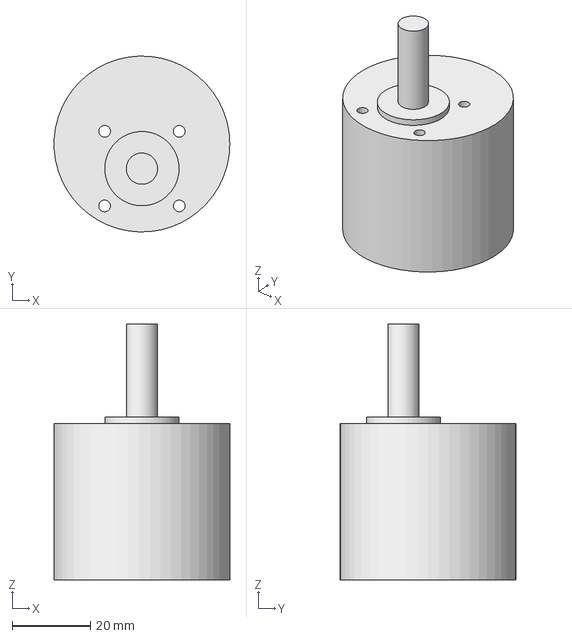
[picture p119: CAD file, 2017-10-24]
Mecanique/Base/moteur_b.fcstd
45.0 x 45.0 x 65.5 mm
