robotronik/cdfr2018/Mecanique/pince/adaptateur_servo_pince.fcstd

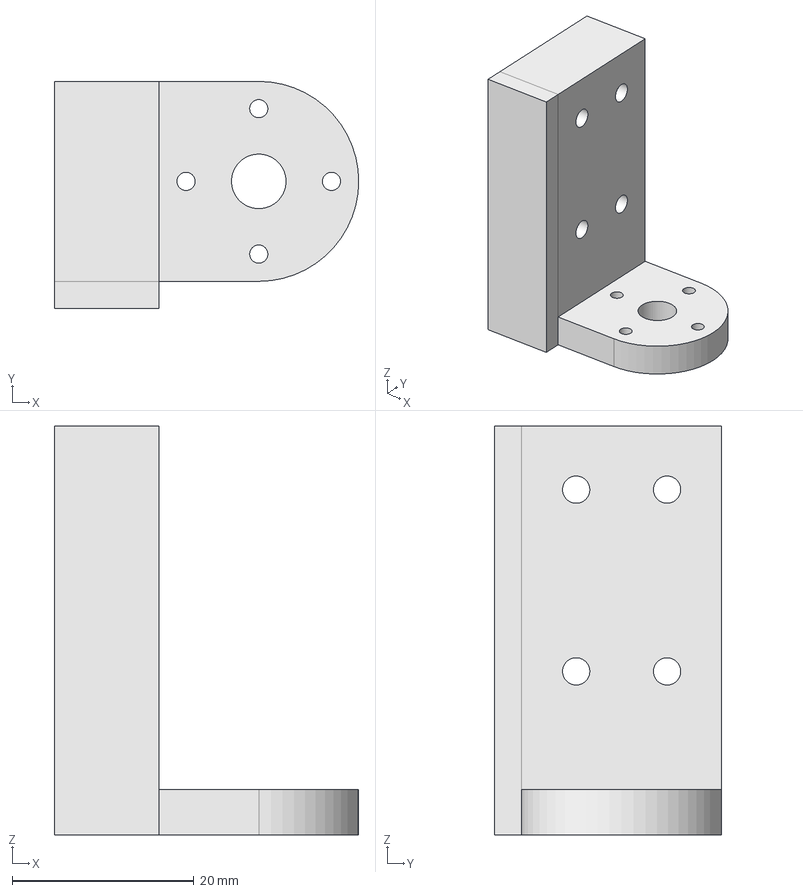
[picture p120: CAD file, 2017-11-02]
Mecanique/pince/adaptateur_servo_pince.fcstd
33.5 x 25.0 x 45.0 mm
