robotronik/cdfr2018/Mecanique/Base/bille.fcstd

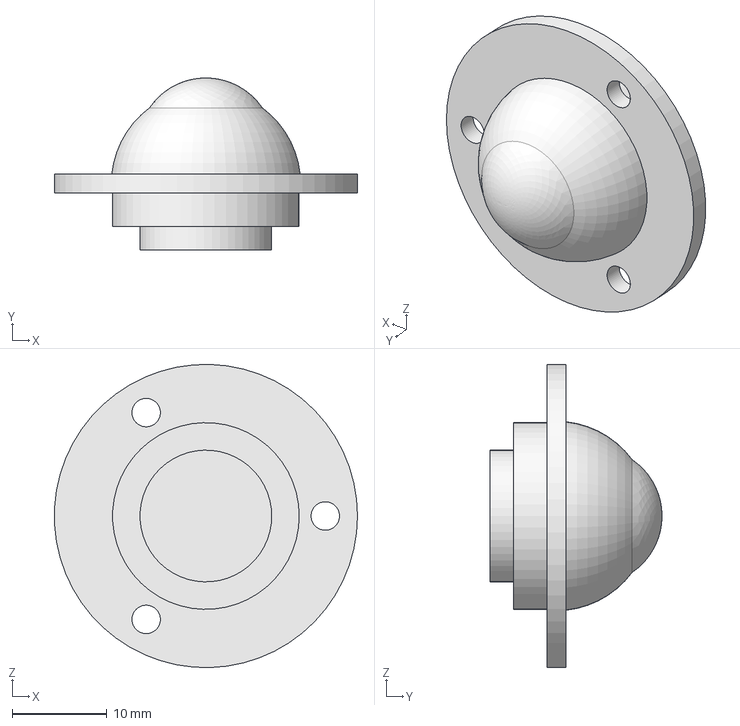
[picture p121: CAD file, 2017-10-14]
Mecanique/Base/bille.fcstd
32.0 x 18.1 x 32.0 mm
