robotronik/cdfr2018/Mecanique/pince/pince_d.fcstd

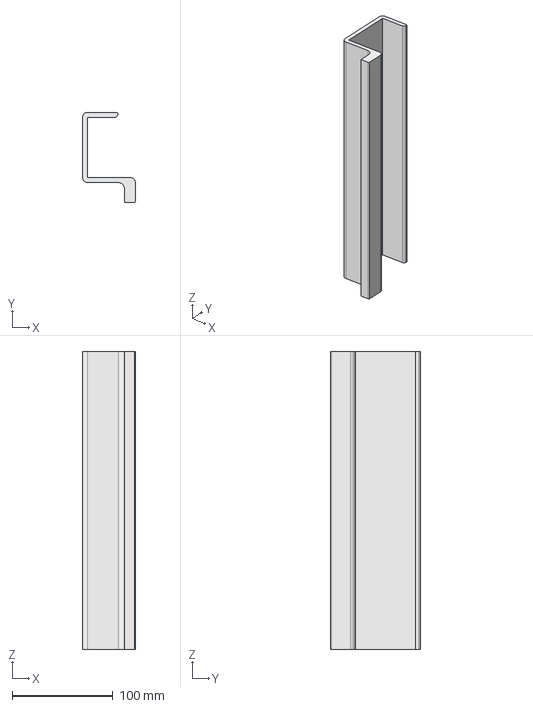
[picture p122: CAD file, 2017-11-01]
Mecanique/pince/pince_d.fcstd
52.5 x 90.0 x 296.5 mm
