robotronik/cdfr2018/Mecanique/Base/roue_bleue.fcstd

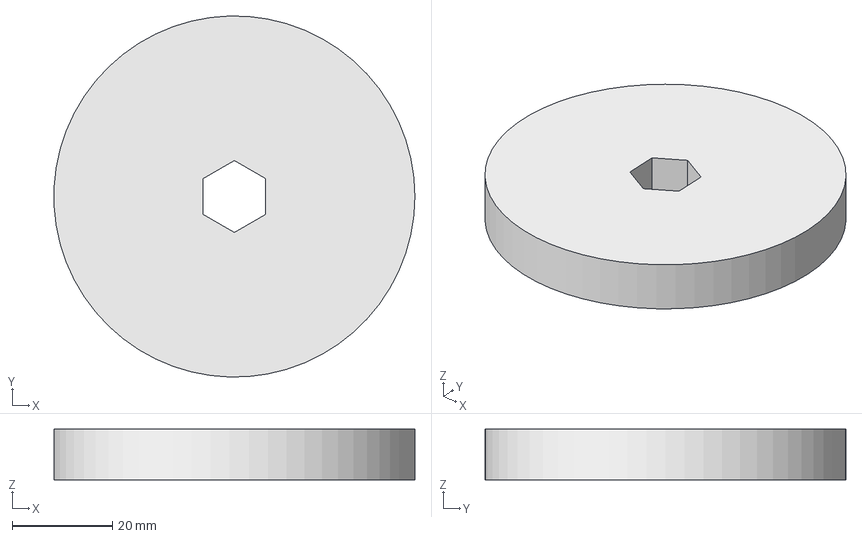
[picture p123: CAD file, 2017-10-14]
Mecanique/Base/roue_bleue.fcstd
71.9 x 72.0 x 10.2 mm
