robotronik/cdfr2018/(list of files, cad)

Other CAD files:
Mecanique/etage_moteur/Assemblage/assemblage_support_coussinet-2.fcstd
Mecanique/Base/Odometrie/Assemblage/odomètre.fcstd
Mecanique/Base/Profiles/Profile_AV.fcstd
Mecanique/Capteurs/encodeur_250.fcstd
Mecanique/ax12/comp_ax12.fcstd
Mecanique/Base/Profiles/Assemblage/profile_ar_1.fcstd
Mecanique/etage_moteur/etage_moteur.fcstd
Mecanique/1er_etage/support_profiles_ar_1.fcstd
Mecanique/Panneau/plaque_av.fcstd
Mecanique/Abeille/structure_abeille.fcstd
Mecanique/Base/Profiles/support_bas_ar_p_1.fcstd
Mecanique/Base/base.fcstd
Mecanique/etage_moteur/support_poulie_moteur.fcstd
Mecanique/Base/support_moteur.fcstd
Mecanique/etage_moteur/support_etage_1.fcstd
Mecanique/Pieces_alu/STEP/freecad/base.fcstd
Mecanique/Pieces_alu/STEP/freecad/etage_moteur.fcstd
Mecanique/Pieces_alu/STEP/freecad/support_moteur.fcstd
Mecanique/Pieces_alu/STEP/freecad/support_poulie.fcstd
Mecanique/Pieces_alu/STEP/freecad/support_poulie_moteur.fcstd
Mecanique/Pieces_alu/base.dxf
Mecanique/Pieces_alu/base.fcstd
Mecanique/Pieces_alu/etage_moteur.dxf
Mecanique/Pieces_alu/etage_moteur.fcstd
Mecanique/Pieces_alu/support_moteur.fcstd
Mecanique/Pieces_alu/support_poulie.fcstd
Mecanique/Pieces_alu/support_poulie_moteur.dxf
Mecanique/Pieces_alu/support_poulie_moteur.fcstd
