robotronik/cdfr2018/Programmation/RobotrOvision/third_test/correct_flip_hd.jpg

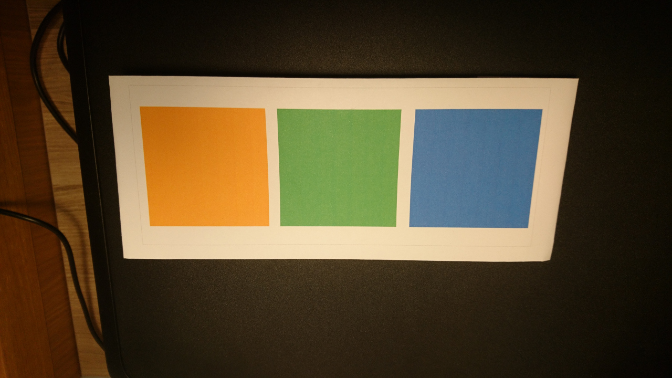
Programmation/RobotrOvision/third_test/correct_flip_hd.jpg
