robotronik/cdfr2018/Electronique/ESP/ESP-B.Cu.pdf

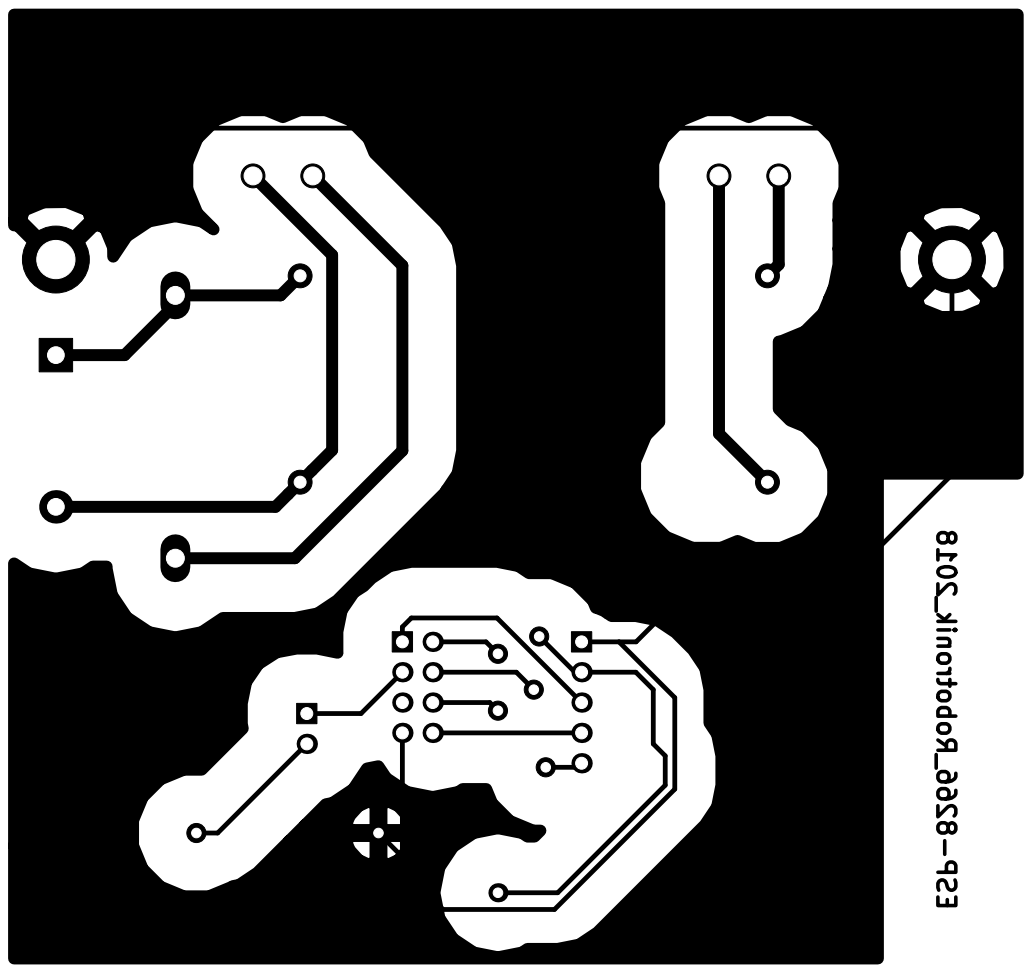
[picture p129: page 1]
