robotronik/cdfr2018/Electronique/Central/central-B.Cu.pdf

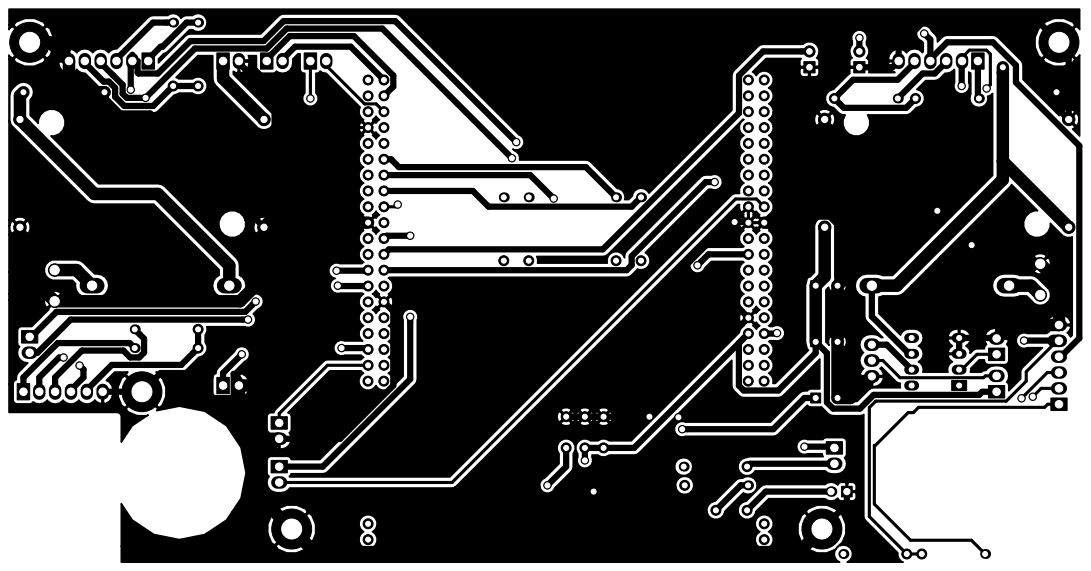
[picture p130: page 1]
