robotronik/cdfr2018/Electronique/Central/central-F.Cu.pdf

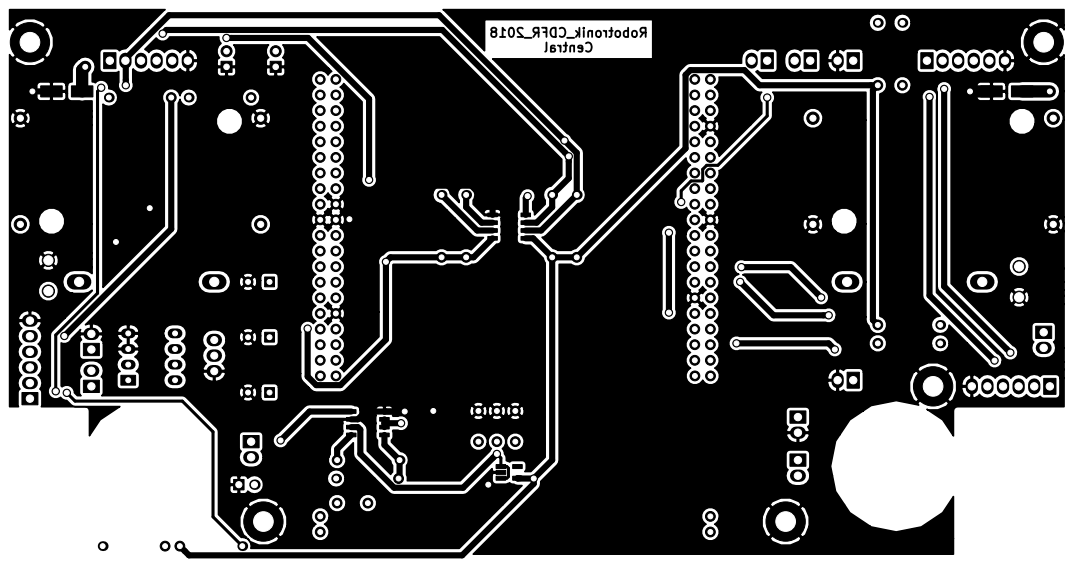
[picture p131: page 1]
