robotronik/cdfr2018/Electronique/hacheurs_brushless/hacheurs_brushless-B.Cu.pdf

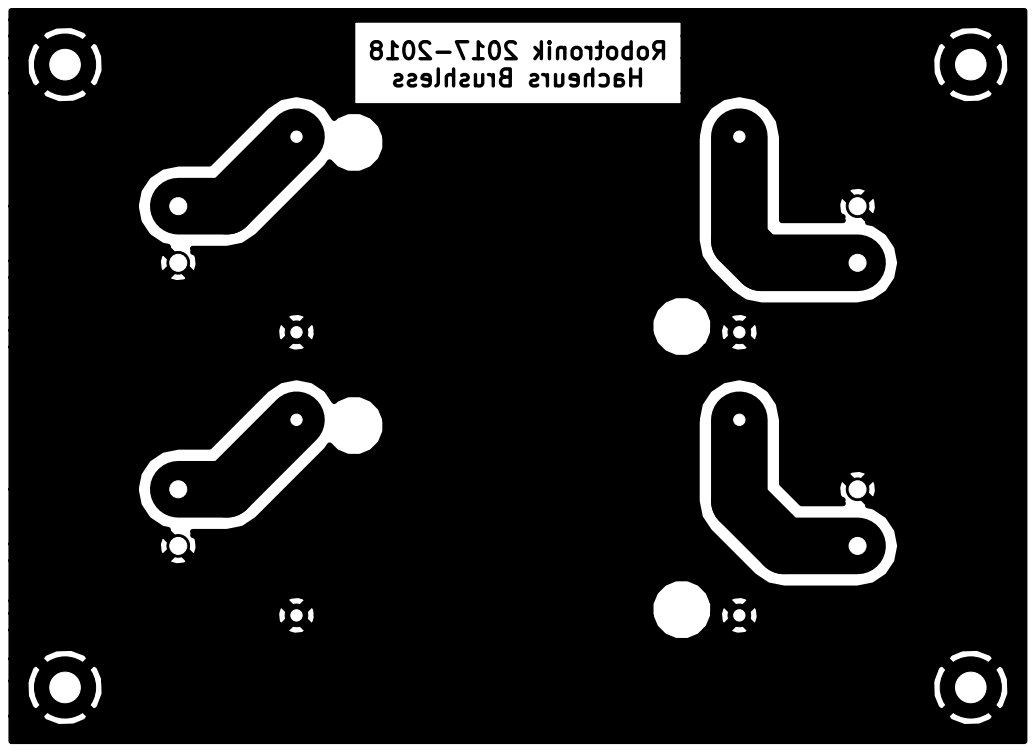
[picture p132: page 1]
