robotronik/cdfr2018/Electronique/hacheurs_drivers_moteurs/hacheurs_drivers_moteurs-B.Cu.pdf

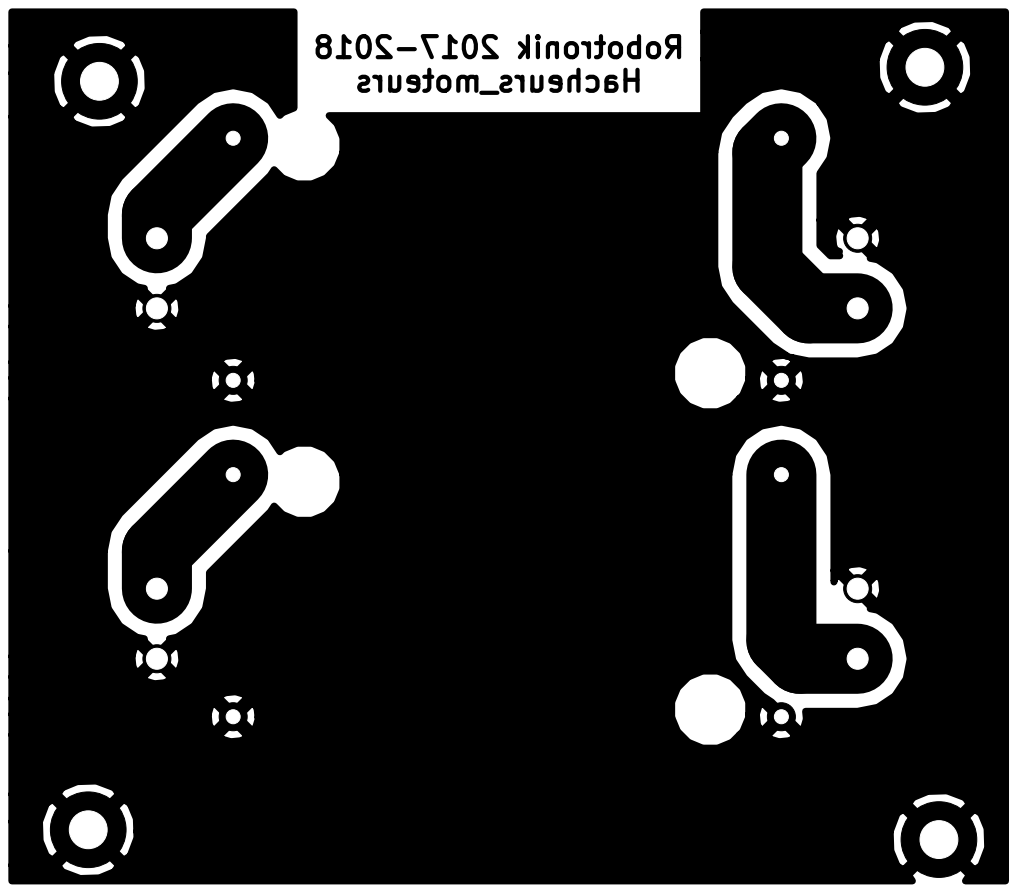
[picture p133: page 1]
