robotronik/cdfr2018/Programmation/Panneau_domotique/serveur/ESP01_Upload_schéma.pdf

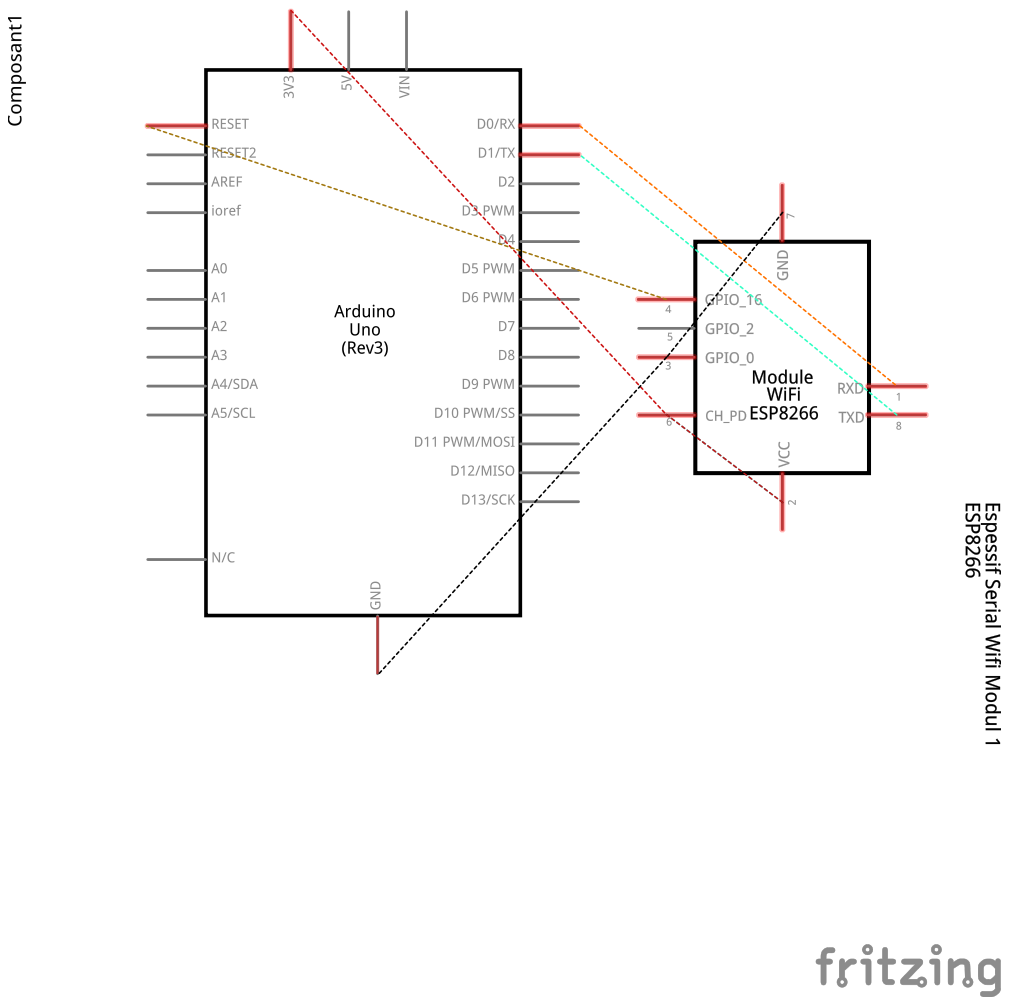
[picture p134: page 1]
