robotronik/cdfr2018/(list of files, drawings)

Other design files:
Programmation/Panneau_domotique/serveur/ESP01_Upload.fzz
