robotronik/cdfr2018/Electronique/Central/central.kicad_pcb

## KiCad design Electronique/Central/central.kicad_pcb (2018-03-30)

Schematic: central.sch

Parts:
D3: LED_Red; LED_D5.0mm
D4: LED_Green; LED_D5.0mm
P1, P6, P7, P8: CONN_02X03; Molex_KK-6410-06_06x2.54mm_Straight
P9: CONN_jack_start; Molex_KK-6410-02_02x2.54mm_Straight
P10: CONN_Selec; Molex_KK-6410-02_02x2.54mm_Straight
P12, P13, P14, P15: CONN_01X02; Molex_KK-6410-02_02x2.54mm_Straight
Q2, Q3: Q_NMOS_DGS; SOT-323_SC-70_Handsoldering
R1, R2, R3, R4: 10kR; R_1206_HandSoldering
R5, R6: 500R; R_1206_HandSoldering
R7, R8, R9, R10, R11, R12, R13, R14: 47kR; R_1206_HandSoldering
U1: Nucleo-64
U10, U11, U12, U13, U14, U15: trou-d3mm; MountingHole_3.2mm_M3_Pad

Connections:
+2.8V: P1.5, P6.5, P7.5, P8.5, Q2.2, Q3.2, R3.1, R4.1, R7.1, R8.1, R9.1, R10.1, R11.1, R12.1, R13.1, R14.1; also elsewhere on the board
+3V3: R1.1, R2.1, U1.17 (+3V3), U1.32 (+3V3)
+5V: U1.37 (E5V); also elsewhere on the board
/Pince_RX: P12.2, U1.54 (PA12)
/Pince_TX: P12.1, U1.53 (PA11)
/Position_RX: P13.2, U1.61 (PA3)
/Position_TX: P13.1, U1.62 (PA2)
GND: D3.1 (K), D4.1 (K), P1.6, P6.6, P7.6, P8.6, P9.2, P10.2, U1.10 (GND), U1.29 (GND), U1.30 (GND), U1.36 (GND), U1.44 (AGND), U1.50 (GND), U1.75 (GND), U10.1, U11.1, U12.1, U13.1, U14.1, U15.1; also elsewhere on the board
I2C_Free_SCL: P15.1, U1.71 (PB6)
I2C_Free_SDA: P15.2, U1.9 (PB7)
I2C_TOF_SCL: Q2.1, R2.2, U1.68 (PA8)
I2C_TOF_SDA: Q3.1, R1.2, U1.66 (PB4)
unnamed: D3.2 (A), R6.1
unnamed: D4.2 (A), R5.1
unnamed: P1.1, R14.2
unnamed: P1.2, P6.2, P7.2, P8.2, Q2.3, R3.2
unnamed: P1.3, R10.2
unnamed: P1.4, P6.4, P7.4, P8.4, Q3.3, R4.2
unnamed: P6.1, R7.2
unnamed: P6.3, R11.2
unnamed: P7.1, R8.2
unnamed: P7.3, R12.2
unnamed: P8.1, R9.2
unnamed: P8.3, R13.2
unnamed: P9.1, U1.59 (PC8)
unnamed: P10.1, U1.58 (PC6)
unnamed: R5.2, U1.73 (PA6)
unnamed: R6.2, U1.72 (PA7)
RASP_RX: P14.2, U1.63 (PA10)
RASP_TX: P14.1, U1.69 (PA9)

Notes on the sheet:
FIXED!
Use BSS138

Schematic: Power.sch

Parts:
C1, C2: 1uC; C_Rect_L7.0mm_W2.5mm_P5.00mm
C5: 10uC; CP_Radial_D8.0mm_P3.50mm
C7: CP; CP_Radial_D8.0mm_P3.50mm
D1, D2: D; D_SMA_Handsoldering
F1, F2: FUSE; Fuseholder5x20_horiz_SemiClosed_Casing10x25mm
P11: CONN_01X02; Molex_KK-6410-02_02x2.54mm_Straight
R15: 3.3kR; R_1206_HandSoldering
R16: 470R; R_1206_HandSoldering
R17: 330R; R_1206_HandSoldering
R18: 270R; R_1206_HandSoldering
U2, U3: LM317_SOT223; SOT-223-3Lead_TabPin2
U5, U6: B_Plug_5mm; B plug 5mm
U7, U8: DSN2596

Connections:
+2.8V: C2.1, R18.1, U3.2; also elsewhere on the board
+5V: C1.1, C7.1, U3.3, U7.4 (OUT+); also elsewhere on the board
+9V: R16.1, U2.2; also elsewhere on the board
/Power/Rasp_power: C5.1, P11.1, U8.4 (OUT+)
BATT: D1.1 (K), F1.2, U2.3, U7.1 (IN+)
GND: C1.2, C2.2, C5.2, C7.2, D1.2 (A), D2.2 (A), P11.2, R15.2, R17.2, U5.2, U6.2, U7.2 (IN-), U7.3 (OUT-), U8.2 (IN-), U8.3 (OUT-); also elsewhere on the board
unnamed: D2.1 (K), F2.2, U8.1 (IN+)
unnamed: F1.1, U5.1
unnamed: F2.1, U6.1
unnamed: R15.1, R16.2, U2.1
unnamed: R17.1, R18.2, U3.1

Notes on the sheet:
Non polarisé de plus grande valeur possible
FIXED!

Schematic: Audio.sch

Parts:
C3: 1uC; CP_Radial_D8.0mm_P3.50mm
C4: 390nC; C_Rect_L7.0mm_W2.5mm_P5.00mm
C6: C; C_Rect_L7.0mm_W2.5mm_P5.00mm
P2: CONN_Speaker; Molex_KK-6410-02_02x2.54mm_Straight
P3: CONN_jack; Pin_Header_Straight_1x02_Pitch2.54mm
R19, R21: 20kR; R_1206_HandSoldering
U4: TDA6205; SOIC-8_3.9x4.9mm_Pitch1.27mm

Connections:
+5V: C6.1, U4.6; also elsewhere on the board
GND: C3.2, C6.2, P3.1, U4.1, U4.7; also elsewhere on the board
unnamed: C3.1, U4.2, U4.3
unnamed: C4.1, R19.2
unnamed: C4.2, P3.2
unnamed: P2.1, U4.8
unnamed: P2.2, R21.1, U4.5
unnamed: R19.1, R21.2, U4.4

Notes on the sheet:
LM4991
G=2*R21/R19
FIXED!

Schematic: LED.sch

Parts:
P4: CONN_jacky_led; Molex_KK-6410-02_02x2.54mm_Straight
P5: CONN_LED; Molex_KK-6410-02_02x2.54mm_Straight
Q1: IRF540N; TO-220
U9: MC34152; DIP-8_W7.62mm_LongPads

Connections:
+5V: P5.1; also elsewhere on the board
+9V: U9.6 (Vcc); also elsewhere on the board
GND: P4.2, Q1.3 (S), U9.3 (GND), U9.4 (IN_B); also elsewhere on the board
unnamed: P4.1, U9.2 (IN_A)
unnamed: P5.2, Q1.2 (D)
unnamed: Q1.1 (G), U9.7 (OUT_A)

Notes on the sheet:
Jacky tuning

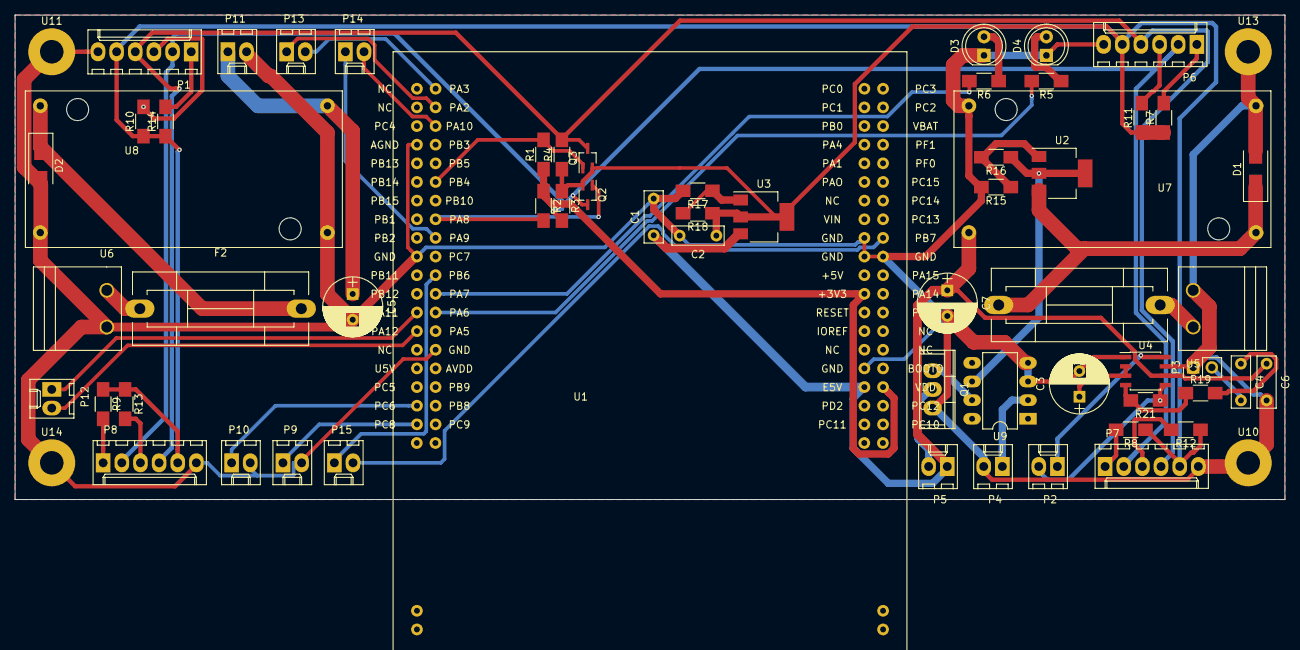
[picture p135: board central.kicad_pcb from above]

Board: 2 copper layers, 173.0 x 66.0 mm, 64 parts (0 on the bottom side), 47 nets.
