robotronik/cdfr2018/Electronique/ESP/ESP.kicad_pcb

## KiCad design Electronique/ESP/ESP.kicad_pcb (2018-03-22)

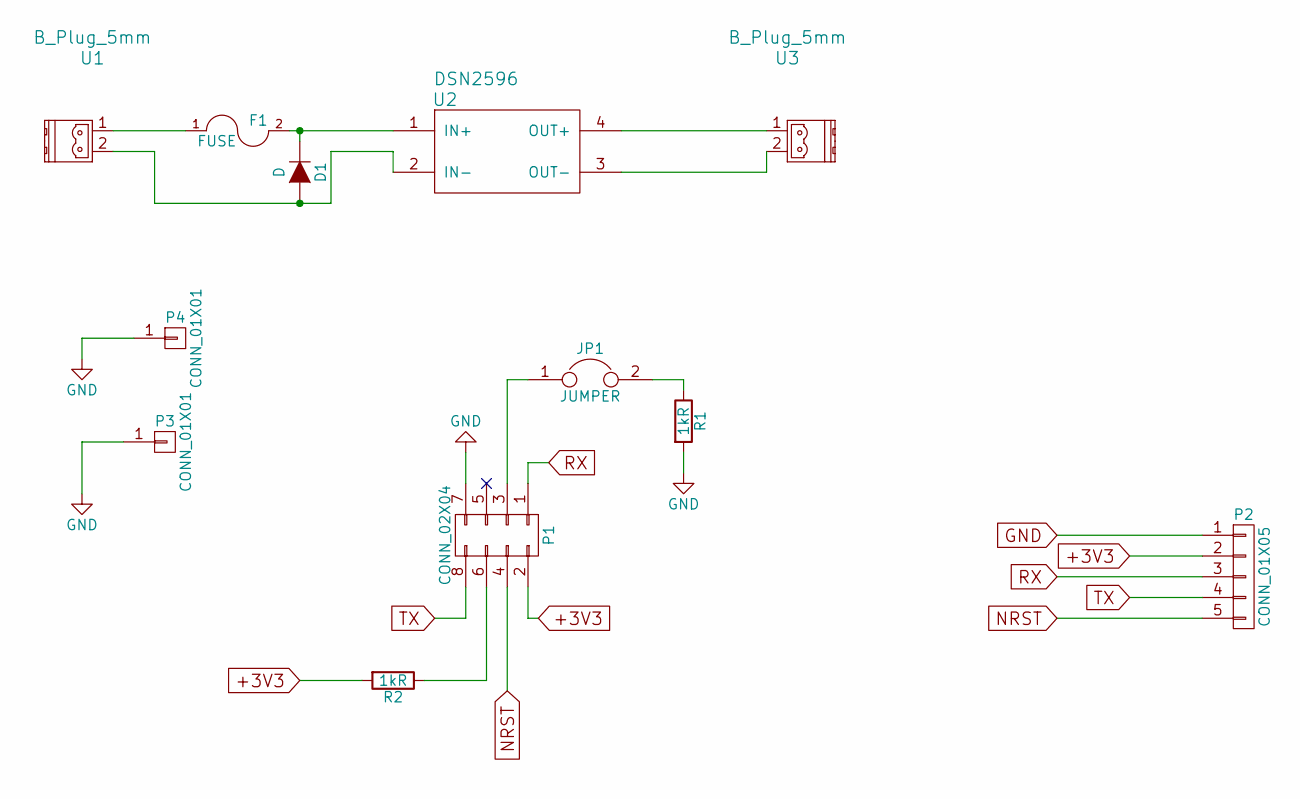
[picture p136: schematic ESP.sch]

Parts:
D1: D; D_5W_P12.70mm_Horizontal
F1: FUSE; Fuseholder5x20_horiz_SemiClosed_Casing10x25mm
JP1: JUMPER; Pin_Header_Straight_1x02_Pitch2.54mm
P1: CONN_02X04; Pin_Header_Straight_2x04_Pitch2.54mm
P2: CONN_01X05; Pin_Header_Angled_1x05_Pitch2.54mm
P3, P4: CONN_01X01; MountingHole_3.2mm_M3_DIN965_Pad
R1, R2: 1kR; R_Axial_DIN0207_L6.3mm_D2.5mm_P15.24mm_Horizontal
U1, U3: B_Plug_5mm; B plug 5mm
U2: DSN2596

Connections:
+3V3: P1.2, P2.2, R2.2
GND: P1.7, P2.1, P3.1, P4.1, R1.2
NRST: P1.4, P2.5
unnamed: D1.1 (K), F1.2, U2.1 (IN+)
unnamed: D1.2 (A), U1.2, U2.2 (IN-)
unnamed: F1.1, U1.1
unnamed: JP1.1, P1.3
unnamed: JP1.2, R1.1
unnamed: P1.6, R2.1
unnamed: U2.3 (OUT-), U3.2
unnamed: U2.4 (OUT+), U3.1
RX: P1.1, P2.3
TX: P1.8, P2.4

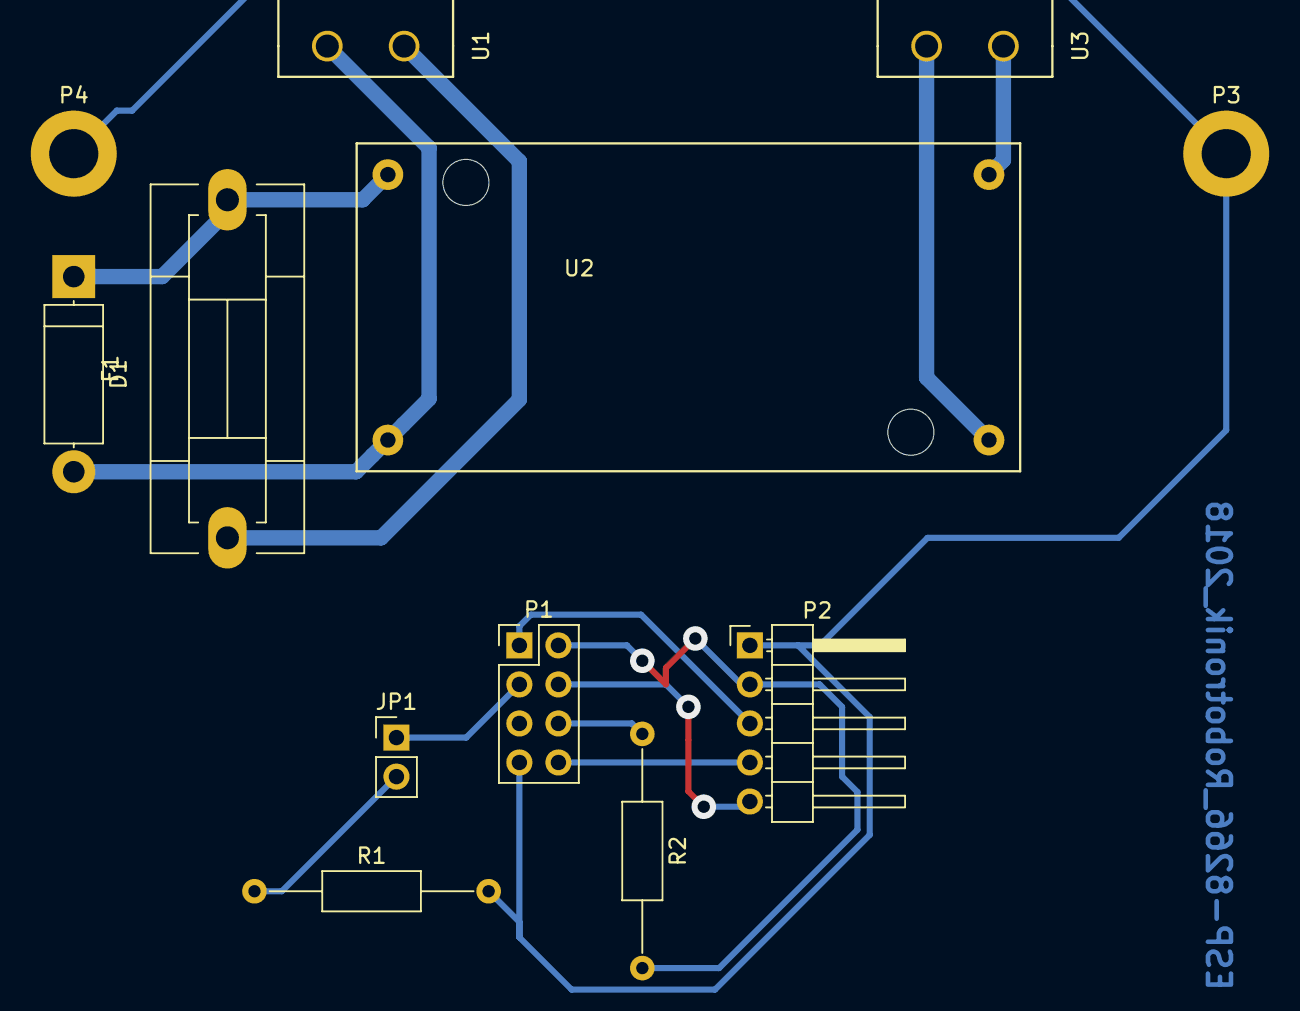
[picture p137: board ESP.kicad_pcb from above]

Board: 2 copper layers, 12 parts (0 on the bottom side), 13 nets.
