robotronik/cdfr2018/Electronique/hacheurs_brushless/hacheurs_brushless.kicad_pcb

## KiCad design Electronique/hacheurs_brushless/hacheurs_brushless.kicad_pcb (2018-02-05)

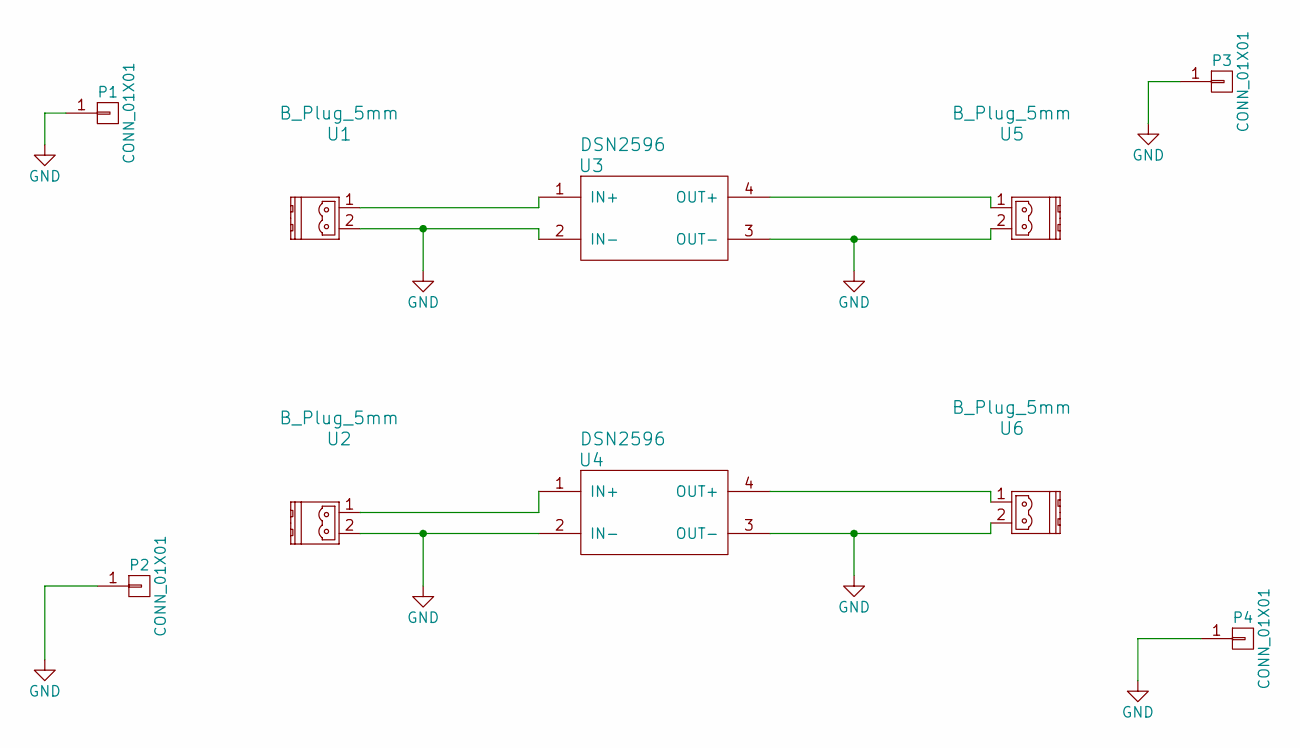
[picture p138: schematic hacheurs_brushless.sch]

Parts:
P1, P2, P3, P4: CONN_01X01; MountingHole_2.7mm_Pad
U1, U2, U5, U6: B_Plug_5mm; B plug 5mm
U3, U4: DSN2596

Connections:
GND: P1.1, P2.1, P3.1, P4.1, U1.2, U2.2, U3.2 (IN-), U3.3 (OUT-), U4.2 (IN-), U4.3 (OUT-), U5.2, U6.2
unnamed: U1.1, U3.1 (IN+)
unnamed: U2.1, U4.1 (IN+)
unnamed: U3.4 (OUT+), U5.1
unnamed: U4.4 (OUT+), U6.1

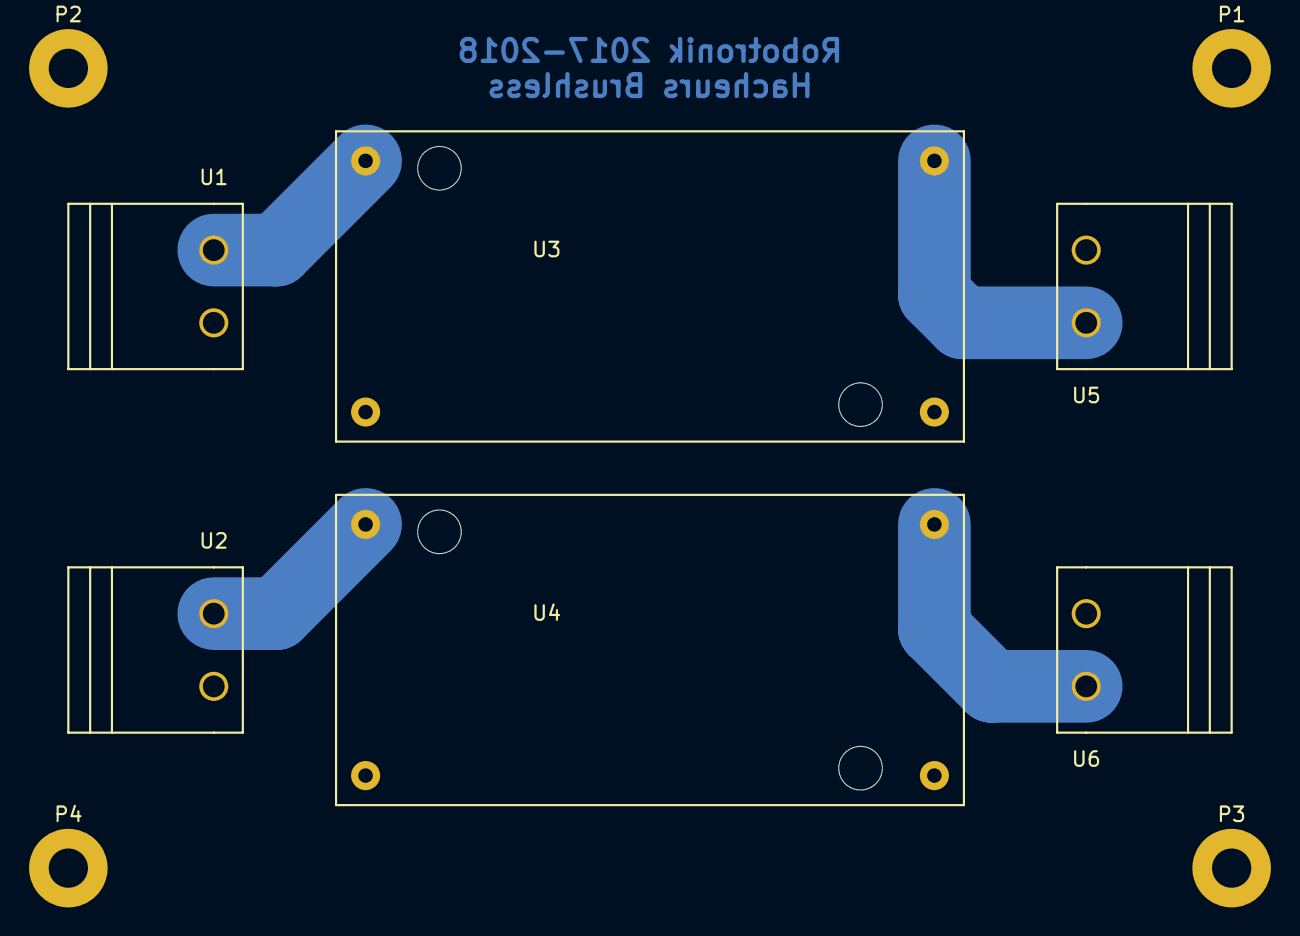
[picture p139: board hacheurs_brushless.kicad_pcb from above]

Board: 2 copper layers, 10 parts (0 on the bottom side), 5 nets.
