robotronik/cdfr2018/Electronique/driver_moteurs/driver-moteurs.kicad_pcb

## KiCad design Electronique/driver_moteurs/driver-moteurs.kicad_pcb (2018-01-05)

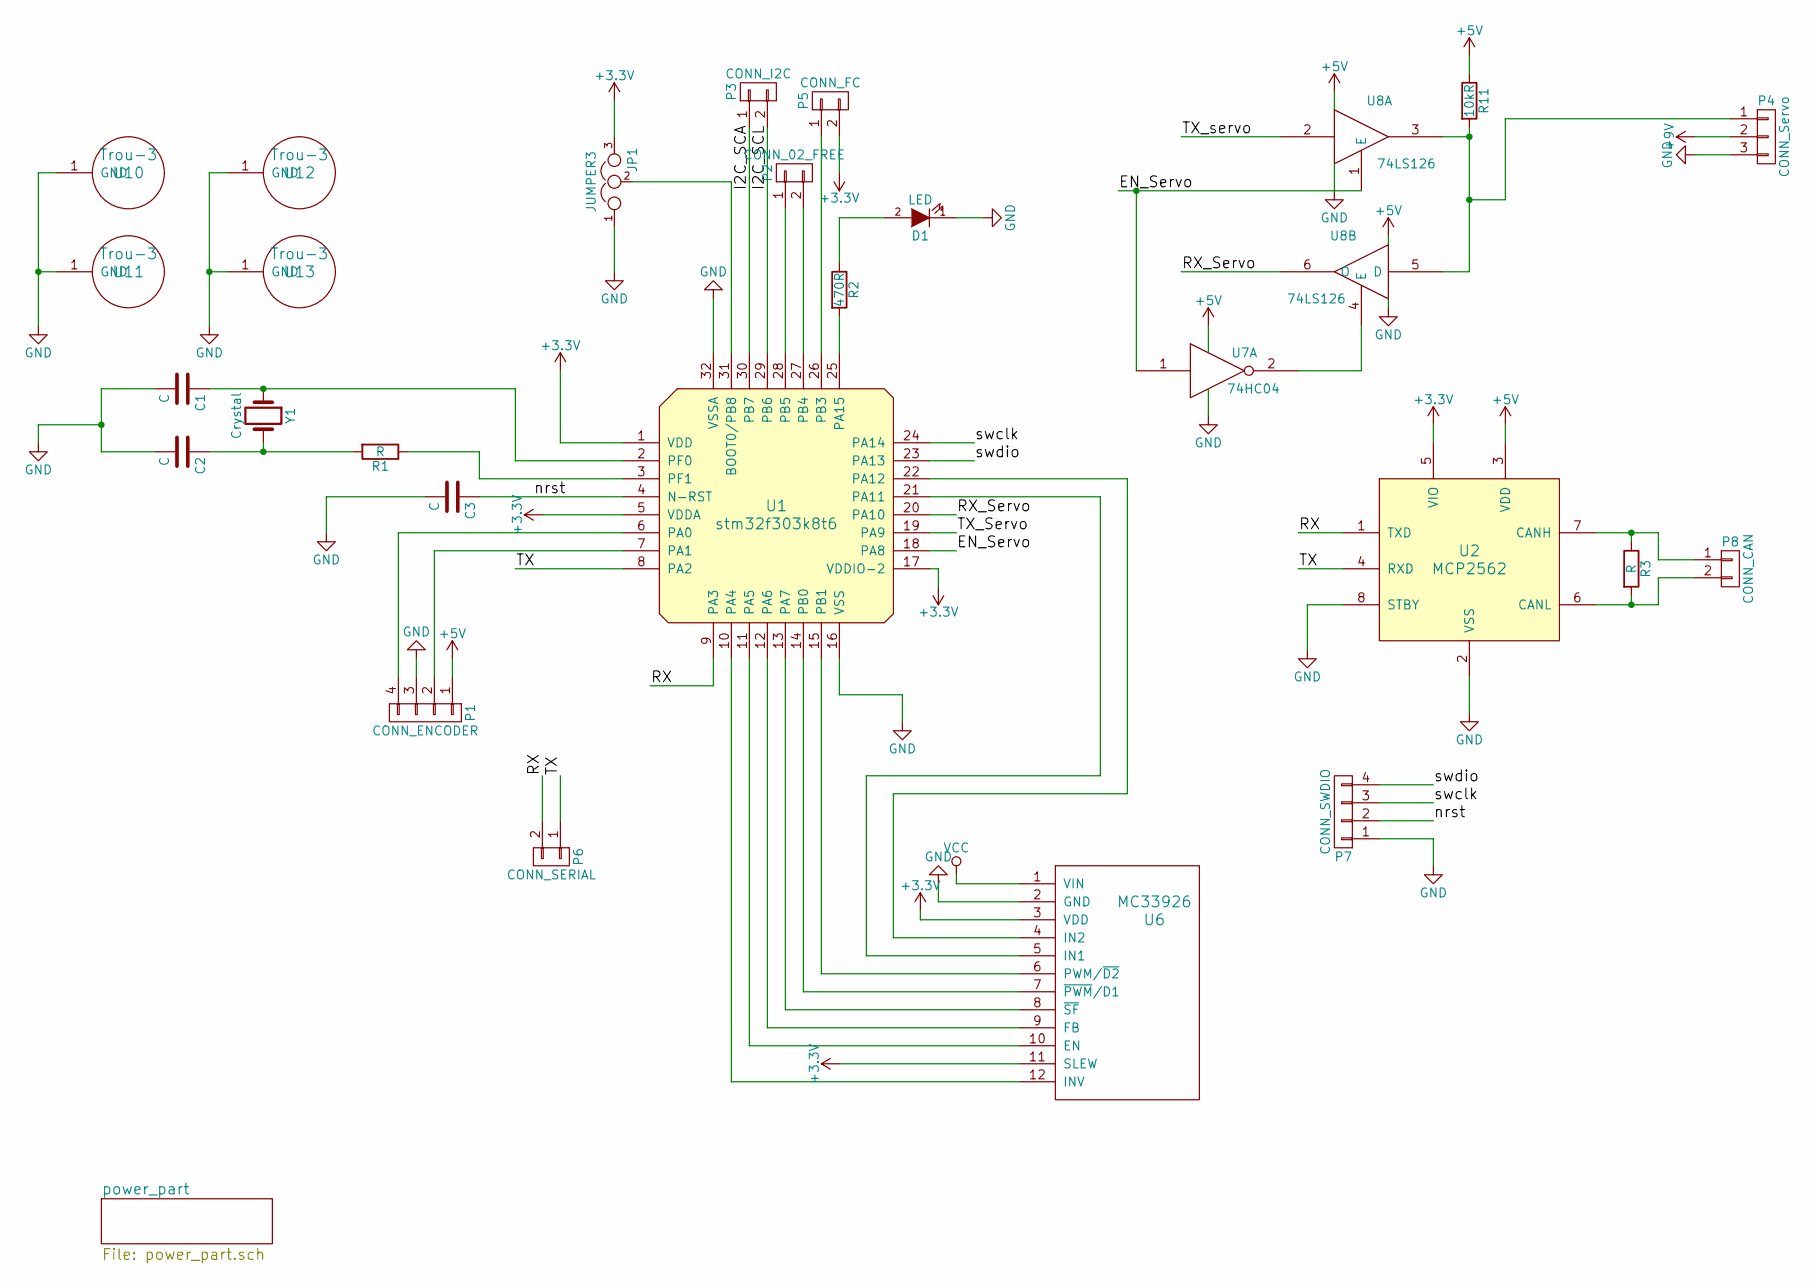
[picture p147: schematic driver-moteurs.sch]

Parts:
C1, C2, C3: C; C_1206_HandSoldering
D1: LED; D_SMA-SMB_Universal_Handsoldering
JP1: JUMPER3; Pin_Header_Straight_1x03_Pitch2.54mm
P1: CONN_ENCODER; Molex_KK-6410-04_04x2.54mm_Straight
P2: CONN_02_FREE; Molex_KK-6410-02_02x2.54mm_Straight
P3: CONN_I2C; Molex_KK-6410-02_02x2.54mm_Straight
P4: CONN_Servo; Molex_KK-6410-03_03x2.54mm_Straight
P5: CONN_FC; Molex_KK-6410-02_02x2.54mm_Straight
P6: CONN_SERIAL; Molex_KK-6410-02_02x2.54mm_Straight
P7: CONN_SWDIO; Molex_KK-6410-04_04x2.54mm_Straight
P8: CONN_CAN; Molex_KK-6410-02_02x2.54mm_Straight
R1, R3: R; R_1206_HandSoldering
R2: 470R; R_1206_HandSoldering
R11: 10kR; R_1206_HandSoldering
U1: stm32f303k8t6; LQFP-32_7x7mm_Pitch0.8mm
U2: MCP2562; SOIC-8_3.9x4.9mm_Pitch1.27mm
U6: MC33926
U7: 74HC04; DIP-14_W7.62mm_Socket
U8: 74LS126; DIP-14_W7.62mm_Socket
U10, U11, U12, U13: Trou-3
Y1: Crystal; Crystal_HC18-U_Vertical

Connections:
+3V3: JP1.3, P5.2, U1.1 (VDD), U1.5 (VDDA), U1.17 (VDDIO-2), U2.5 (VIO), U6.3 (VDD), U6.11 (SLEW); also elsewhere on the board
+5V: P1.1, R11.1, U2.3 (VDD), U7.14 (VCC), U8.14 (VCC); also elsewhere on the board
+9V: P4.2; also elsewhere on the board
/I2C_SCA: P3.1, U1.30 (PB7)
/I2C_SCL: P3.2, U1.29 (PB6)
/RX: P6.2, U1.9 (PA3), U2.1 (TXD)
/RX_Servo: U1.20 (PA10), U8.6 (O)
/TX: P6.1, U1.8 (PA2), U2.4 (RXD)
/TX_Servo: U1.19 (PA9), U8.2
/nrst: C3.1, P7.2, U1.4 (N-RST)
/swclk: P7.3, U1.24 (PA14)
/swdio: P7.4, U1.23 (PA13)
unnamed: C1.1, U1.2 (PF0), Y1.1
unnamed: C2.1, R1.2, Y1.2
unnamed: D1.2 (A), R2.1
unnamed: JP1.2, U1.31 (BOOT0/PB8)
unnamed: P1.2, U1.7 (PA1)
unnamed: P1.4, U1.6 (PA0)
unnamed: P2.1, U1.28 (PB5)
unnamed: P2.2, U1.27 (PB4)
unnamed: P4.1, R11.2, U8.3, U8.5 (D)
unnamed: P5.1, U1.26 (PB3)
unnamed: P8.1, R3.1, U2.7 (CANH)
unnamed: P8.2, R3.2, U2.6 (CANL)
unnamed: R1.1, U1.3 (PF1)
unnamed: R2.2, U1.25 (PA15)
unnamed: U1.10 (PA4), U6.12 (INV)
unnamed: U1.11 (PA5), U6.10 (EN)
unnamed: U1.12 (PA6), U6.9 (FB)
unnamed: U1.13 (PA7), U6.8 (~SF)
unnamed: U1.14 (PB0), U6.7 (~PWM~/D1)
unnamed: U1.15 (PB1), U6.6 (PWM/~D2)
unnamed: U1.21 (PA11), U6.5 (IN1)
unnamed: U1.22 (PA12), U6.4 (IN2)
unnamed: U7.2, U8.4 (E)
VDD: U6.1 (VIN); also elsewhere on the board

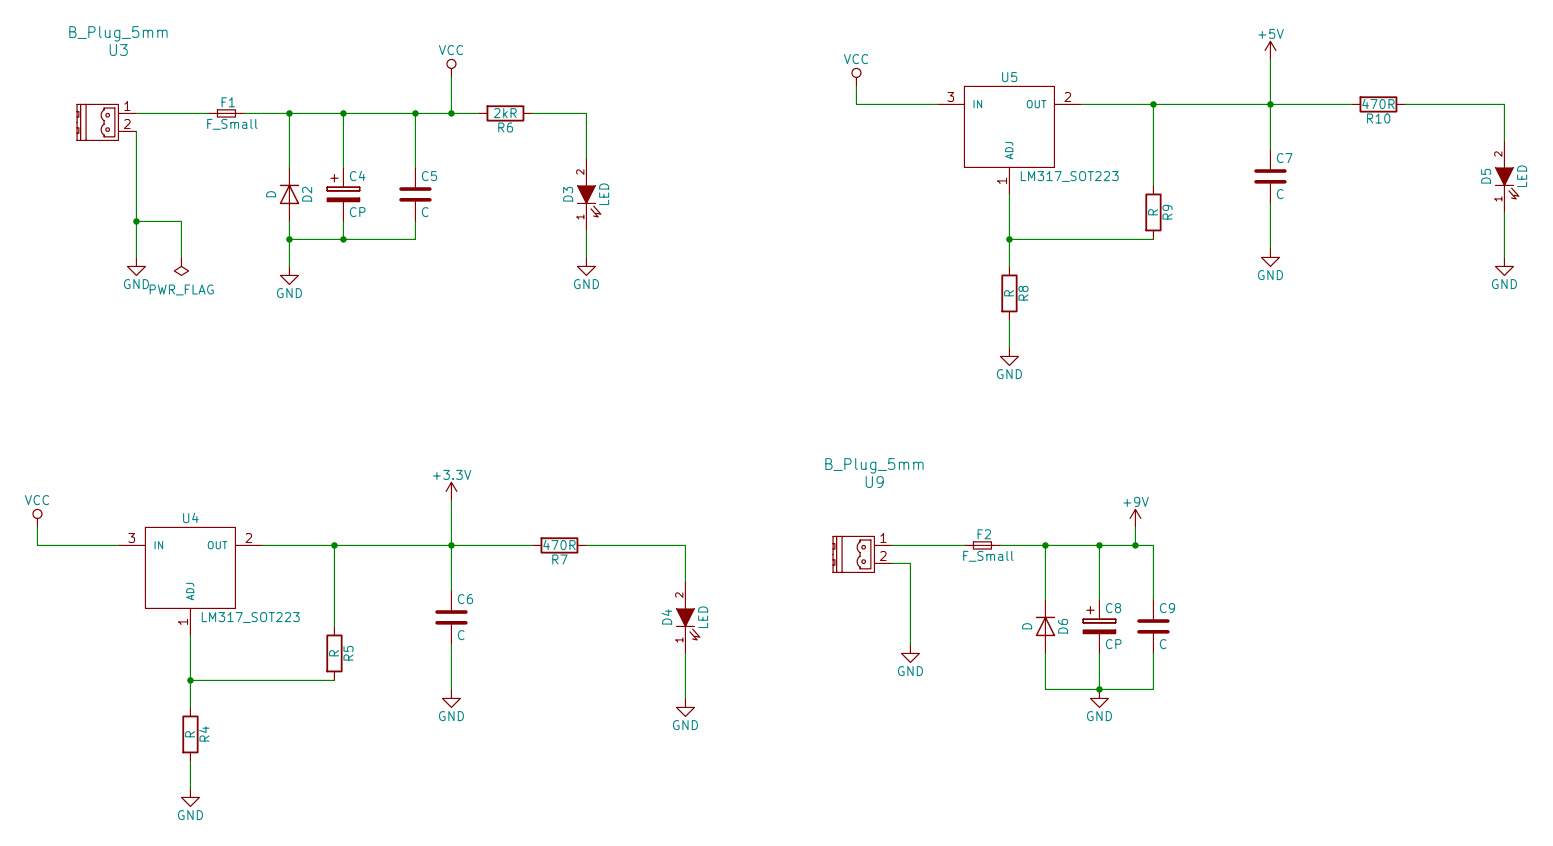
[picture p148: schematic power_part.sch]

Parts:
C4, C8: CP; CP_Radial_D8.0mm_P3.50mm
C5, C6, C7, C9: C; C_1206_HandSoldering
D2, D6: D; D_SMA_Handsoldering
D3, D4, D5: LED; D_SMA-SMB_Universal_Handsoldering
F1, F2: F_Small; Fuseholder5x20_horiz_SemiClosed_Casing10x25mm
R4, R5, R8, R9: R; R_1206_HandSoldering
R6: 2kR; R_1206_HandSoldering
R7, R10: 470R; R_1206_HandSoldering
U3, U9: B_Plug_5mm; B plug 5mm
U4: LM317_SOT223; SOT-223-3Lead_TabPin2
U5: LM317_SOT223

Connections:
+3V3: C6.1, R5.1, R7.2, U4.2 (OUT); also elsewhere on the board
+5V: C7.1, R9.1, R10.2, U5.2 (OUT); also elsewhere on the board
+9V: C8.1, C9.1, D6.1 (K), F2.2; also elsewhere on the board
unnamed: D3.2 (A), R6.1
unnamed: D4.2 (A), R7.1
unnamed: D5.2 (A), R10.1
unnamed: F1.1, U3.1
unnamed: F2.1, U9.1
unnamed: R4.1, R5.2, U4.1 (ADJ)
unnamed: R8.1, R9.2, U5.1 (ADJ)
VDD: C4.1, C5.1, D2.1 (K), F1.2, R6.2, U4.3 (IN), U5.3 (IN); also elsewhere on the board

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
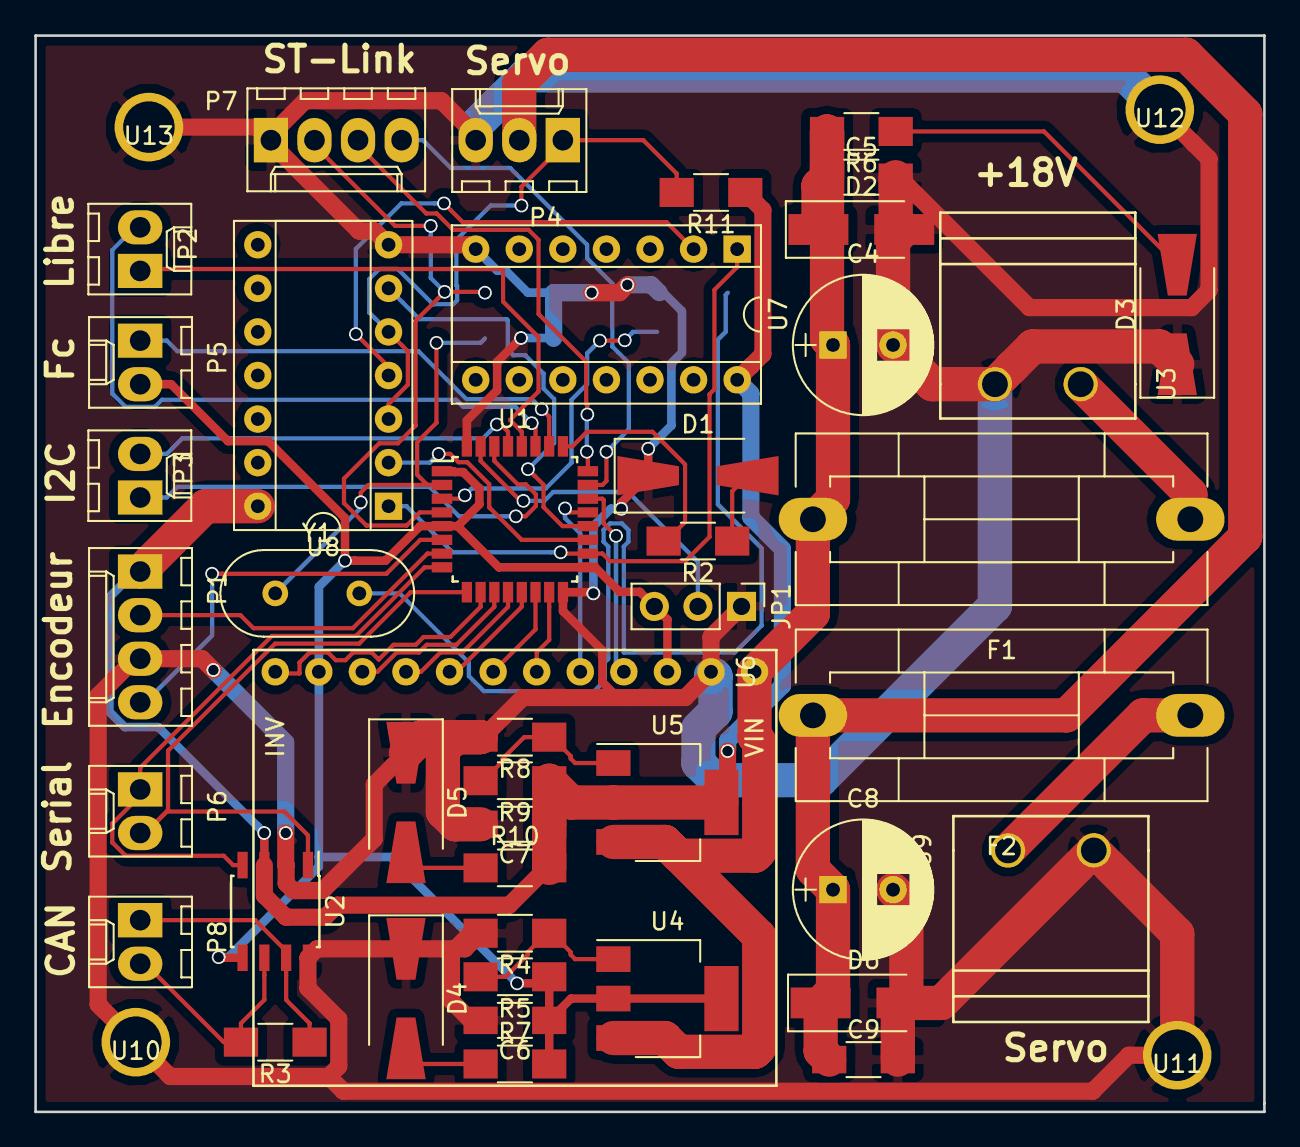
[picture p149: board driver-moteurs.kicad_pcb from above]

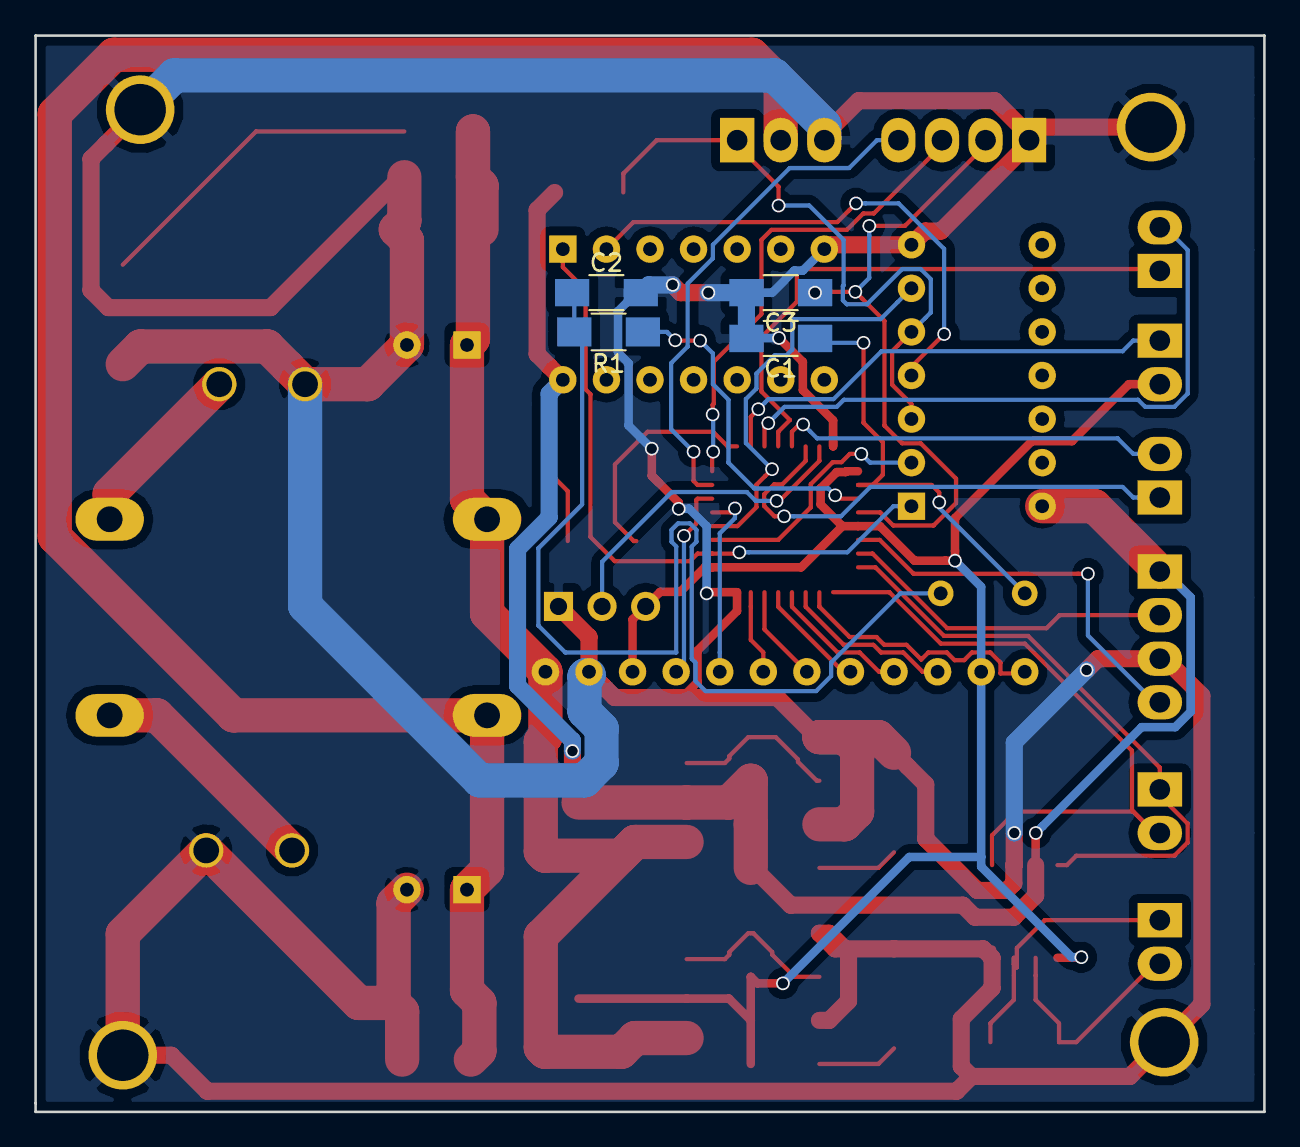
[picture p150: board driver-moteurs.kicad_pcb from below]

Board: 2 copper layers, 71.6 x 62.7 mm, 51 parts (4 on the bottom side), 45 nets.
