robotronik/cdfr2018/Programmation/Axe_Z/Asser_moteur_z/Src/main.c

/**
  ******************************************************************************
  * @file           : main.c
  * @brief          : Main program body
  ******************************************************************************
  ** This notice applies to any and all portions of this file
  * that are not between comment pairs USER CODE BEGIN and
  * USER CODE END. Other portions of this file, whether 
  * inserted by the user or by software development tools
  * are owned by their respective copyright owners.
  *
  * COPYRIGHT(c) 2018 STMicroelectronics
  *
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
  ******************************************************************************
  */
/* Includes ------------------------------------------------------------------*/
#include "main.h"
#include "stm32f3xx_hal.h"
#include "dma.h"
#include "i2c.h"
#include "tim.h"
#include "usart.h"
#include "wwdg.h"
#include "gpio.h"

/* USER CODE BEGIN Includes */
#include "robotronik_protocol.h"
#include "robotronik_protocol_stm32f3.h"
#include "remote_call.h"
#include "ax_12a_hal.h"
#include "Robotronik_corp_pid.h"
#include "encoder.h"

#include "Z_axis.h"
#include "server.h"
#include "fsm_master.h"
#include "fsm_start.h"
/* USER CODE END Includes */


/* USER CODE BEGIN PV */

/* USER CODE END PV */

void SystemClock_Config(void);

/* USER CODE BEGIN PFP */

/* USER CODE END PFP */

/* USER CODE BEGIN 0 */
void HAL_WWDG_EarlyWakeupCallback(WWDG_HandleTypeDef* p_hwwdg){
  if(p_hwwdg == &hwwdg){

  }
}
/* USER CODE END 0 */

/**
  * @brief  The application entry point.
  *
  * @retval None
  */
int main(void)
{
  /* MCU Configuration----------------------------------------------------------*/

  /* Reset of all peripherals, Initializes the Flash interface and the Systick. */
  HAL_Init();

  /* Configure the system clock */
  SystemClock_Config();

  /* Initialize all configured peripherals */
  MX_GPIO_Init();
  MX_DMA_Init();
  MX_I2C1_Init();
  MX_TIM2_Init();
  MX_TIM3_Init();
  MX_USART1_UART_Init();
  MX_USART2_UART_Init();
  MX_TIM15_Init();
  //MX_WWDG_Init();
  /* USER CODE BEGIN 2 */
  Z_Init_AX();
  HAL_Delay(2000);
  Z_Enable_AX(true);
  HAL_Delay(2000);
  AX_Set_Goal_Position(&servo_ar, AX_ARM_START, AX_NOW);
  
  while(1);
  
  //==================================================
  //                    UART
  //==================================================
  //RP_Init_Interface(&Z_interface, USART2, RP_UART_Transmit, HAL_GetTick);
  //RP_INIT_UART_DMA(DMA1, LL_DMA_CHANNEL_6, USART2, Z_interface);

  //==================================================
  //              Remote Call Server
  //==================================================
  //RC_Server_Init(&Z_server,&Z_interface);

  RC_Server_Add_Function(&Z_server, Z_RESET, reset, "", "", RC_IMMEDIATE);
  RC_Server_Add_Function(&Z_server, Z_SET_ASSER, set_asser, "fffif", "", RC_IMMEDIATE);

  RC_Server_Add_Function(&Z_server, Z_GET_STATE, get_state, "", "b", RC_IMMEDIATE);

  RC_Server_Add_Function(&Z_server, Z_BALEC, balec, "", "", RC_IMMEDIATE);
  RC_Server_Add_Function(&Z_server, Z_PUNCH_BEE, punch_bee, "", "", RC_IMMEDIATE);
  RC_Server_Add_Function(&Z_server, Z_ARM_IN, arm_in, "", "", RC_IMMEDIATE);
  RC_Server_Add_Function(&Z_server, Z_ARM_OUT, arm_out, "", "", RC_IMMEDIATE);
  //RC_Server_Add_Function(&Z_server, Z_STACK_FIRST, stack_first, "", "b", RC_IMMEDIATE);
  RC_Server_Add_Function(&Z_server, Z_STACK, stack, "", "", RC_IMMEDIATE);
  RC_Server_Add_Function(&Z_server, Z_STACK_LAST, stack_last, "", "",RC_IMMEDIATE);
  RC_Server_Add_Function(&Z_server, Z_UNSTACK,unstack, "", "", RC_IMMEDIATE);
  RC_Server_Add_Function(&Z_server, Z_PLACE,place, "", "", RC_IMMEDIATE);

  //==================================================
  //                  AX-12A
  //==================================================
  HAL_Delay(500);
  Z_Init_AX();
  HAL_Delay(1000);
  Z_Open();

  //==================================================
  //                  Default PID
  //==================================================
  pid_z.Kp=0.004*0.6;//Ziegler-Nichols
  pid_z.Ki=0.005/2;
  pid_z.Kd=0.00001;
  pid_z.Te=0.01;
  pid_z.position_tolerance=500;
  pid_z.speed_tolerance=1000;
  pid_init(&pid_z);

  //==================================================
  //              Motor & Encoder
  //==================================================
  AX_Set_Goal_Position(&servo_g, AX_LEFT_CLOSE, AX_NOW);
  AX_Set_Goal_Position(&servo_d, AX_RIGHT_CLOSE, AX_NOW);
  MOTOR_INIT;
  MOTOR_FC;
  init_encoder(&encoder, &htim2, &htim15);
  start_encoder(&encoder);

  //==================================================
  //                    FSM
  //==================================================
  FSM_Start fsm_start;
  fsm = (FSM_Instance*volatile) &fsm_start;
  fsm->run = FSM_Start_Init;

  /* USER CODE END 2 */

  /* Infinite loop */
  /* USER CODE BEGIN WHILE */


  //https://www.pololu.com/product/1212

  /*while(1)
  {
    //AX_Set_Goal_Position(&servo_g, AX_LEFT_OPEN, AX_NOW);
    //AX_Set_Goal_Position(&servo_d, AX_RIGHT_OPEN, AX_NOW);
    AX_Set_Goal_Position(&servo_ar, AX_ARM_START, AX_NOW);
    HAL_Delay(1000);
    //AX_Set_Goal_Position(&servo_g, AX_LEFT_CLOSE, AX_NOW);
    //AX_Set_Goal_Position(&servo_d, AX_RIGHT_CLOSE, AX_NOW);
    AX_Set_Goal_Position(&servo_ar, AX_ARM_DEPLOY, AX_NOW);
    HAL_Delay(1000);

    AX_Set_Goal_Position(&servo_ar, AX_ARM_END, AX_NOW);
    HAL_Delay(1000);
  }*/


  imp_goal=0;//warning no negative values
  //fsm_stack.last = 0;
  //fsm->run=FSM_Stack_Init;
  //stack(&Z_server);
  while (1)
  {
    //Watchdog refresh
  //  HAL_WWDG_Refresh(&hwwdg);

    //Asser
    imp_goal=30000;
    float voltage = pid(&pid_z, -imp_goal + encoder.steps);
    if(HAL_GPIO_ReadPin(FC_GPIO_Port,FC_Pin)==1)//fin de course percute=probleme
    {
        voltage=0;
        pid_z.integral = 0;
    }
    MOTOR_VOLTAGE(voltage);

    //FSM
    fsm->run(fsm);

    //Delay
    HAL_Delay(Z_DELAY);
  /* USER CODE END WHILE */

  /* USER CODE BEGIN 3 */
  }
  /* USER CODE END 3 */

}

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
