robotronik/cdfr2018/Programmation/Central/Central/Central.ioc

Mcu.UserName=STM32F401RETx
PA10.GPIO_Label=RASPBERRY_RX [USART1_RX]
PA10.Signal=USART1_RX
PA11.GPIO_Label=PINCE_TX [USART6_TX]
PA11.Signal=USART6_TX
PA12.GPIO_Label=PINCE_RX [USART6_RX]
PA12.Signal=USART6_RX
PA13.GPIO_Label=TMS
PA13.Signal=SYS_JTMS-SWDIO
PA14.GPIO_Label=TCK
PA14.Signal=SYS_JTCK-SWCLK
PA2.GPIO_Label=POSITION_TX [USART2_TX]
PA2.Signal=USART2_TX
PA3.GPIO_Label=POSITION_RX [USART2_RX]
PA3.Signal=USART2_RX
PA5.GPIO_Label=LD2 [Green Led]
PA5.Signal=GPIO_Output
PA6.GPIO_Label=LED_GREEN
PA6.Signal=GPIO_Output
PA7.GPIO_Label=LED_RED
PA7.Signal=GPIO_Output
PA8.GPIO_Label=I2C_TOF_SCL [I2C3_SCL]
PA8.Signal=I2C3_SCL
PA9.GPIO_Label=RASPBERRY_TX [USART1_TX]
PA9.Signal=USART1_TX
PB10.GPIO_Label=I2C_TOF_EN
PB10.Signal=GPIO_Output
PB3.GPIO_Label=SWO
PB3.Signal=SYS_JTDO-SWO
PB4.GPIO_Label=I2C_TOF_SDA [I2C3_SDA]
PB4.Signal=I2C3_SDA
PB6.Signal=I2C1_SCL
PB7.Signal=I2C1_SDA
PC11.GPIO_Label=TOF_RL_RESET
PC11.Signal=GPIO_Output
PC13-ANTI_TAMP.GPIO_Label=B1 [Blue PushButton]
PC13-ANTI_TAMP.Signal=GPXTI13
PC14-OSC32_IN.Signal=RCC_OSC32_IN
PC15-OSC32_OUT.Signal=RCC_OSC32_OUT
PC3.GPIO_Label=TOF_FL_RESET
PC3.Signal=GPIO_Output
PC4.GPIO_Label=TOF_FR_RESET
PC4.Signal=GPIO_Output
PC5.GPIO_Label=JACK_START
PC5.Signal=GPIO_Input
PC6.GPIO_Label=SELEC
PC6.Signal=GPIO_Input
PC9.GPIO_Label=TOF_RR_RESET
PC9.Signal=GPIO_Output
