robotronik/cdfr2018/Programmation/Position/Position/Src/Robotronik_corp_pid.c

#include "Robotronik_corp_pid.h"

void pid_init(volatile PID_DATA *pid)
{
  pid->prev_eps=0;
  pid->integral=0;
}

float pid(volatile PID_DATA *pid, int eps)
{
  float output;
  pid->integral=pid->integral+pid->Te*eps;
  output=eps*pid->Kp+pid->Ki*pid->integral+pid->Kd*(eps-pid->prev_eps)/pid->Te;
  pid->prev_eps=eps;
  return output;
}

int reached(volatile PID_DATA *pid,int eps)
{
  if(abs(eps)<pid->position_tolerance)// && (abs(eps-pid->prev_eps))/pid->Te<pid->speed_tolerance)
    return 1;
  return 0;
}


void pid_speed_init(volatile PID_SPEED_DATA *pid)
{
  pid->prev_eps=0;
  pid->integral=0;
}

float pid_speed(volatile PID_SPEED_DATA *pid, float eps)
{
  float output;
  pid->integral=pid->integral+pid->Te*eps;
  output=eps*pid->Kp+pid->Ki*pid->integral+pid->Kd*(eps-pid->prev_eps)/pid->Te;
  pid->prev_eps=eps;
  return output;
}
