robotronik/cdfr2018/Programmation/Axe_Z/Asser_moteur_z/Inc/Robotronik_corp_pid.h

/*
 * Library for Cdfr2018 @Robotronik
 * You may freely rage with this software
 */

#ifndef Robotronik_corp_pid_H
#define Robotronik_corp_pid_H

#include <stdlib.h>

typedef struct{
  float Kp;
  float Ki;
  float Kd;
  float prev_eps;
  float integral;
  float Te;
  int position_tolerance;
  float speed_tolerance;
} PID_DATA;

void pid_init(volatile PID_DATA *pid);
float pid(volatile PID_DATA *pid, int eps);
int reached(volatile PID_DATA *pid,int eps);

#endif
