robotronik/cdfr2018/Programmation/Axe_Z/Asser_moteur_z/Inc/fsm_arm.h

#ifndef FSM_ARM_H
#define FSM_ARM_H

#include "fsm_master.h"
#include "Z_axis.h"

typedef struct FSM_Arm_S{
  FSM_Instance instance;
}FSM_Arm;

void FSM_ARM_OUT(FSM_Instance *fsm);
void FSM_ARM_IN(FSM_Instance *fsm);
void FSM_ARM_END(FSM_Instance *fsm);

#endif
