robotronik/cdfr2018/Programmation/Central/Central/Src/usart.c

/**
  ******************************************************************************
  * File Name          : USART.c
  * Description        : This file provides code for the configuration
  *                      of the USART instances.
  ******************************************************************************
  ** This notice applies to any and all portions of this file
  * that are not between comment pairs USER CODE BEGIN and
  * USER CODE END. Other portions of this file, whether 
  * inserted by the user or by software development tools
  * are owned by their respective copyright owners.
  *
  * COPYRIGHT(c) 2018 STMicroelectronics
  *
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
  ******************************************************************************
  */

/* Includes ------------------------------------------------------------------*/
#include "usart.h"

#include "gpio.h"
#include "dma.h"

/* USER CODE BEGIN 0 */
#include "system.h"

RP_Interface pi_iface;
RP_Interface pos_iface;
RP_Interface z_iface;

uint8_t RP_UART_Transmit(void *link_handler, uint8_t *data, uint16_t size, uint32_t timeout){
  USART_TypeDef *usart_handler = (USART_TypeDef*) link_handler;
  int i;
  for(i = 0; i < size; i++){
    __disable_irq();
    LL_USART_TransmitData8(usart_handler, data[i]);
    while(LL_USART_IsActiveFlag_TXE(usart_handler) == 0);
    __enable_irq();
  }
  return 0;
}

void RP_Packet_Received(RP_Interface *iface, RP_Packet *packet){
  //Remote stop hack
  if(iface == &pi_iface && packet->len == 1 && packet->data[0] == 0xFF){
    remote_stop();
  }
}
/* USER CODE END 0 */

/* USART1 init function */

void MX_USART1_UART_Init(void)
{
  LL_USART_InitTypeDef USART_InitStruct;

  LL_GPIO_InitTypeDef GPIO_InitStruct;
  /* Peripheral clock enable */
  LL_APB2_GRP1_EnableClock(LL_APB2_GRP1_PERIPH_USART1);
  
  /**USART1 GPIO Configuration  
  PA9   ------> USART1_TX
  PA10   ------> USART1_RX 
  */
  GPIO_InitStruct.Pin = LL_GPIO_PIN_9|LL_GPIO_PIN_10;
  GPIO_InitStruct.Mode = LL_GPIO_MODE_ALTERNATE;
  GPIO_InitStruct.Speed = LL_GPIO_SPEED_FREQ_VERY_HIGH;
  GPIO_InitStruct.OutputType = LL_GPIO_OUTPUT_PUSHPULL;
  GPIO_InitStruct.Pull = LL_GPIO_PULL_UP;
  GPIO_InitStruct.Alternate = LL_GPIO_AF_7;
  LL_GPIO_Init(GPIOA, &GPIO_InitStruct);

  /* USART1 DMA Init */
  
  /* USART1_RX Init */
  LL_DMA_SetChannelSelection(DMA2, LL_DMA_STREAM_2, LL_DMA_CHANNEL_4);

  LL_DMA_SetDataTransferDirection(DMA2, LL_DMA_STREAM_2, LL_DMA_DIRECTION_PERIPH_TO_MEMORY);

  LL_DMA_SetStreamPriorityLevel(DMA2, LL_DMA_STREAM_2, LL_DMA_PRIORITY_LOW);

  LL_DMA_SetMode(DMA2, LL_DMA_STREAM_2, LL_DMA_MODE_CIRCULAR);

  LL_DMA_SetPeriphIncMode(DMA2, LL_DMA_STREAM_2, LL_DMA_PERIPH_NOINCREMENT);

  LL_DMA_SetMemoryIncMode(DMA2, LL_DMA_STREAM_2, LL_DMA_MEMORY_INCREMENT);

  LL_DMA_SetPeriphSize(DMA2, LL_DMA_STREAM_2, LL_DMA_PDATAALIGN_BYTE);

  LL_DMA_SetMemorySize(DMA2, LL_DMA_STREAM_2, LL_DMA_MDATAALIGN_BYTE);

  LL_DMA_DisableFifoMode(DMA2, LL_DMA_STREAM_2);

  /* USART1 interrupt Init */
  NVIC_SetPriority(USART1_IRQn, NVIC_EncodePriority(NVIC_GetPriorityGrouping(),0, 0));
  NVIC_EnableIRQ(USART1_IRQn);

  USART_InitStruct.BaudRate = 1000000;
  USART_InitStruct.DataWidth = LL_USART_DATAWIDTH_8B;
  USART_InitStruct.StopBits = LL_USART_STOPBITS_1;
  USART_InitStruct.Parity = LL_USART_PARITY_NONE;
  USART_InitStruct.TransferDirection = LL_USART_DIRECTION_TX_RX;
  USART_InitStruct.HardwareFlowControl = LL_USART_HWCONTROL_NONE;
  USART_InitStruct.OverSampling = LL_USART_OVERSAMPLING_16;
  LL_USART_Init(USART1, &USART_InitStruct);

  LL_USART_ConfigAsyncMode(USART1);

  LL_USART_Enable(USART1);

}
/* USART2 init function */

void MX_USART2_UART_Init(void)
{
  LL_USART_InitTypeDef USART_InitStruct;

  LL_GPIO_InitTypeDef GPIO_InitStruct;
  /* Peripheral clock enable */
  LL_APB1_GRP1_EnableClock(LL_APB1_GRP1_PERIPH_USART2);
  
  /**USART2 GPIO Configuration  
  PA2   ------> USART2_TX
  PA3   ------> USART2_RX 
  */
  GPIO_InitStruct.Pin = LL_GPIO_PIN_2|LL_GPIO_PIN_3;
  GPIO_InitStruct.Mode = LL_GPIO_MODE_ALTERNATE;
  GPIO_InitStruct.Speed = LL_GPIO_SPEED_FREQ_VERY_HIGH;
  GPIO_InitStruct.OutputType = LL_GPIO_OUTPUT_PUSHPULL;
  GPIO_InitStruct.Pull = LL_GPIO_PULL_UP;
  GPIO_InitStruct.Alternate = LL_GPIO_AF_7;
  LL_GPIO_Init(GPIOA, &GPIO_InitStruct);

  /* USART2 DMA Init */
  
  /* USART2_RX Init */
  LL_DMA_SetChannelSelection(DMA1, LL_DMA_STREAM_5, LL_DMA_CHANNEL_4);

  LL_DMA_SetDataTransferDirection(DMA1, LL_DMA_STREAM_5, LL_DMA_DIRECTION_PERIPH_TO_MEMORY);

  LL_DMA_SetStreamPriorityLevel(DMA1, LL_DMA_STREAM_5, LL_DMA_PRIORITY_LOW);

  LL_DMA_SetMode(DMA1, LL_DMA_STREAM_5, LL_DMA_MODE_CIRCULAR);

  LL_DMA_SetPeriphIncMode(DMA1, LL_DMA_STREAM_5, LL_DMA_PERIPH_NOINCREMENT);

  LL_DMA_SetMemoryIncMode(DMA1, LL_DMA_STREAM_5, LL_DMA_MEMORY_INCREMENT);

  LL_DMA_SetPeriphSize(DMA1, LL_DMA_STREAM_5, LL_DMA_PDATAALIGN_BYTE);

  LL_DMA_SetMemorySize(DMA1, LL_DMA_STREAM_5, LL_DMA_MDATAALIGN_BYTE);

  LL_DMA_DisableFifoMode(DMA1, LL_DMA_STREAM_5);

  /* USART2 interrupt Init */
  NVIC_SetPriority(USART2_IRQn, NVIC_EncodePriority(NVIC_GetPriorityGrouping(),0, 0));
  NVIC_EnableIRQ(USART2_IRQn);

  USART_InitStruct.BaudRate = 115200;
  USART_InitStruct.DataWidth = LL_USART_DATAWIDTH_8B;
  USART_InitStruct.StopBits = LL_USART_STOPBITS_1;
  USART_InitStruct.Parity = LL_USART_PARITY_NONE;
  USART_InitStruct.TransferDirection = LL_USART_DIRECTION_TX_RX;
  USART_InitStruct.HardwareFlowControl = LL_USART_HWCONTROL_NONE;
  USART_InitStruct.OverSampling = LL_USART_OVERSAMPLING_16;
  LL_USART_Init(USART2, &USART_InitStruct);

  LL_USART_ConfigAsyncMode(USART2);

  LL_USART_Enable(USART2);

}
/* USART6 init function */

void MX_USART6_UART_Init(void)
{
  LL_USART_InitTypeDef USART_InitStruct;

  LL_GPIO_InitTypeDef GPIO_InitStruct;
  /* Peripheral clock enable */
  LL_APB2_GRP1_EnableClock(LL_APB2_GRP1_PERIPH_USART6);
  
  /**USART6 GPIO Configuration  
  PA11   ------> USART6_TX
  PA12   ------> USART6_RX 
  */
  GPIO_InitStruct.Pin = LL_GPIO_PIN_11|LL_GPIO_PIN_12;
  GPIO_InitStruct.Mode = LL_GPIO_MODE_ALTERNATE;
  GPIO_InitStruct.Speed = LL_GPIO_SPEED_FREQ_VERY_HIGH;
  GPIO_InitStruct.OutputType = LL_GPIO_OUTPUT_PUSHPULL;
  GPIO_InitStruct.Pull = LL_GPIO_PULL_UP;
  GPIO_InitStruct.Alternate = LL_GPIO_AF_8;
  LL_GPIO_Init(GPIOA, &GPIO_InitStruct);

  /* USART6 DMA Init */
  
  /* USART6_RX Init */
  LL_DMA_SetChannelSelection(DMA2, LL_DMA_STREAM_1, LL_DMA_CHANNEL_5);

  LL_DMA_SetDataTransferDirection(DMA2, LL_DMA_STREAM_1, LL_DMA_DIRECTION_PERIPH_TO_MEMORY);

  LL_DMA_SetStreamPriorityLevel(DMA2, LL_DMA_STREAM_1, LL_DMA_PRIORITY_LOW);

  LL_DMA_SetMode(DMA2, LL_DMA_STREAM_1, LL_DMA_MODE_CIRCULAR);

  LL_DMA_SetPeriphIncMode(DMA2, LL_DMA_STREAM_1, LL_DMA_PERIPH_NOINCREMENT);

  LL_DMA_SetMemoryIncMode(DMA2, LL_DMA_STREAM_1, LL_DMA_MEMORY_INCREMENT);

  LL_DMA_SetPeriphSize(DMA2, LL_DMA_STREAM_1, LL_DMA_PDATAALIGN_BYTE);

  LL_DMA_SetMemorySize(DMA2, LL_DMA_STREAM_1, LL_DMA_MDATAALIGN_BYTE);

  LL_DMA_DisableFifoMode(DMA2, LL_DMA_STREAM_1);

  /* USART6 interrupt Init */
  NVIC_SetPriority(USART6_IRQn, NVIC_EncodePriority(NVIC_GetPriorityGrouping(),0, 0));
  NVIC_EnableIRQ(USART6_IRQn);

  USART_InitStruct.BaudRate = 9600;
  USART_InitStruct.DataWidth = LL_USART_DATAWIDTH_8B;
  USART_InitStruct.StopBits = LL_USART_STOPBITS_1;
  USART_InitStruct.Parity = LL_USART_PARITY_NONE;
  USART_InitStruct.TransferDirection = LL_USART_DIRECTION_TX_RX;
  USART_InitStruct.HardwareFlowControl = LL_USART_HWCONTROL_NONE;
  USART_InitStruct.OverSampling = LL_USART_OVERSAMPLING_16;
  LL_USART_Init(USART6, &USART_InitStruct);

  LL_USART_ConfigAsyncMode(USART6);

  LL_USART_Enable(USART6);

}

/**
  * @}
  */

/**
  * @}
  */

/************************ (C) COPYRIGHT STMicroelectronics *****END OF FILE****/
