robotronik/cdfr2018/Programmation/Position/Position/Src/odometry.c

#include "odometry.h"

volatile float ENCODER_DIST=199.66;//distance between encoders
volatile float ENCODER_STEP_DIST=20.65*2*M_PI/1440.0;//distance for 1 encoder step
volatile float deltaL=(20.65*2*M_PI/1440.0)/199.66;//ENCODER_STEP_DIST/ENCODER_DIST

void update_odometry(Odometry *odometry){
  int dl_l = update_encoder(&odometry->encoder_l);
  int dl_r = update_encoder(&odometry->encoder_r);

#if TEST_ENCODER==1
  led_level = (int) (((float) odometry->encoder_l.htim->Instance->CNT / ENCODER_MAX)*255);
#endif

#if TEST_ENCODER==2
  led_level = (int) (((float) odometry->encoder_r.htim->Instance->CNT / ENCODER_MAX)*255);
#endif


  odometry->x = odometry->x
    + cos(odometry->theta)*ENCODER_STEP_DIST*(dl_l + dl_r);

  odometry->y = odometry->y
    + sin(odometry->theta)*ENCODER_STEP_DIST*(dl_l + dl_r);

  odometry->theta = odometry->theta+deltaL*(dl_l - dl_r);

  if(odometry->theta>PI)//angle limitation to -PI +PI
  {
    odometry->theta=odometry->theta-2*PI;
  }
  else if(odometry->theta<=-PI)
  {
    odometry->theta=odometry->theta+2*PI;
  }
}

void init_odometry(Odometry *odometry, TIM_HandleTypeDef *htim_l, TIM_HandleTypeDef *htim_r, TIM_HandleTypeDef *htim_poll){
  odometry->x = odometry->y = 0;
  odometry->theta = 0;

  init_encoder(&odometry->encoder_l, htim_l);
  init_encoder(&odometry->encoder_r, htim_r);

  start_encoder(&odometry->encoder_l);
  start_encoder(&odometry->encoder_r);

  HAL_TIM_Base_Start_IT(htim_poll);
}
