robotronik/cdfr2018/Programmation/Central/Central/Src/position_client.c

#include "position_client.h"
#include "strategy.h"
#include "remote_call.h"
#include "usart.h"
static RC_Client pos_client;

int Position_Init(){
  RC_Client_Init(&pos_client, &pos_iface, 0);
  
  if(RC_Client_Add_Function(&pos_client, POS_RESET, "", "")) return -1;
  if(RC_Client_Add_Function(&pos_client, POS_SET_ASSER_SUM, "fffif", "")) return -1;
  if(RC_Client_Add_Function(&pos_client, POS_SET_ASSER_DIFF, "fffif", "")) return -1;
  if(RC_Client_Add_Function(&pos_client, POS_SET_ODO, "BBf", "")) return -1;
  if(RC_Client_Add_Function(&pos_client, POS_GET_ODO, "", "BBf")) return -1;
  if(RC_Client_Add_Function(&pos_client, POS_GO_FORWARD, "ff", "")) return -1;//!
  if(RC_Client_Add_Function(&pos_client, POS_SET_ANGLE, "ff", "")) return -1;
  if(RC_Client_Add_Function(&pos_client, POS_SET_POSITION_X_Y, "ffBB", "")) return -1;
  if(RC_Client_Add_Function(&pos_client, POS_GET_STATE, "", "b")) return -1;
  if(RC_Client_Add_Function(&pos_client, POS_BALEC, "", "")) return -1;
  if(RC_Client_Add_Function(&pos_client, POS_BRAKE, "", "")) return -1;
  if(RC_Client_Add_Function(&pos_client, POS_INIT_PATH, "", "")) return -1;
  if(RC_Client_Add_Function(&pos_client, POS_ADD_POINT, "BB", "")) return -1;
  if(RC_Client_Add_Function(&pos_client, POS_FOLLOW_PATH, "", "")) return -1;
  if(RC_Client_Add_Function(&pos_client, POS_CONFIG_CURVE, "ffffffff", "")) return -1;
  if(RC_Client_Add_Function(&pos_client, POS_ENABLE, "", "")) return -1;
  if(RC_Client_Add_Function(&pos_client, POS_DISABLE, "", "")) return -1;
  return 0;
}

int Pos_Set_Odo(uint16_t x, uint16_t y, float angle){
  HAL_NVIC_DisableIRQ(TIM3_IRQn);
  int r = RC_Call(&pos_client, POS_SET_ODO, x, y, angle);
  HAL_NVIC_EnableIRQ(TIM3_IRQn);
  return r;
}

int Position_Init_Odometry(){
  return Pos_Set_Odo(me.x, me.y, me.angle);
}

int Pos_Enable(){
  HAL_NVIC_DisableIRQ(TIM3_IRQn);
  int r = RC_Call(&pos_client, POS_ENABLE);
  HAL_NVIC_EnableIRQ(TIM3_IRQn);
  return r;
}

int Pos_Disable(){
  HAL_NVIC_DisableIRQ(TIM3_IRQn);
  int r = RC_Call(&pos_client, POS_DISABLE);
  HAL_NVIC_EnableIRQ(TIM3_IRQn);
  return r;
}
  
int Pos_Reset(){
  HAL_NVIC_DisableIRQ(TIM3_IRQn);
  int r = RC_Call(&pos_client, POS_RESET);
  HAL_NVIC_EnableIRQ(TIM3_IRQn);
  return r;
}

int Pos_Get_State(Position_State *state){
  HAL_NVIC_DisableIRQ(TIM3_IRQn);
  int r = RC_Call(&pos_client, POS_GET_STATE, state);
  HAL_NVIC_EnableIRQ(TIM3_IRQn);
  return r;
}

int Pos_Config_Curve(float z, float w, float vc, float vr, float P, float I, float D, float speed_percent_tolerance){
  HAL_NVIC_DisableIRQ(TIM3_IRQn);
  int r = RC_Call(&pos_client, POS_CONFIG_CURVE, z, w, vc, vr, P, I, D, speed_percent_tolerance);//z w vc vr P I D speed_percent_tolerance
  HAL_NVIC_EnableIRQ(TIM3_IRQn);
  return r;
}

int Pos_Init_Path(){
  HAL_NVIC_DisableIRQ(TIM3_IRQn);
  int r = RC_Call(&pos_client, POS_INIT_PATH);
  HAL_NVIC_EnableIRQ(TIM3_IRQn);
  return r;
}

int Pos_Add_Point(uint16_t x_goal, uint16_t y_goal){
  HAL_NVIC_DisableIRQ(TIM3_IRQn);
  int r = RC_Call(&pos_client, POS_ADD_POINT, x_goal, y_goal);
  HAL_NVIC_EnableIRQ(TIM3_IRQn);
  return r;
}

int Pos_Follow_Path(){
  HAL_NVIC_DisableIRQ(TIM3_IRQn);
  int r = RC_Call(&pos_client, POS_FOLLOW_PATH);
  HAL_NVIC_EnableIRQ(TIM3_IRQn);
  return r;
}

int Pos_Send_Path(Cell *path_end, uint16_t x_goal, uint16_t y_goal){
  if(path_end == NULL){
    return -1;
  }
  
  if(Pos_Init_Path() != 0){
    return -1;
  }

  //Last point
  if(Pos_Add_Point(x_goal, y_goal) != 0){
    return -1;
  }

  Cell *current_cell;
  while((current_cell = path_end->pred) != NULL){
    if(Pos_Add_Point(current_cell->x, current_cell->y) != 0){
      return -1;
    }
  }
  
  if(Pos_Follow_Path() != 0){
    return -1;
  }

  return 0;
}

int Pos_Init_Position(uint16_t x0, uint16_t y0){
  HAL_NVIC_DisableIRQ(TIM3_IRQn);
  int r = RC_Call(&pos_client, POS_SET_ODO, x0, y0);
  HAL_NVIC_EnableIRQ(TIM3_IRQn);
  return r;
}

int Pos_Get_Position(){
  HAL_NVIC_DisableIRQ(TIM3_IRQn);
  int r = RC_Call(&pos_client, POS_GET_ODO, &me.x, &me.y, &me.angle);
  HAL_NVIC_EnableIRQ(TIM3_IRQn);
  return r;
}

int Pos_Go_Forward(float speed, float distance){
  HAL_NVIC_DisableIRQ(TIM3_IRQn);
  int r = RC_Call(&pos_client, POS_GO_FORWARD, speed, distance);
  HAL_NVIC_EnableIRQ(TIM3_IRQn);
  return r;
}

int Pos_Set_Angle(float speed, float angle){
  HAL_NVIC_DisableIRQ(TIM3_IRQn);
  int r = RC_Call(&pos_client, POS_SET_ANGLE, speed, angle);
  HAL_NVIC_EnableIRQ(TIM3_IRQn);
  return r;
}

int Pos_Brake(){
  HAL_NVIC_DisableIRQ(TIM3_IRQn);
  int r = RC_Call(&pos_client, POS_BRAKE);
  HAL_NVIC_EnableIRQ(TIM3_IRQn);
  return r;
}
