robotronik/cdfr2018/Programmation/Central/Central/Src/tof.c

/*
 * The code below is inspired by the STMicroelectronics X-CUBE-53L0A1 example source code. Here is the license disclaimer :
 * 
 * COPYRIGHT(c) 2015 STMicroelectronics
 *
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
 ******************************************************************************
 */
#include "tof.h"
#include "pi_client.h"

void ToF_Init_Struct(ToF_Handler *htof, I2C_HandleTypeDef *hi2c){
  htof->dev.I2cHandle = hi2c;
  htof->dev.I2cDevAddr = 0x52;
  htof->dev.Present = 0;

  //Set I2C speed to 400KHz
  VL53L0X_WrByte(&htof->dev, 0x88, 0x00);
}

int ToF_Poke(ToF_Dev *dev){
  int status;
  //Read ID to know if the address is correct
  uint16_t id = 0;
  status = VL53L0X_RdWord(dev, VL53L0X_REG_IDENTIFICATION_MODEL_ID, &id);
  
  //I2C error or bad ID
  if(status || id != 0xEEAA){
    return -1;
  }
  
  return 0;
}

int ToF_Set_Address(ToF_Dev *dev, uint8_t addr){
  //Set device address
  int status = VL53L0X_SetDeviceAddress(dev, addr);
  if(status) return -1;
  dev->I2cDevAddr = addr;

  //Check if the device work with the new address
  return ToF_Poke(dev);
}

int ToF_Init_Device(ToF_Dev *dev){
  //Init the device
  int status = VL53L0X_DataInit(dev);
  if(status == 0)
    dev->Present = 1;
  else
    return -1;
  
  //Static init
  status = VL53L0X_StaticInit(dev);
  if(status) return -1;
  return 0;
}

int ToF_Configure_Device(ToF_Dev *dev, ToF_Params *params, VL53L0X_DeviceModes mode){
  int status = 0;

  do{
    //Ref Spad Management
    status = VL53L0X_PerformRefSpadManagement(dev, &params->refSpadCount, &params->isApertureSpads);
    if(status) break;

    //Ref calibration
    status = VL53L0X_PerformRefCalibration(dev, &params->VhvSettings, &params->PhaseCal);
    if(status) break;
   
    //Set single ranging mode
    status = VL53L0X_SetDeviceMode(dev, mode);
    if(status) break;
  
    //Enable Sigma Limit
    status = VL53L0X_SetLimitCheckEnable(dev, VL53L0X_CHECKENABLE_SIGMA_FINAL_RANGE, 1);
    if(status) break;
  
    //Enable Signal Limit
    status = VL53L0X_SetLimitCheckEnable(dev, VL53L0X_CHECKENABLE_SIGNAL_RATE_FINAL_RANGE, 1);
    if(status) break;
  
    status = VL53L0X_SetLimitCheckValue(dev, VL53L0X_CHECKENABLE_SIGNAL_RATE_FINAL_RANGE, params->signalLimit);
    if(status) break;
  
    status = VL53L0X_SetLimitCheckValue(dev, VL53L0X_CHECKENABLE_SIGMA_FINAL_RANGE, params->sigmaLimit);
    if(status) break;
  
    status = VL53L0X_SetMeasurementTimingBudgetMicroSeconds(dev, params->timingBudget);
    if(status) break;
  
    status = VL53L0X_SetVcselPulsePeriod(dev, VL53L0X_VCSEL_PERIOD_PRE_RANGE, params->preRangeVcselPeriod);
    if(status) break;

    status = VL53L0X_SetVcselPulsePeriod(dev, VL53L0X_VCSEL_PERIOD_FINAL_RANGE, params->finalRangeVcselPeriod);
    if(status) break;
  
    status = VL53L0X_PerformRefCalibration(dev, &params->VhvSettings, &params->PhaseCal);
    if(status) break;
  
    dev->LeakyFirst = 1;

    return 0;
  }while(0);
  
  return -1;
}

static void ToF_SetNewRange(ToF_Dev *dev, ToF_Data *data){
  /* Store new ranging data into the device structure, apply leaky
     integrator if needed */
  static int LeakyFactorFix8 = (int)( 0.6 *256);
    
  if(data->RangeStatus == 0){
    if(dev->LeakyFirst){
      dev->LeakyFirst = 0;
      dev->LeakyRange = data->RangeMilliMeter;
    }
    else{
      dev->LeakyRange = (dev->LeakyRange*LeakyFactorFix8 + (256-LeakyFactorFix8)*data->RangeMilliMeter)>>8;
    }
  }
  else{
    dev->LeakyFirst = 1;
  }
}

int ToF_Poll_Measurement_Data(ToF_Handler *htof){
  if(!htof->dev.Present) return -1;
  
  uint8_t ready;
  if(VL53L0X_GetMeasurementDataReady(&htof->dev, &ready) != VL53L0X_ERROR_NONE){
    return -1;
  }

  if(!ready){
    return 1;
  }

  if(VL53L0X_GetRangingMeasurementData(&htof->dev, &htof->data) != VL53L0X_ERROR_NONE){
    return -1;
  }

  ToF_SetNewRange(&htof->dev, &htof->data);
  
  VL53L0X_ClearInterruptMask(&htof->dev, -1);
  
  return 0;
}

int ToF_Perform_Measurement(ToF_Dev *dev, ToF_Data *data){
  if(!dev->Present) return -1;

  if(VL53L0X_PerformSingleRangingMeasurement(dev, data) != VL53L0X_ERROR_NONE){
    return -1;
  }

  ToF_SetNewRange(dev, data);
  
  return 0;
}

int ToF_Get_Last_Range(ToF_Handler *htof){
  __disable_irq();
  int r = (htof->data.RangeStatus==0)?(htof->dev.LeakyRange):0;
  __enable_irq();
  return r;
}
