robotronik/cdfr2018/Programmation/Axe_Z/Asser_moteur_z/Inc/fsm_place.h

#ifndef FSM_PLACE_H
#define FSM_PLACE_H

#include "fsm_master.h"
#include "Z_axis.h"

typedef struct FSM_Place_S{
  FSM_Instance instance;
}FSM_Place;

void FSM_Place_Init(FSM_Instance *fsm);
void FSM_Place_Open(FSM_Instance *fsm);
void FSM_Place_End(FSM_Instance *fsm);

#endif
