robotronik/cdfr2018/Programmation/Axe_Z/Asser_moteur_z/Inc/ax_12a_hal.h

#ifndef __AX_12A_HAL_H_
#define __AX_12A_HAL_H_

#include <stdint.h>

#include "ax_12a.h"

uint8_t AX_Receive_HAL(uint8_t *buffer, uint16_t size, uint32_t timeout);
uint8_t AX_Send_HAL(uint8_t *data, uint16_t size, uint32_t timeout);
void AX_Set_Direction_HAL(AX_Direction dir);

#endif
