robotronik/cdfr2018/(commit log)

2017-10-06 new makefile
    [gdb-pipe.cfg, st_nucleo_f3.cfg, st_nucleo_f4.cfg]
2017-10-14 debut base
    [base.fcstd, base_roulante.fcstd, bille.fcstd, roue bleue.fcstd]
2017-10-29 encodeurs finis
    [assemblage_bille.fcstd, assemblage_moteur.fcstd, barre_bille.fcstd, barre_encodeur.fcstd, base.fcstd, base_roulante.fcstd, encodeur_236.fcstd, odometre.fcstd]
2017-10-30 schéma driver moteurs cc
    [_saved_driver-moteurs.sch, _saved_power_part.sch, _saved_uC.sch, driver-moteurs.kicad_pcb, driver-moteurs.sch, motor_part.sch, power_part.sch]
2017-10-30 modif billes, debut profilés
    [Profile_AR.fcstd, assemblage_bille.fcstd, base.fcstd, base_roulante.fcstd, espaceur_bille.fcstd, profile_ar.fcstd, support_bas_ar_p.fcstd, support_bille.fcstd]
2017-10-30 Générateur de sprites : GUI
2017-10-31 ajout ax12
    [AX-12A.STEP, ax12.fcstd, comp_ax12.fcstd]
2017-10-31 ajout support servo_pince
    [adaptateur_servo_pince.fcstd, assemblage_pince.fcstd, douille_to_plexi.fcstd, support_servo.fcstd]
2017-10-31 modif profiles, support batterie
    [base.fcstd, base_roulante.fcstd, profile_ar.fcstd, profile_ar_1.fcstd, profile_ar_2.fcstd, support_bas_ar_p_1.fcstd, support_bas_ar_p_2.fcstd, support_batterie.fcstd]
2017-10-31 correction adaptateur douille
    [assemblage_pince.fcstd, douille_to_plexi.fcstd, support_servo.fcstd]
2017-10-31 ajout assemblage base + pince
    [Base_et_pince.fcstd, assemblage_pince.fcstd, base.fcstd, base_roulante.fcstd, calle-tige.fcstd, support_servo.fcstd]
2017-11-01 ajout tige_pince
    [tige_pince.fcstd]
2017-11-01 debut 1er
    [1er_etage.fcstd, Profile_AV.fcstd, base.fcstd, base_et_1er.fcstd, base_roulante.fcstd, profile_av.fcstd, support_bas_av_p.fcstd]
2017-11-01 debut 1er fini
    [1er_etage.fcstd, Profile_AR.fcstd, Profile_AV.fcstd, base_et_1er.fcstd, base_roulante.fcstd, bouclier_batterie.fcstd, profile_ar_1.fcstd, profile_ar_2.fcstd]
2017-11-01 ajout proto pince
    [Base_et_pince.fcstd]
2017-11-02 correction taille pince
    [Base_et_pince.fcstd, assemblage_pince.fcstd, pince_g.fcstd]
2017-11-02 Correction de bugs + update graphique
2017-11-02 ajout roulement pince
    [Base_et_pince.fcstd, adaptateur_servo_pince.fcstd, assemblage_pince.fcstd, axe_pince.fcstd, cale_roulement.fcstd, pince_g.fcstd, roulement.fcstd, top_plexi_pince.fcstd]
2017-11-06 tentative moteur
    [assemblage_global.fcstd, assemblage_moteur.fcstd, axe_poulies.fcstd, couplage_roue-2.fcstd, couplage_roue.fcstd, etage_moteur.fcstd, moteur.fcstd, support_moteur_encodeur.fcstd]
2017-11-07 moteur placé sans encodeur
    [Materiel_HPC.ods, assemblage_global.fcstd, assemblage_moteur.fcstd, assemblage_support_coussinet-2.fcstd, assemblage_support_coussinet.fcstd, bride_moteur.fcstd, couplage_roue-2.fcstd, couplage_roue.fcstd]
2017-11-07 up XL
    [gdb-pipe.cfg, st_nucleo_f3.cfg, st_nucleo_f4.cfg]
2017-11-08 encodeur ok
    [Meca_RS.ods, assemblage_global.fcstd, assemblage_moteur.fcstd, etage_moteur.fcstd, pignon.fcstd, support_encodeur.fcstd, support_moteur_encodeur.fcstd]
2017-11-11 Correction de bugs
2017-11-11 modif support moteur
    [assemblage_moteur.fcstd, support_moteur_encodeur.fcstd]
2017-11-12 Tous les etages en place, mais sans plexi de protection et details
    [Profile_AR.fcstd, Profile_AV.fcstd, assemblage_etage_elec.fcstd, assemblage_global.fcstd, assemblage_moteur.fcstd, assemblage_toit.fcstd, base_roulante.fcstd, etage_elec.fcstd]
2017-11-13 ajout de lapince au montage global
    [assemblage_global.fcstd, assemblage_pince.fcstd, pince_g.fcstd]
2017-11-14 Ajout : gestion des erreurs
2017-11-14 modif etage elec
    [assemblage_etage_elec.fcstd, assemblage_global.fcstd, equerre_etage_elec.fcstd, etage_elec.fcstd]
2017-11-14 tiges cales en haut et support plexi externes
    [1er_etage.fcstd, Profile_AR.fcstd, Profile_AV.fcstd, assemblage_etage_elec.fcstd, assemblage_global.fcstd, assemblage_toit.fcstd, base_roulante.fcstd, etage_elec.fcstd]
2017-11-15 MaJ pince
    [assemblage_global.fcstd, assemblage_pince.fcstd, equerre_bas.fcstd, equerre_pince.fcstd, equerre_top_pince.fcstd, plexi_pince.fcstd]
2017-11-15 MaJ pince 2
    [assemblage_global.fcstd]
2017-11-16 début routage brushless
    [_saved_driver-moteurs.sch, _saved_motor_part.sch, _saved_power_part.sch, _saved_uC.sch, carte_moteurs.kicad_pcb, driver-moteurs.sch, power_part.sch]
2017-11-17 reorganisation elec
    [_saved_motor_part.sch, carte_moteurs.kicad_pcb, carte_moteurs.sch, driver-moteurs.kicad_pcb, driver-moteurs.sch, encodeurs.sch, motor_part.sch, power_part.sch]
2017-11-24 plans dxf
    [base.dxf, etage_moteur.dxf, support_moteur.dxf, support_poulie.dxf, support_poulie_moteur.dxf]
2017-11-28 alu format step
    [assemblage_global.fcstd, base.dxf, base.fcstd, base.step, etage_moteur.dxf, etage_moteur.fcstd, etage_moteur.step, support_moteur.dxf]
2017-11-28 commande de nettoyage des fichiers .fcstd1
2017-12-03 debut routage brushless
    [carte_moteurs.kicad_pcb]
2017-12-03 placement brushless
    [carte_moteurs.kicad_pcb]
2017-12-06 tolerances imprimante
    [support_encodeur.fcstd]
2017-12-07 assemblage pince
    [ass_pince_bas.fcstd, ass_pince_haut.fcstd, assemblage_global.fcstd, assemblage_pince.fcstd, douille_to_plexi.fcstd, equerre_top_pince.fcstd, support_servo.fcstd, top_plexi_pince.fcstd]
2017-12-15 rectification des empreintes
    [carte_moteurs.kicad_pcb, carte_moteurs.sch, encodeurs.sch, motor_part.sch, power_part.sch, uC.sch]
2017-12-15 debut routage
    [carte_moteurs.sch, encodeurs.sch, motor_part.sch, power_part.sch, uC.sch]
2017-12-15 trous et dim ok
    [1er_etage.fcstd, carte_moteurs.kicad_pcb, encodeurs.sch, power_part.sch]
2017-12-15 trous et dim o
    [carte_moteurs.kicad_pcb, power_part.sch]
2017-12-16 trous et dim
    [carte_moteurs.kicad_pcb]
2017-12-16 pas de place pour le quartz
    [carte_moteurs.kicad_pcb, power_part.sch, uC.sch]
2017-12-21 Début lib AX
    [gdb-pipe.cfg, st_nucleo_f3.cfg, st_nucleo_f4.cfg]
2017-12-23 modif moteur axe z
    [driver-moteurs.sch, power_part.sch, uC.sch]
2017-12-24 La lib de noël
2017-12-25 Ajout test
    [gdb-pipe.cfg, st_nucleo_f3.cfg, st_nucleo_f4.cfg]
2017-12-26 axe z routage en cours
    [driver-moteurs.kicad_pcb, driver-moteurs.sch, power_part.sch]
2017-12-27 Essai socket TCP
2017-12-27 Schéma upload ESP01
    [ESP01_Upload.fzz]
2017-12-28 Routage driver moteurs
    [_saved_driver-moteurs.sch, driver-moteurs.kicad_pcb]
2017-12-28 Correction B.Cu
    [driver-moteurs.kicad_pcb]
2017-12-29 Routage brushless
    [_saved_driver-moteurs.sch, carte_moteurs (copie).kicad_pcb, carte_moteurs.kicad_pcb]
2017-12-30 Modif pince passage courroi
    [ass_pince_bas.fcstd, ass_pince_haut.fcstd, assemblage_global.fcstd, assemblage_pince.fcstd, douille_to_plexi.fcstd, support_servo.fcstd, top_plexi_pince.fcstd]
2018-01-01 Correction PCB driver moteurs
    [driver-moteurs.kicad_pcb, driver-moteurs.sch, power_part.sch]
2018-01-01 Correction schéma driver
    [driver-moteurs.kicad_pcb, driver-moteurs.sch, power_part.sch]
2018-01-02 Textes PCB
    [carte_moteurs.kicad_pcb]
2018-01-02 GND driver moteur
    [driver-moteurs.kicad_pcb]
2018-01-02 +3.3 STM32 brushless
    [carte_moteurs.kicad_pcb]
2018-01-02 Noms connecteurs brushless
    [carte_moteurs.kicad_pcb]
2018-01-02 Label st-link brushless
    [carte_moteurs.kicad_pcb]
2018-01-05 connection 2 pins
    [carte_moteurs.kicad_pcb]
2018-01-12 plexi boitier panneau
    [boitier.fcstd, fond.fcstd, matrice_led.fcstd, plaque_ar.fcstd, plaque_av.fcstd, plaques_laterales.fcstd]
2018-01-12 modif pour la commande
    [carte_moteurs-B.Cu.gbl, carte_moteurs-B.Mask.gbs, carte_moteurs-B.SilkS.gbo, carte_moteurs-Edge.Cuts.gm1, carte_moteurs-F.Cu.gtl, carte_moteurs-F.Mask.gts, carte_moteurs-F.SilkS.gto, carte_moteurs.drl]
2018-01-14 support balise
    [assemblage_toit.fcstd, support_balise.fcstd, toit.fcstd]
2018-01-14 mise en plan plexi
    [1er_etage.fcstd, 3vers6.fcstd, 4vers6.fcstd, assemblage_global_ne_pas_modifier.fcstd, bouclier_batterie.fcstd, etage_elec.fcstd, fond.fcstd, plaque_ar.fcstd]
2018-01-15 svg plexis separes
    [ar_1er_etage.fcstd, ar_elec.fcstd, ar_moteur.fcstd, assemblage_global_ne_pas_modifier.fcstd, lateral_1er_etage.fcstd, lateral_elec.fcstd, lateral_moteur.fcstd]
2018-01-20 code pour test de flashage
    [gdb-pipe.cfg, st_nucleo_f3.cfg, st_nucleo_f4.cfg]
2018-01-21 valeurs de resistance manquantes
    [power_part.sch]
2018-01-22 tolerances impression
    [couplage_roue_modif.fcstd]
2018-01-27 carte communications et autres
    [Power.sch, central.kicad_pcb, central.sch]
2018-01-29 ajout valeurs
    [motor_part.sch, uC.sch]
2018-01-30 blink brushless
    [gdb-pipe.cfg, st_nucleo_f3.cfg, st_nucleo_f4.cfg]
2018-01-31 abandon PID CMSIS
2018-01-31 PID home made
2018-01-31 PWM correction
2018-01-31 motor control
2018-02-04 go routage
    [Audio.sch, LED.sch, Power.sch, central.kicad_pcb, central.sch]
2018-02-04 lecture netliste
    [central.kicad_pcb]
2018-02-05 hacheurs moteurs
    [hacheurs_drivers_moteurs.kicad_pcb, hacheurs_drivers_moteurs.sch]
2018-02-05 hacheurs brushless
    [hacheurs_brushless.kicad_pcb, hacheurs_brushless.sch]
2018-02-05 pdf export
    [hacheurs_brushless.kicad_pcb, hacheurs_drivers_moteurs.kicad_pcb]
2018-02-06 Routage PCB central
    [Audio.sch, LED.sch, Power.sch, central.sch]
2018-02-07 pdf export and corrections
    [central.kicad_pcb]
2018-02-09 Up encoder
2018-02-09 pb graduation pwm
2018-02-09 interruption ok
    [gdb-pipe.cfg, st_nucleo_f3.cfg, st_nucleo_f4.cfg]
2018-02-09 Encoder test
2018-02-09 Fix encoder dir
2018-02-11 encoder pid and odometry
2018-02-12 PCB Central
    [central.kicad_pcb]
2018-02-12 Jacky LED
2018-02-12 pcb modif
    [central.kicad_pcb]
2018-02-12 code servos
2018-02-14 trucs qui trainent
    [assemblage_global_avec_bras.fcstd]
2018-02-14 Config matrice
    [gdb-pipe.cfg, st_nucleo_f303k8.cfg]
2018-02-14 support capteurs
    [TOF.fcstd, camera.fcstd]
2018-02-19 motif pour camera
2018-02-20 Jacky LED rpi3 port
2018-02-22 Makefile : ajout de configure.py
2018-02-25 print result
2018-02-26 all colors and config file
    [config.txt]
2018-02-26 add print
2018-02-27 Test UART
    [config.txt, gdb-pipe.cfg, st_nucleo_f3.cfg, st_nucleo_f4.cfg]
2018-02-27 Réglage encodeurs
    * Ajout d'un test visuel
    * Le compteur a un overflow au bout d'un tour complet
    * Le compteur des deux roues compte dans le sens de marche
2018-02-28 cut for printer
    [abeille_coupe.fcstd, structure_abeille_bas.fcstd, structure_abeille_haut.fcstd]
2018-03-01 Mise à jour de l'API du panneau
    * La variable score est désormais entièrement gérée par l'API
2018-03-01 encoder pb solved
2018-03-03 led blink
    [gdb-pipe.cfg, st_nucleo_f3.cfg, st_nucleo_f4.cfg]
2018-03-04 Protocole UART
    * Ajout de RP_Process_Data
    * Modification de FSM_GET_BYTE : l'overflow n'est plus pris en charge,
    mais doit être géré à travers RP_Process_Data
2018-03-04 i2c converter reference
    [central.sch]
2018-03-04 Mise à jour RPV1
    * Les fonctions de rappel:
    - RP_Packet_Received
    - RP_Error_Handler
    Prennent maintenant l'interface en paramètres.
    * Ces mêmes fonctions sont désormais définies par défaut et sont donc désormais optionnelles.
2018-03-07 Position : motor.h
2018-03-07 TIM15 Handler : main.c -> stm32f3xx_it.c
2018-03-08 Position : encoder test
2018-03-08 Protocol : stm32 macro
2018-03-08 RpV1 : init STM32
2018-03-08 Protocole prêt
    -> Ajout d'une fonction de synchronisation
    -> Ajout d'un code d'exemple pour raspberry
    -> Amélioration du code pour F4
    [config.txt]
2018-03-09 Schéma ESP_01
    Ajout d'une résistance pour éviter de cramer GPIO0.
    [ESP01_Upload.fzz]
2018-03-09 Schéma ESP_01
    Instructions pour le mode programmation.
    [ESP01_Upload.fzz]
2018-03-09 Client-api : correction sur la portée des variables
2018-03-10 UART : licence + header
2018-03-14 Matrices : F3
    [gdb-pipe.cfg, st_nucleo_f3.cfg, st_nucleo_f4.cfg]
2018-03-14 Mise à jour pixelbot
    * Séparation déclarations/définitions en .h/.c
    * Correction d'un bug sur les rotations/transpositions
2018-03-14 Mise à jour des sprites du panneau
    * Les sprites sont maintenant exportées dans la bonne direction.
    * Parce qu'elles l'étaient pas.
    * Du coup le code faisait mal aux yeux.
    * Mais genre vraiment.
    * En plus c'est pas optimisé.
2018-03-14 Amélioration code matrices F3
    * Les sprites sont directement lues dans le bon sens
    * Le chargement d'une ligne est fait avant réactualisation (optimise légèrement la durée d'activation des leds, donc la luminosité)
    * L'écriture d'une ligne n'utilise que des opérations binaires, hors appels HAL (réduit le temps d'écriture, donc le temps de désactivaation des leds, donc la luminosité).
2018-03-15 Correction chargement sprite
2018-03-15 Amélioration client matrice
    * Ajout d'un mode log plus détaillé
    * Prise en charge des signaux SIGTERM, SIGINT plus propre
    * Amélioration des accès à la mémoire partagée
    * Ajout d'un timeout pour renvoyer périodiquement le score
2018-03-16 z motor ok
2018-03-18 macro for motor control
2018-03-18 encoder and FC initialisation
2018-03-18 forget the poling timer
2018-03-19 test servo ok
2018-03-20 Point de détail
2018-03-20 uart connexions
2018-03-20 Debug central
    [gdb-pipe.cfg, st_nucleo_f3.cfg, st_nucleo_f4.cfg]
2018-03-21 Amélioration sprites (pour les rageux)
2018-03-21 Fix UART Axe_Z
2018-03-21 wrong prototype
2018-03-22 calibration ok
2018-03-22 the last one I hope
    [ESP.kicad_pcb, ESP.sch]
2018-03-23 Raspberry : logger & open uart
2018-03-23 Protocol : màj pour unifier les fonctions d'envoi
2018-03-23 Raspberry : boucle uart
2018-03-23 Code rasbperry : ajout de la matrice
2018-03-25 Player : lecture de répertoire
2018-03-25 Player : Fixed overflow
    [main.c, song.c]
2018-03-25 Raspberry : camera socket & leds
2018-03-25 Raspberry : communication C -> Py ok
2018-03-26 Code Raspberry
    [config.txt]
2018-03-26 Raspberry up
2018-03-26 Central : exemple raspberry
2018-03-27 raspberry : uart
2018-03-27 Raspberry : better logs
2018-03-27 Central : DMA -> LL
2018-03-29 Raspberry : camera handling and sigterm
2018-03-29 Raspberry : Logger improvements + log raw
2018-03-29 Raspberry : remote stop nucleo
2018-03-29 schéma ok
    [Audio.sch, LED.sch, Power.sch, central.kicad_pcb, central.sch]
2018-03-29 schéma ajout découplage
    [Audio.sch, LED.sch, Power.sch, central.sch]
2018-03-29 ready to route
    [Audio.sch, Power.sch, central.kicad_pcb, central.sch]
2018-03-29 smd resistor
    [Audio.sch, LED.sch, Power.sch, central.kicad_pcb, central.sch]
2018-03-29 Central : placement
    [central.kicad_pcb]
2018-03-30 Central routage
    [central.kicad_pcb]
2018-03-30 Raspberry up
    + Fix logs
    + Fix camera
    + send asser
    + sigint nucleo
    + blink end
    [camera.c, camera.py, logger.c, main.c, main.h, player.c]
2018-04-02 servitude in interruptions
2018-04-02 Correction UART Axe Z
    [main.c, robotronik_protocol.c, robotronik_protocol.h, usart.c, usart.h]
2018-04-02 Raspberry asser
2018-04-03 Up Z Axis
2018-04-06 UART server configured
2018-04-12 servo ar ok
2018-04-14 interplation beginning
    [points.csv]
2018-04-14 ready for stm32
    [points.csv, points2.csv]
2018-04-15 just add the link to the pid
2018-04-23 dimension modif
    [support_balise_haut.fcstd]
2018-04-24 encoder tested
2018-04-25 Materialize obstacle
2018-04-26 PID regle
2018-05-01 little modif before changes
    [config.txt]
2018-05-05 Central : avoid robot
    [gas.c, gas.h, map.c, map.h, obstacle.c, obstacle.h]
2018-05-06 initi pos and correct backward bug
    [fsm_position_abs.c, main.c, odometry.c, server.c]
2018-05-08 Fix raspberry
2018-05-09 Raspberry : disable send asser'
2018-05-09 Correction de cette putain de tirette de ses morts, cordialement
    [Central.ioc, main.c]
2018-05-09 Le clean de ses morts
2018-05-09 Interruption TIM3
